FrauBluher/ShR2/Hardware/Images/rer.jpg

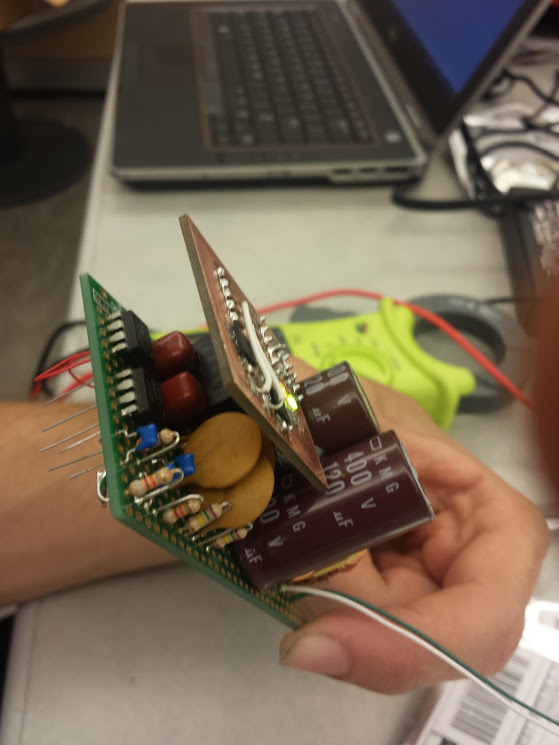
Hardware/Images/rer.jpg
