FrauBluher/ShR2/Hardware/Images/2014-04-14.jpg

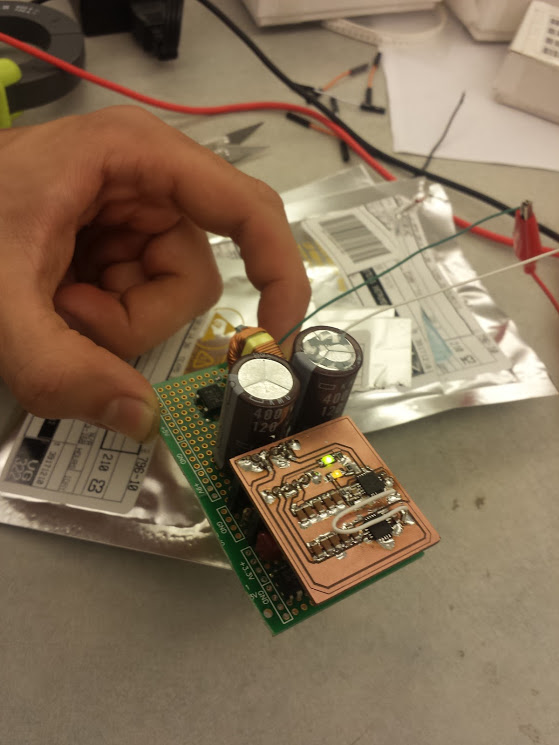
Hardware/Images/2014-04-14.jpg
