FrauBluher/ShR2/README.md

ShR2
====

A redesign of the SHEMP system with a focus on high-bandwidth data acquisition.

Design information and supporting documentation can be found in this repository.
