FrauBluher/ShR2/F28377D/README.md

F28377D projects
Note: these assume that you install the F28377D Samples (see Hardware folder)
to /opt/ti
