FrauBluher/ShR2/F28377D/base/README.md

Base project for F28377D

CPU1:
Prints Hello UART via the USB UART every 500ms.
Mirrors what it receives from the UART. 

CPU2:
Blinks the on-board LEDs alternating which one is on every 250ms.
