FrauBluher/ShR2/Hardware/Filtering/AnalogFilteringReview/README

I've included some useful application notes which
give a very nice discussion and overview of filtering
methods and how they behave in real world applications,
if you feel as though you need a quick brush-up.

-Pavlo Manovi
