FrauBluher/ShR2/ESP8266/ESP8266_SDK/uart_rxtx_PROJECT/README.md

Steps to compile, and flash this program on the ESP8266:

1. ./gen_misc to compile
2. ./upload_flash.sh to flash device
