FrauBluher/ShR2/ESP8266/Server_Transmission_Notes/Wifi State Machine.bmp

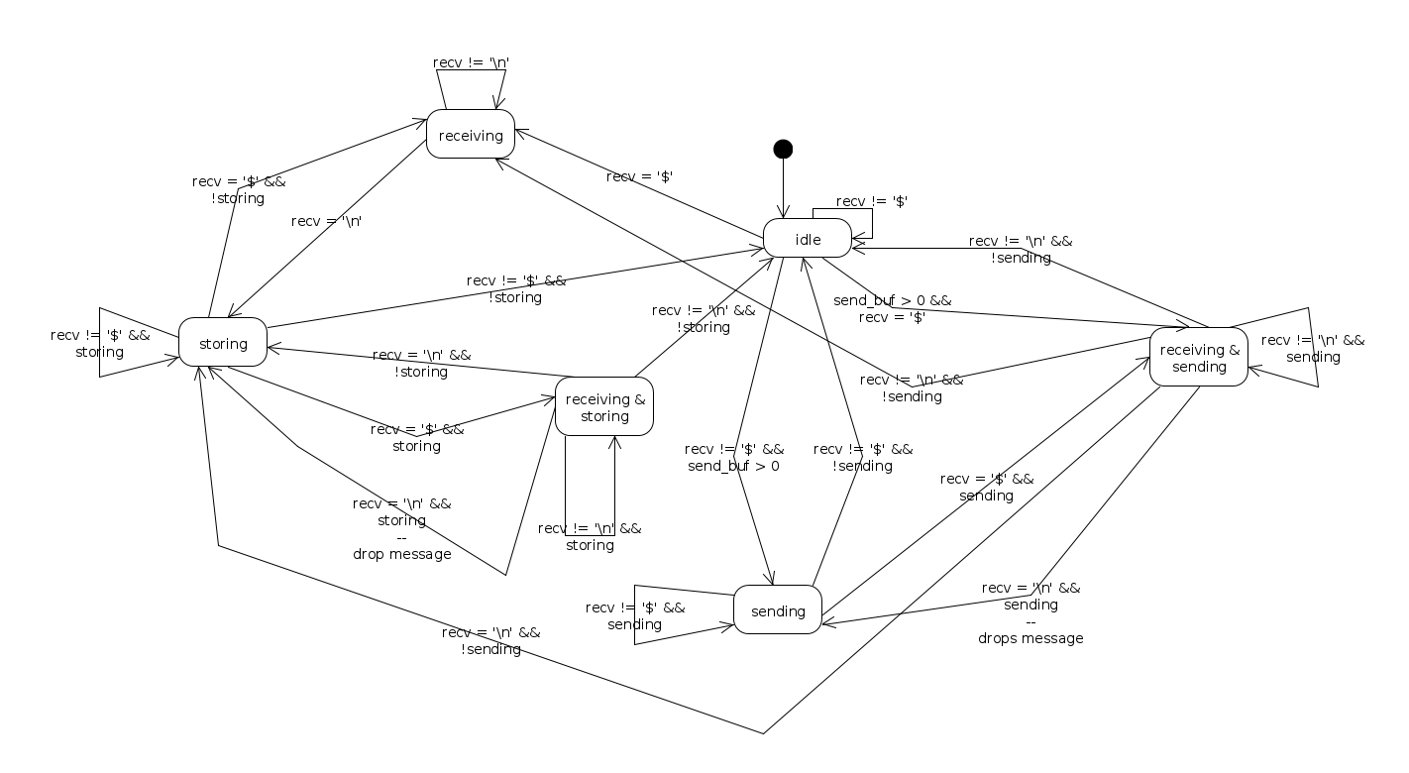
ESP8266/Server_Transmission_Notes/Wifi State Machine.bmp
