FrauBluher/ShR2/Hardware/Filtering/SPICE Simulations/Frequency and Phase Response.png

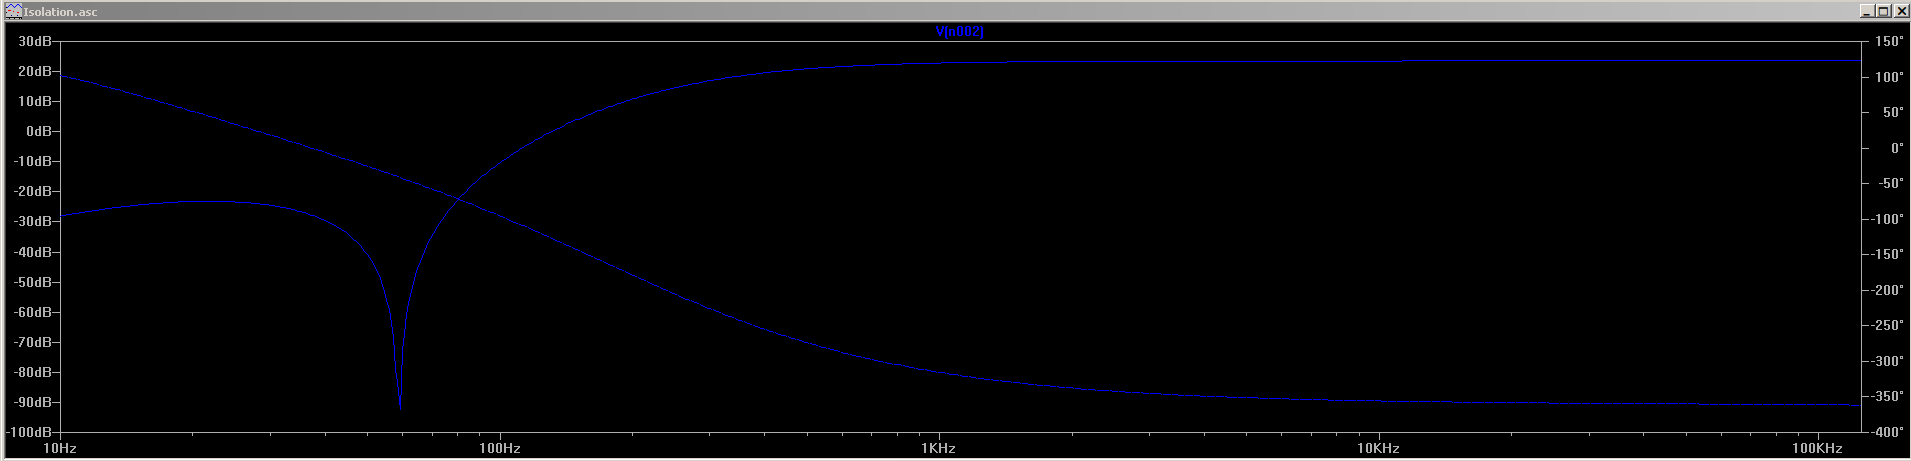
Hardware/Filtering/SPICE Simulations/Frequency and Phase Response.png
