FrauBluher/ShR2/Hardware/Images/ADCAnalysis_01.png

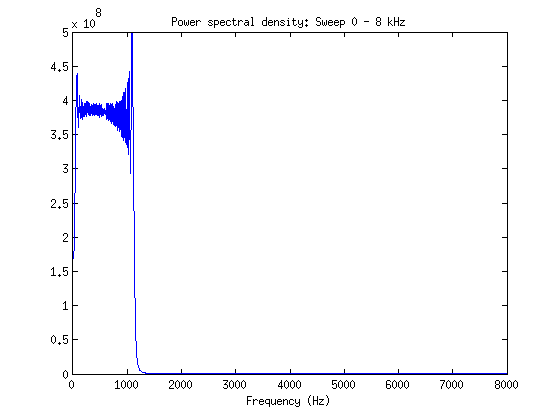
Hardware/Images/ADCAnalysis_01.png
