FrauBluher/ShR2/Hardware/Images/ADCAnalysis_03.png

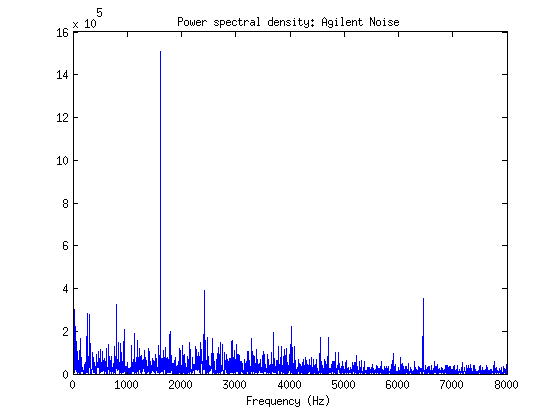
Hardware/Images/ADCAnalysis_03.png
