FrauBluher/ShR2/Hardware/Images/ADCBreakout.png

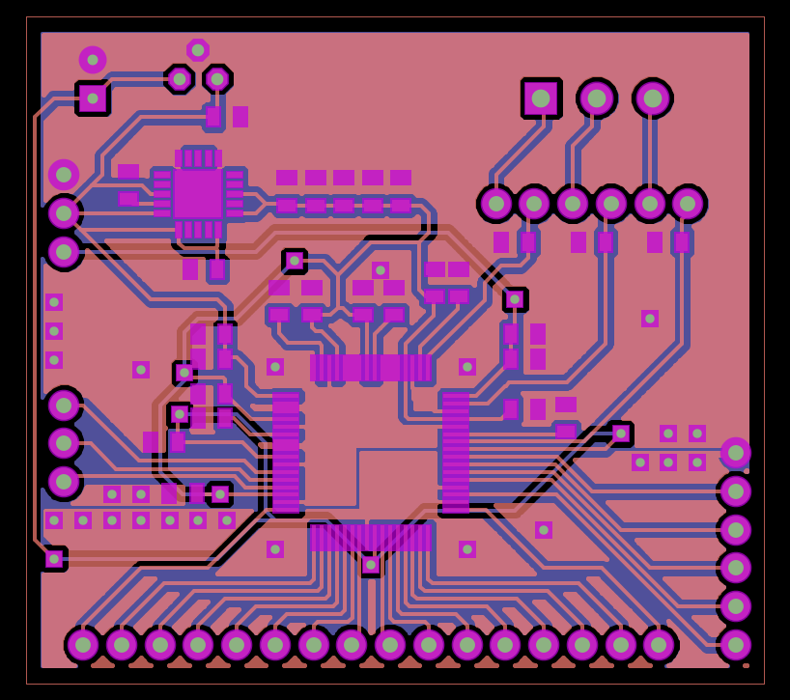
Hardware/Images/ADCBreakout.png
