FrauBluher/ShR2/Hardware/Images/ADCModule.png

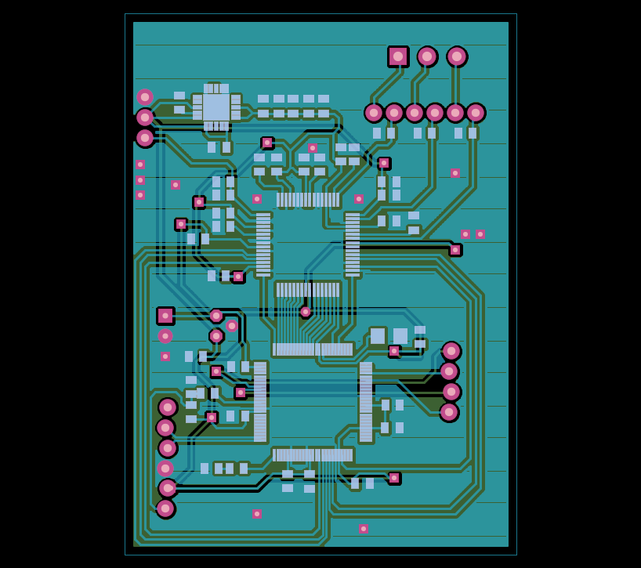
Hardware/Images/ADCModule.png
