FrauBluher/ShR2/Hardware/Images/CTExWork/SampledCTData.png

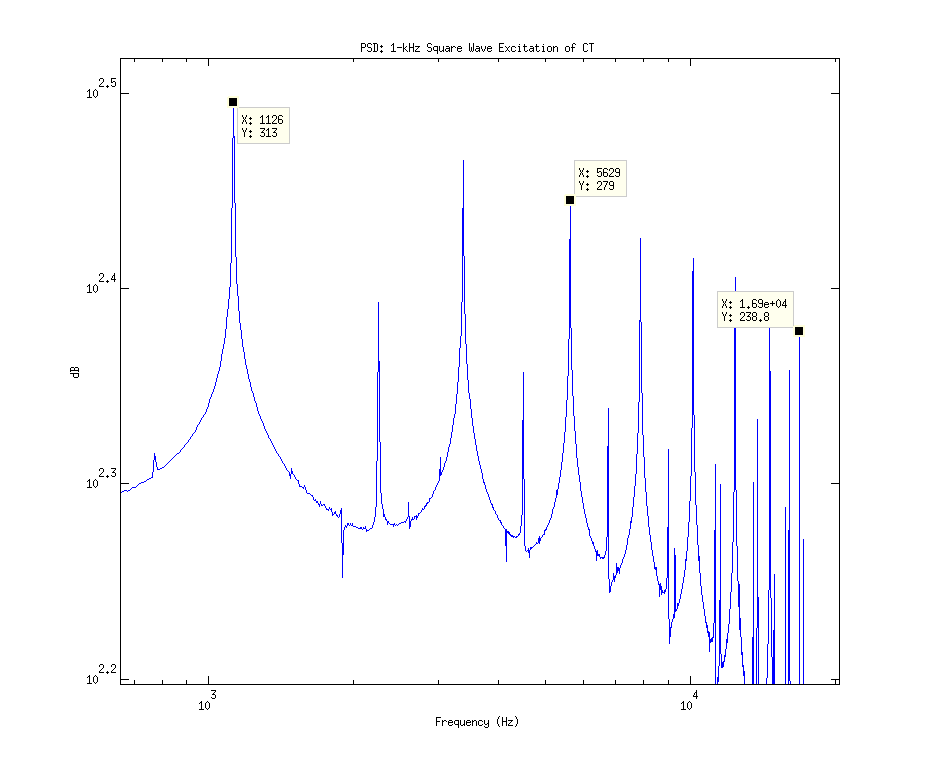
Hardware/Images/CTExWork/SampledCTData.png
