FrauBluher/ShR2/Hardware/Images/CTExWork/SquareSweep.png

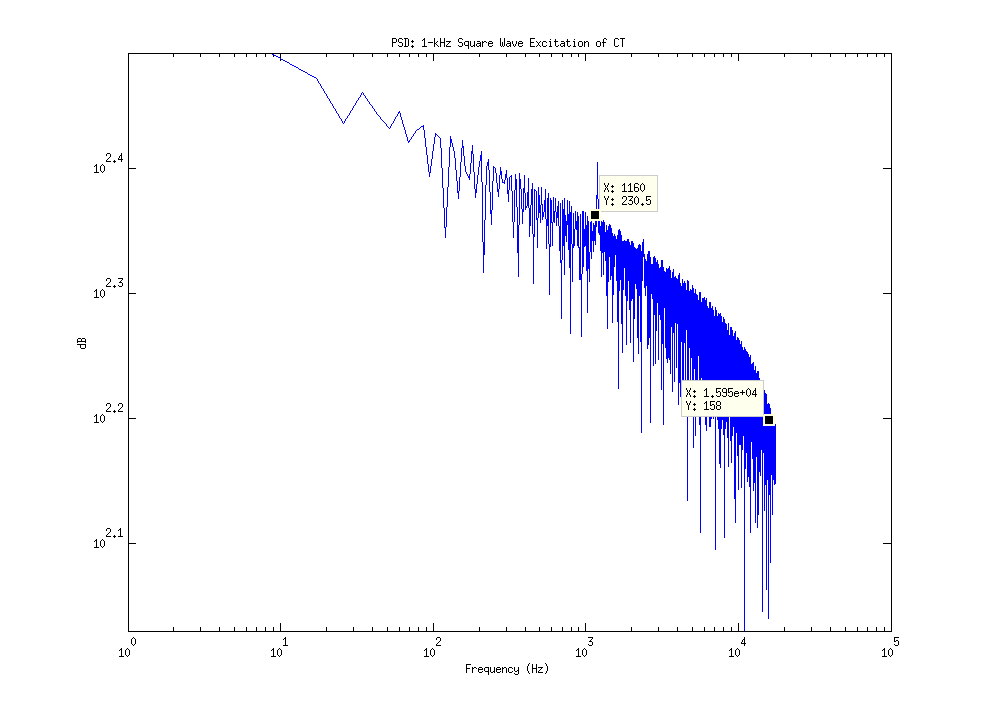
Hardware/Images/CTExWork/SquareSweep.png
