FrauBluher/ShR2/Hardware/Images/CTExWork/SquareSweepFast.png

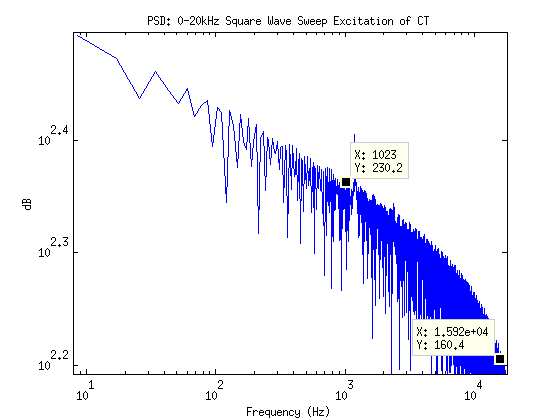
Hardware/Images/CTExWork/SquareSweepFast.png
