FrauBluher/ShR2/Hardware/Images/CTExWork/tek00000.png

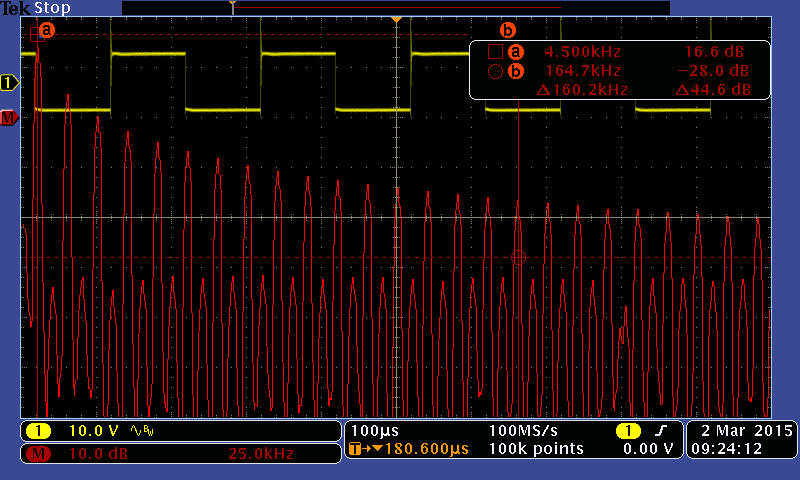
Hardware/Images/CTExWork/tek00000.png
