FrauBluher/ShR2/Hardware/Images/CTExWork/tek0000.png

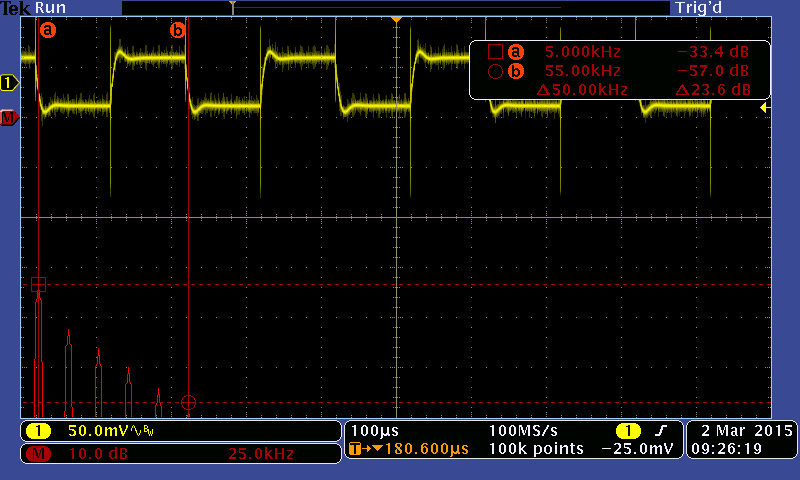
Hardware/Images/CTExWork/tek0000.png
