FrauBluher/ShR2/Hardware/Images/CTExWork/tek00002.png

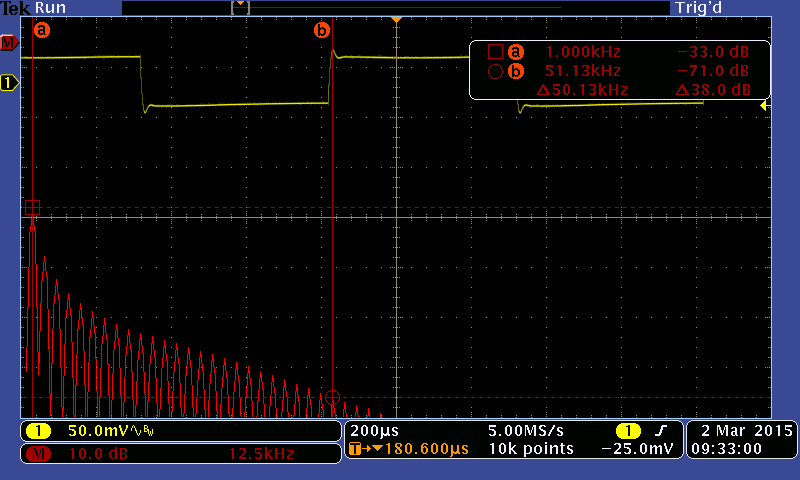
Hardware/Images/CTExWork/tek00002.png
