FrauBluher/ShR2/Hardware/Images/CTExWork/tek00003.png

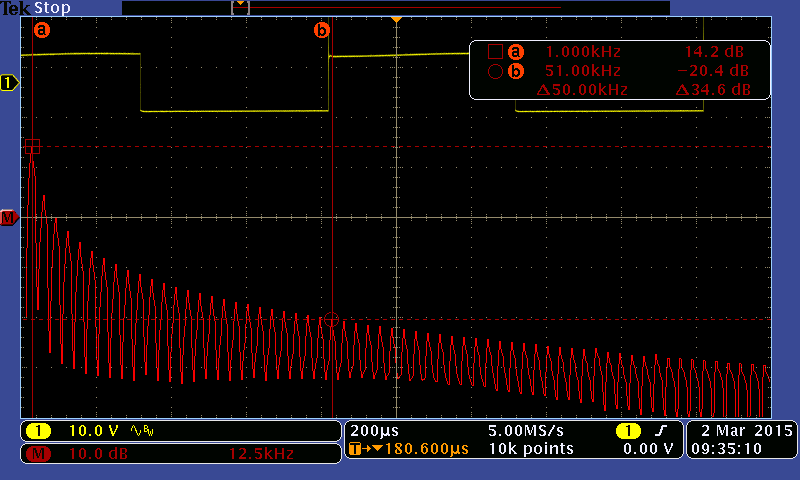
Hardware/Images/CTExWork/tek00003.png
