FrauBluher/ShR2/Hardware/Images/oscillator.png

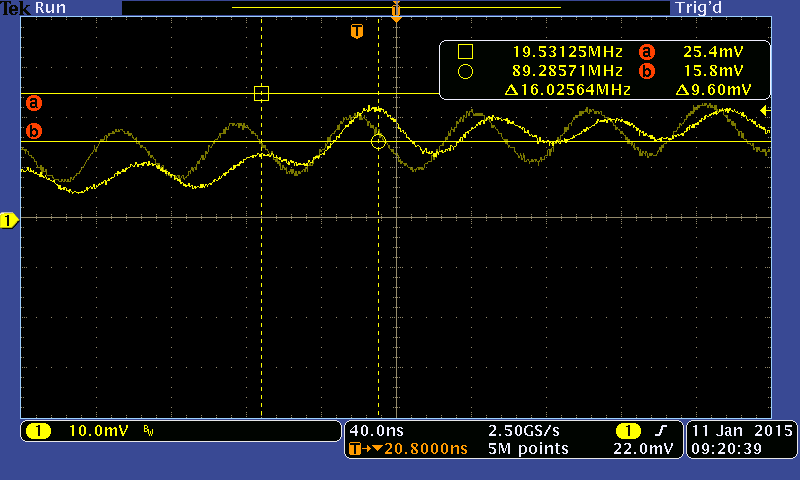
Hardware/Images/oscillator.png
