FrauBluher/ShR2/Hardware/Images/PowerSupply.png

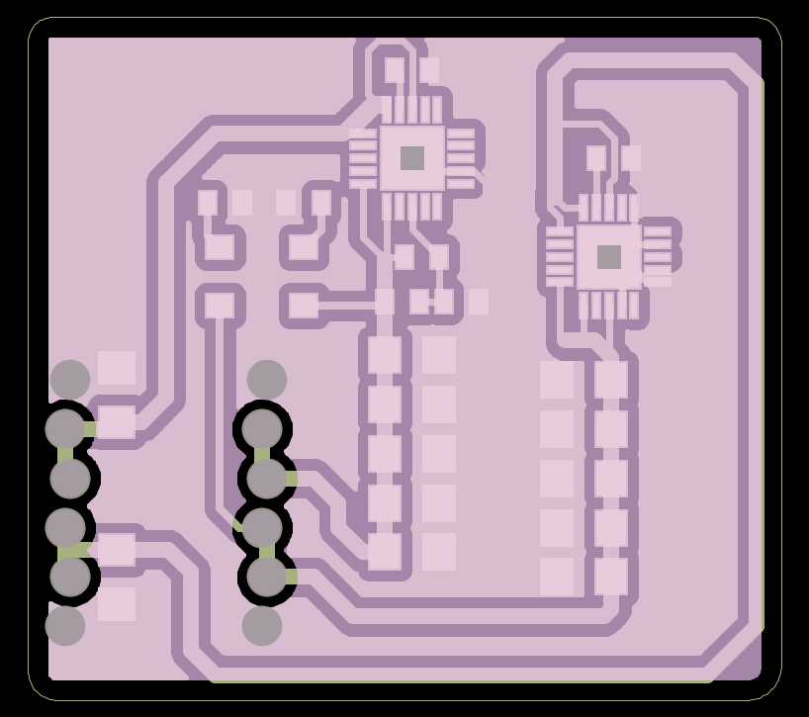
Hardware/Images/PowerSupply.png
