FrauBluher/ShR2/Hardware/Images/spi.png

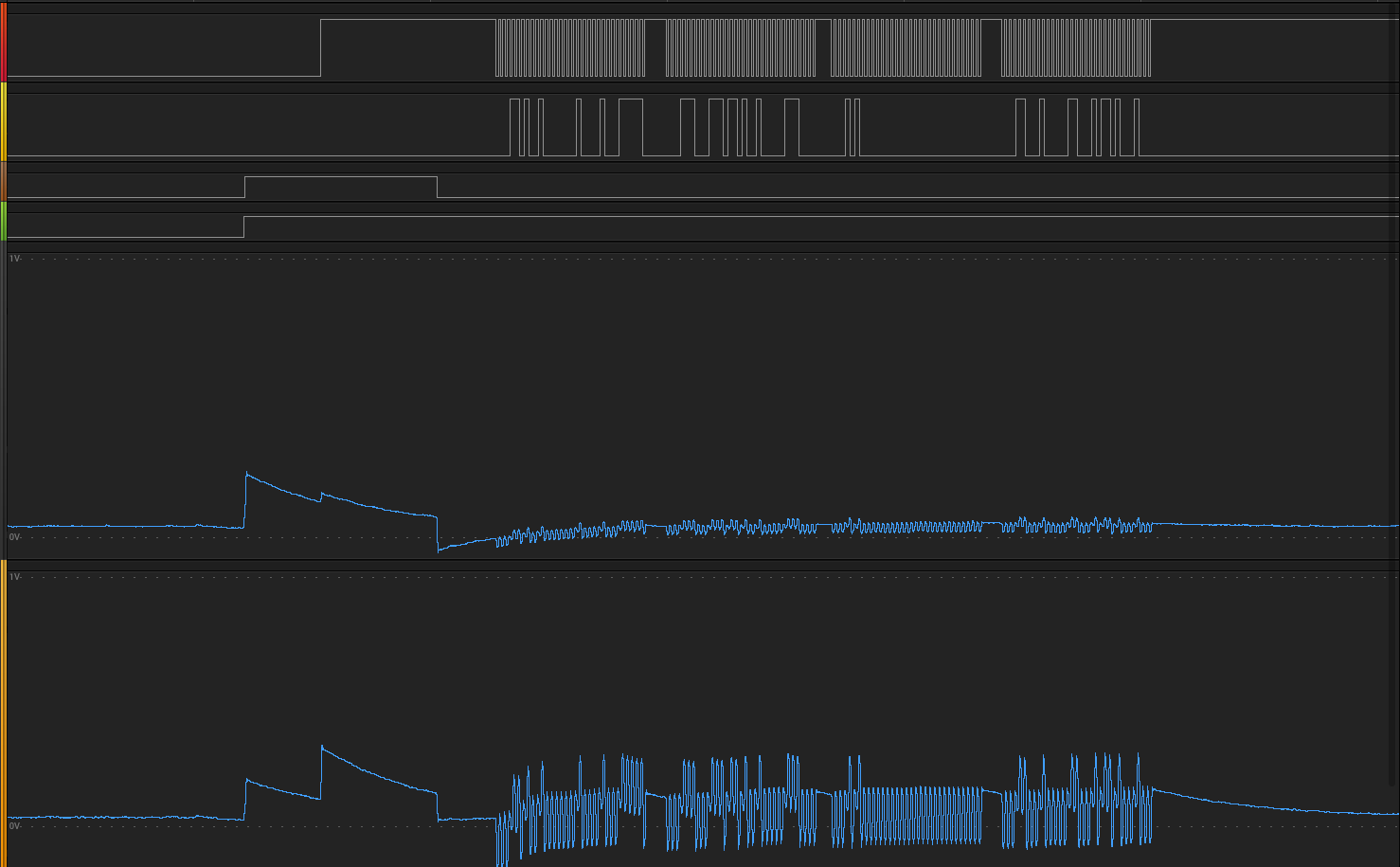
Hardware/Images/spi.png
