FrauBluher/ShR2/Hardware/Images/spisniff1.png

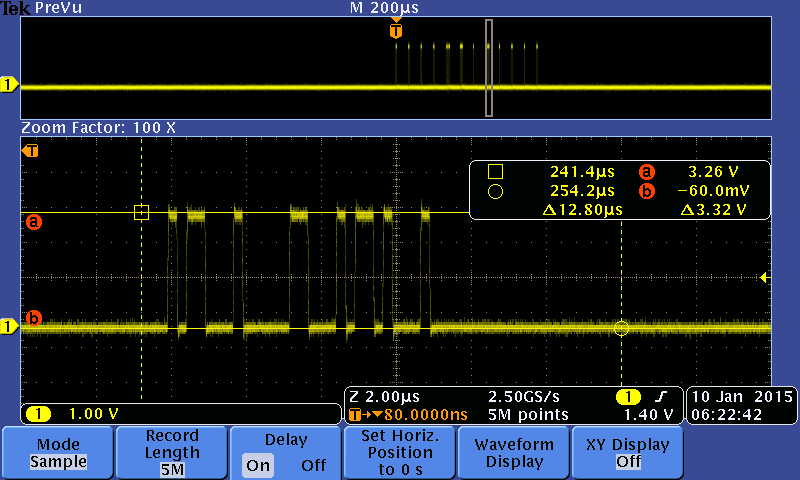
Hardware/Images/spisniff1.png
