FrauBluher/ShR2/Hardware/Images/spisniff2.png

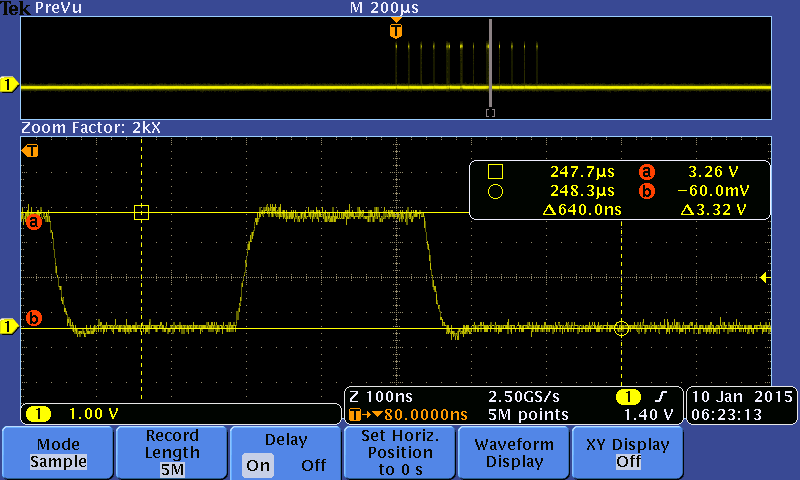
Hardware/Images/spisniff2.png
