FrauBluher/ShR2/Hardware/Images/working.png

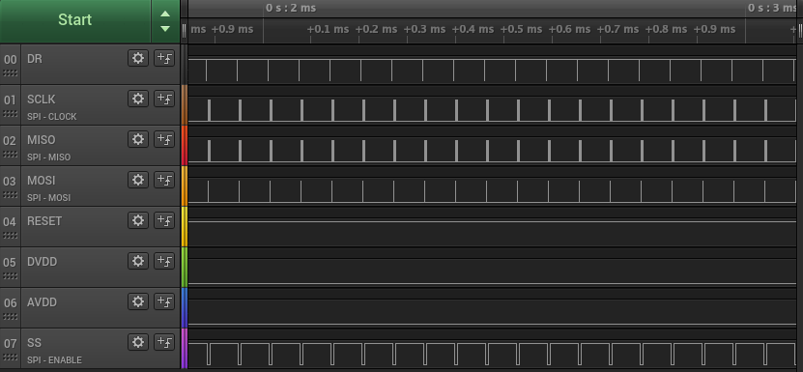
Hardware/Images/working.png
