FrauBluher/ShR2/Hardware/PIC32 Based Hardware/Datasheets/BCRord6.jpg

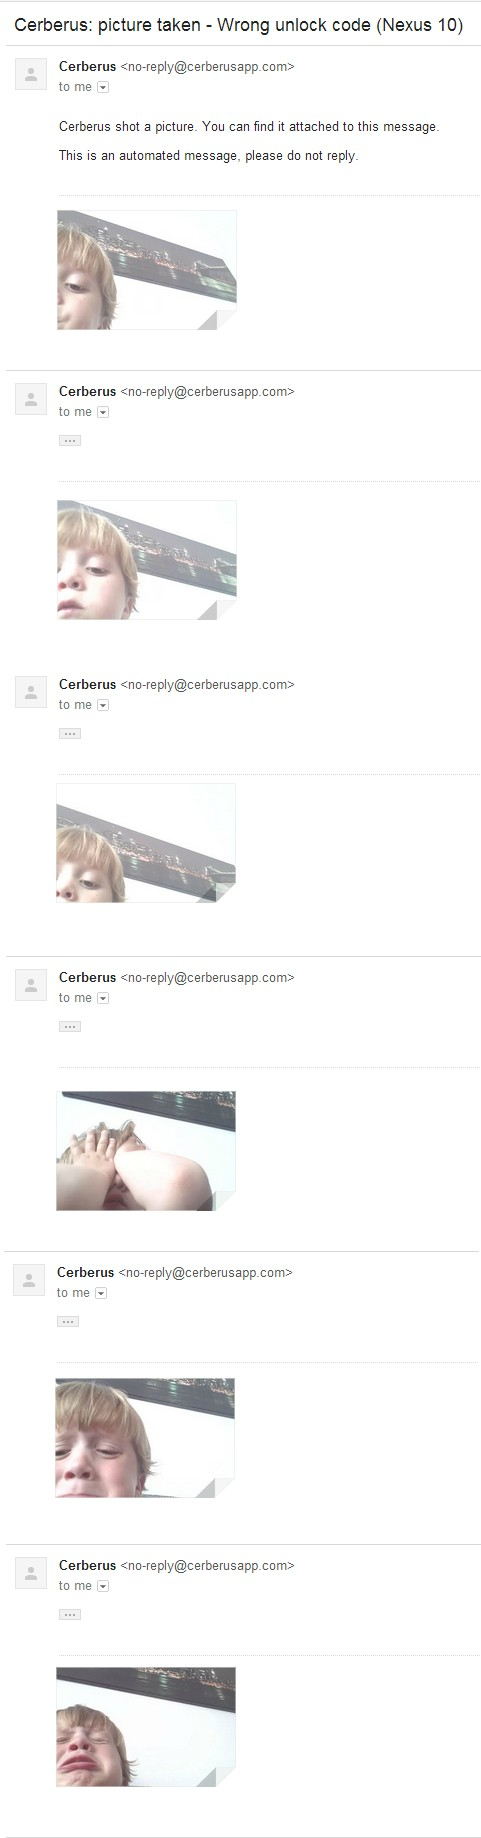
Hardware/PIC32 Based Hardware/Datasheets/BCRord6.jpg
