FrauBluher/ShR2/Hardware/PIC32 Based Hardware/Datasheets/GfTWLOs.png

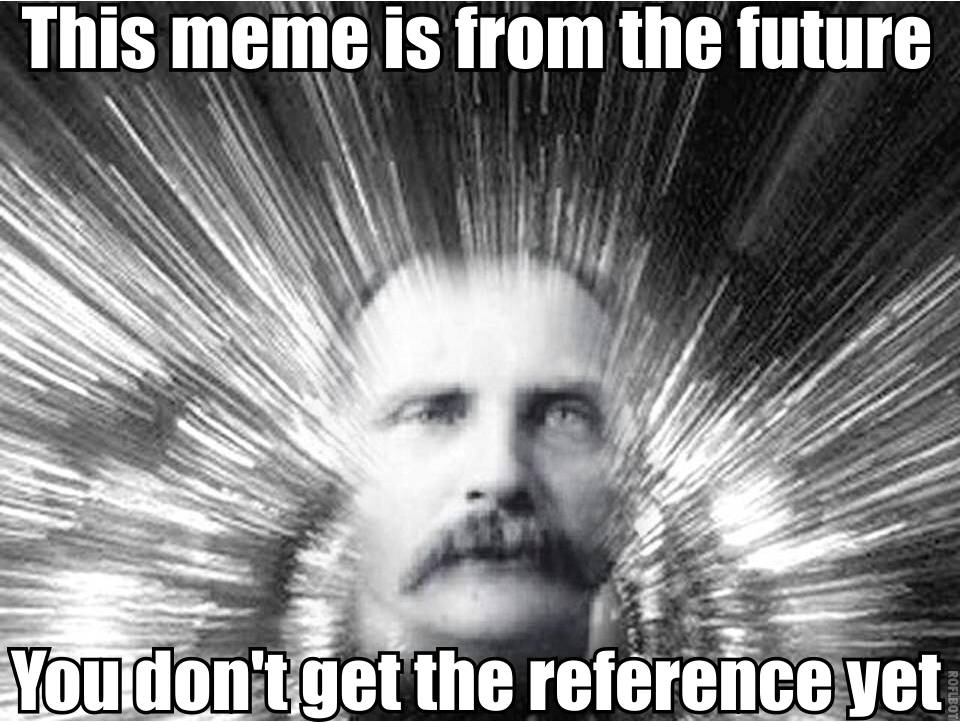
Hardware/PIC32 Based Hardware/Datasheets/GfTWLOs.png
