FrauBluher/ShR2/SEADS 3D Stuff/Quarter/50_states_quarter_obv_large.jpg

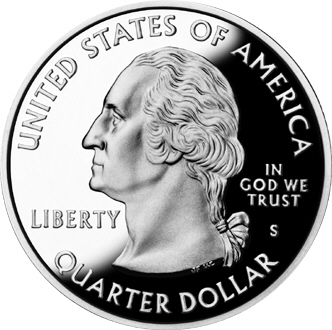
SEADS 3D Stuff/Quarter/50_states_quarter_obv_large.jpg
