FrauBluher/ShR2/SEADS 3D Stuff/Quarter/600px-Colorado_quarter,_reverse_side,_2006.jpg

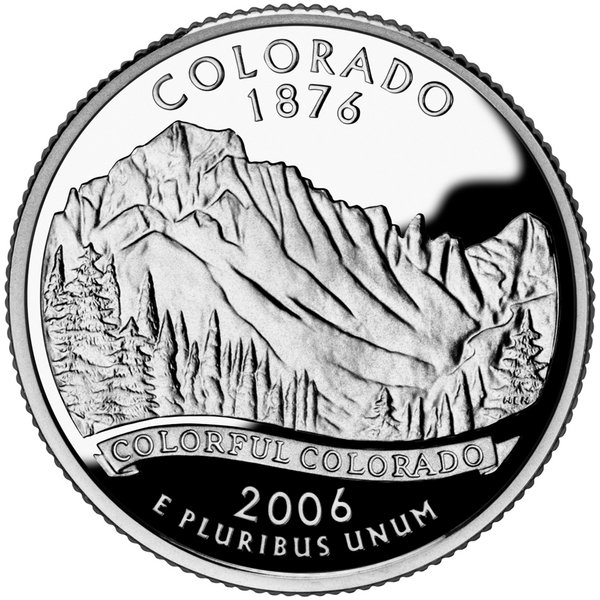
SEADS 3D Stuff/Quarter/600px-Colorado_quarter,_reverse_side,_2006.jpg
