FrauBluher/ShR2/SEADS 3D Stuff/Renders/sead.png

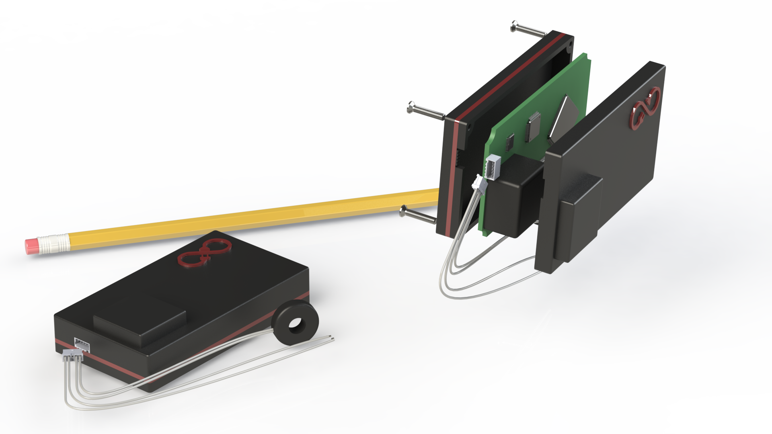
SEADS 3D Stuff/Renders/sead.png
