FrauBluher/ShR2/SEADS 3D Stuff/Renders/seadsThink.JPG

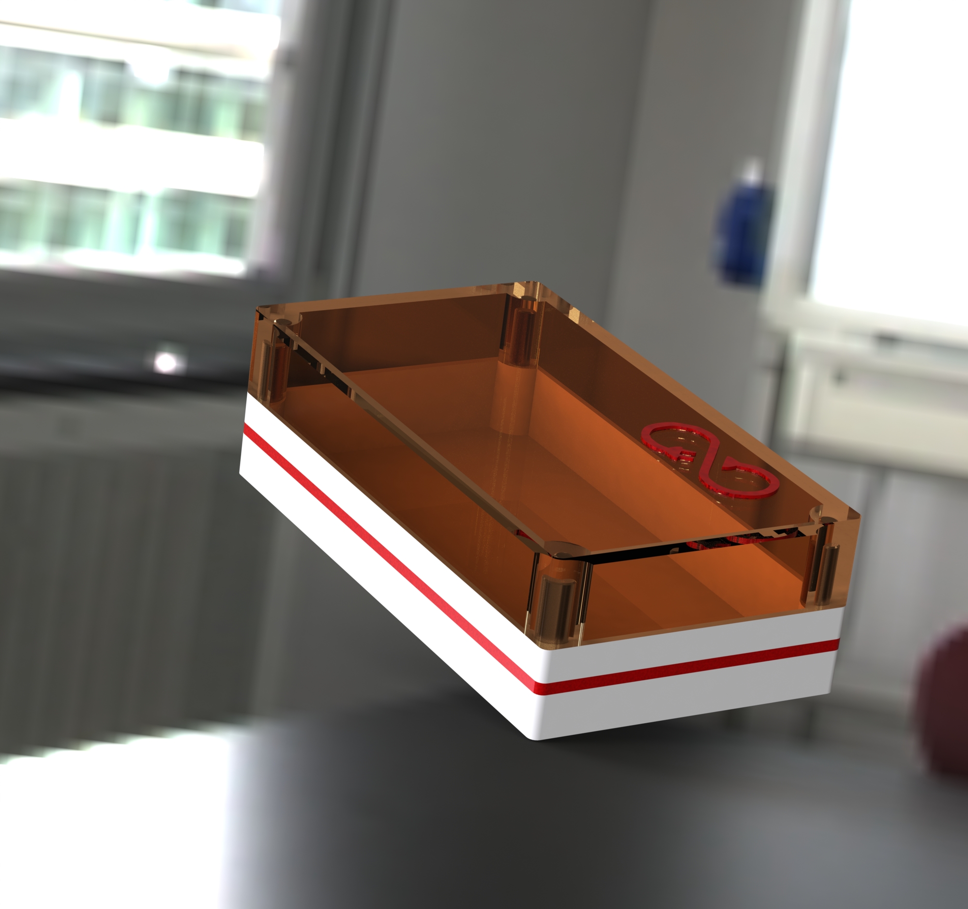
SEADS 3D Stuff/Renders/seadsThink.JPG
