FrauBluher/ShR2/Web Stack/outfile.png

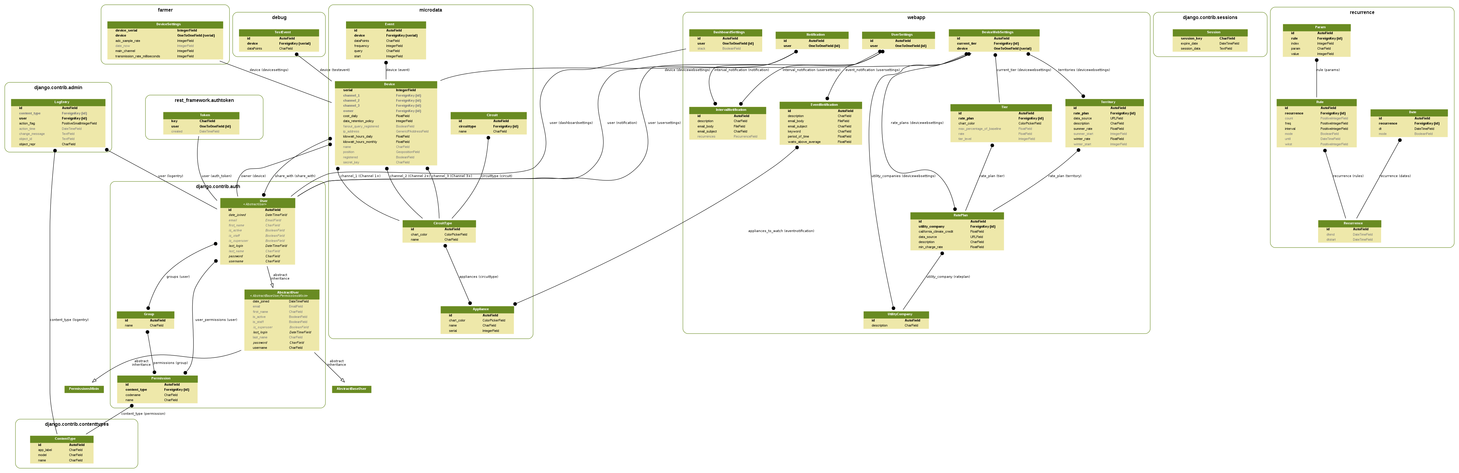
Web Stack/outfile.png
