FrauBluher/ShR2/Project Files/281-budget.xlsx

Quarter A |  |  |  | Quarter B, C
Estimated Budget | $1,253.60 |  | Members |  |  |  | Actual Total |  | 20.95
 |  |  | Henry Crute
 |  |  | Pavlo Manovi
Funding Sources | Amount |  | Bryan Smith | Amount Used | Remaining
CITRIS | $853.60 |  | AJ Ringer | $- | #VALUE!
Individual | 400 |  |  | $- | #VALUE!
 |  |  |  | $- | #VALUE!
Total Funds | $1,253.60 |  |  | $- | $1,253.60
Item Description | PPU | QTY | Estimated Cost | Funding Source | Date | Purchaser | A QTY | Actual Cost | Notes
PCB Runs | 150 | 4 | 600 | CITRIS
Passive Circuit Components | 150 | 1 | 150 | CITRIS
ESP8266 | 5 | 5 | 25 | Individual | 2015-01-06 | Henry | 6 | 20.95
Mounting Hardware | 15 | 1 | 15 | Individual
3d printing filament | 20 | 1 | 20 | CITRIS
Amazon EC2 Server for 1 hour | 0.14 | 240 | 33.6 | CITRIS
Delfino Dual Core DSP | 25 | 3 | 75 | Individual
AC/DC Regulation Components | 100 | 1 | 100 | CITRIS
Current Transformers | 5 | 12 | 60 | CITRIS
Demonstration Hardware (Conduits, Wiring, Etc.) | 75 | 1 | 75 | CITRIS
AC/AC Isolation Transformers | 100 | 1 | 100 | CITRIS
 |  |  |  | Totals | User | Amount
