FrauBluher/ShR2/SEADS 3D Stuff/Case/For Rendering.SLDASM

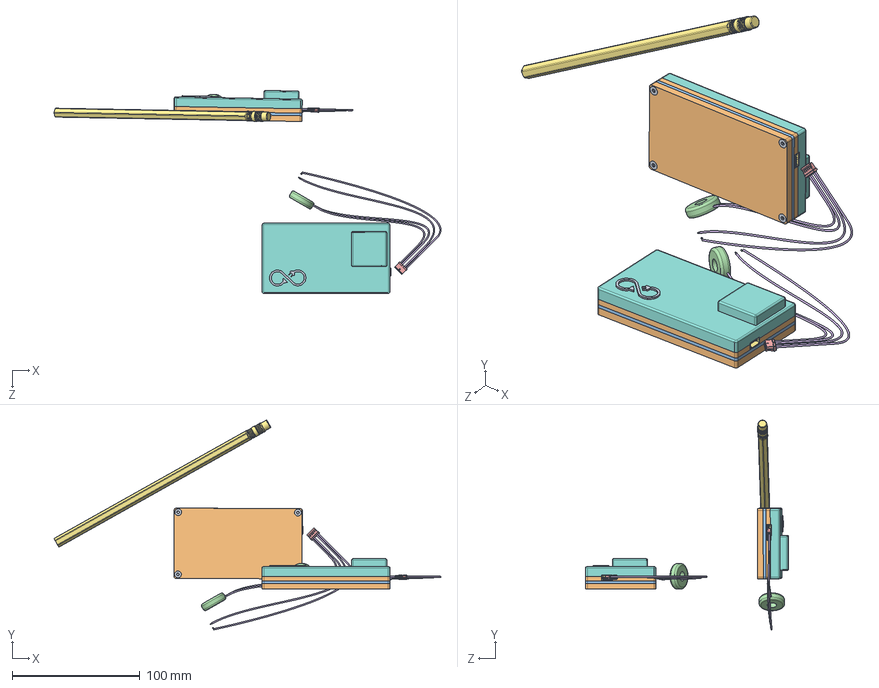
[picture p32: CAD file, 2015-01-21]
SEADS 3D Stuff/Case/For Rendering.SLDASM
302.7 x 164.1 x 158.8 mm
socket countersunk head screw_am x 8
PCB x 2
AC_DC x 2
BODY_VNG144A x 2
LEAD_VNG144A x 288
BODY_VEH64A x 2
LEAD_VEH64A x 128
BODY_MTC20 x 2
LEAD_MTC20 x 40
BODY_MXA28A x 2
LEAD_MXA28A x 56
BODY_TS5B x 2
HTSINK_TS5B x 2
LEAD_TS5B x 10
CaseTop x 2
SeadsLogo x 2
CaseBottom x 2
Case Trim x 2
CTTorus x 2
Cable_1^Electrical_9-CaseAssembly x 2
