FrauBluher/ShR2/SEADS 3D Stuff/CTAssem.SLDASM

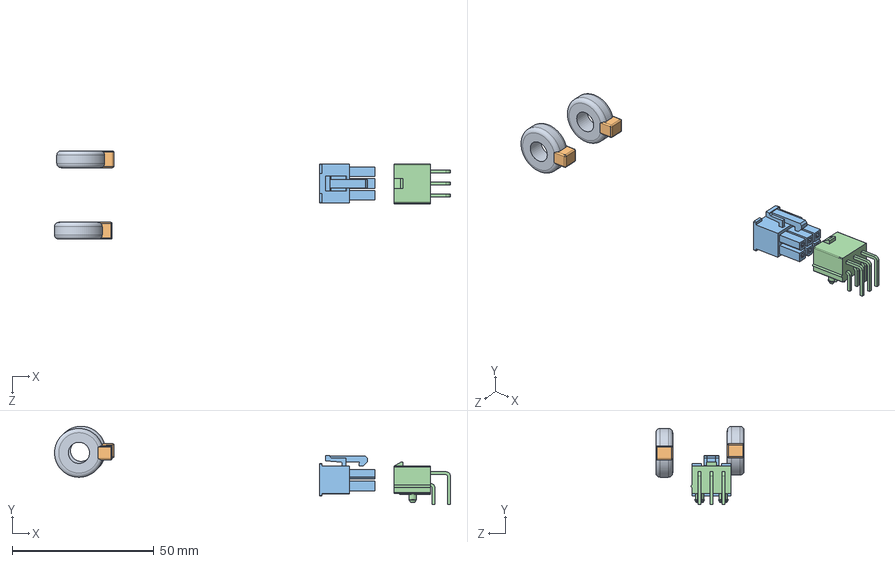
[picture p33: CAD file, 2015-01-21]
SEADS 3D Stuff/CTAssem.SLDASM
139.8 x 27.7 x 31.2 mm
CTTorus x 2
CTBlock x 2
