FrauBluher/ShR2/SEADS 3D Stuff/Case/PM0064A.SLDASM

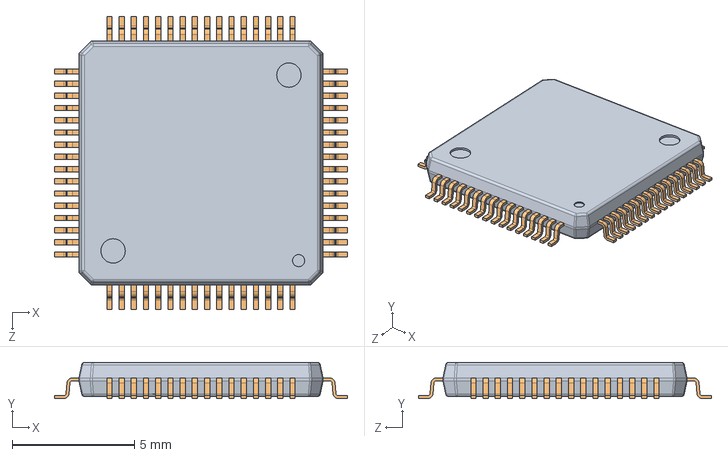
[picture p34: CAD file, 2015-01-21]
SEADS 3D Stuff/Case/PM0064A.SLDASM
12.0 x 1.49 x 12.0 mm
BODY_VEH64A
LEAD_VEH64A x 64
