FrauBluher/ShR2/SEADS 3D Stuff/Case/KTT0005B.SLDASM

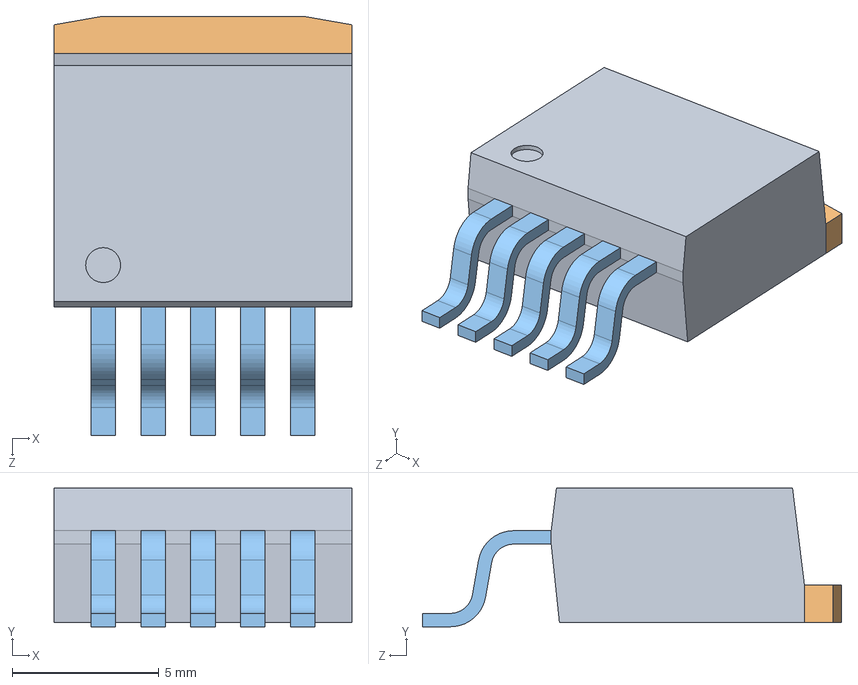
[picture p35: CAD file, 2015-01-21]
SEADS 3D Stuff/Case/KTT0005B.SLDASM
10.2 x 4.72 x 14.3 mm
BODY_TS5B
HTSINK_TS5B
LEAD_TS5B x 5
