FrauBluher/ShR2/SEADS 3D Stuff/Case/PGE0144A.SLDASM

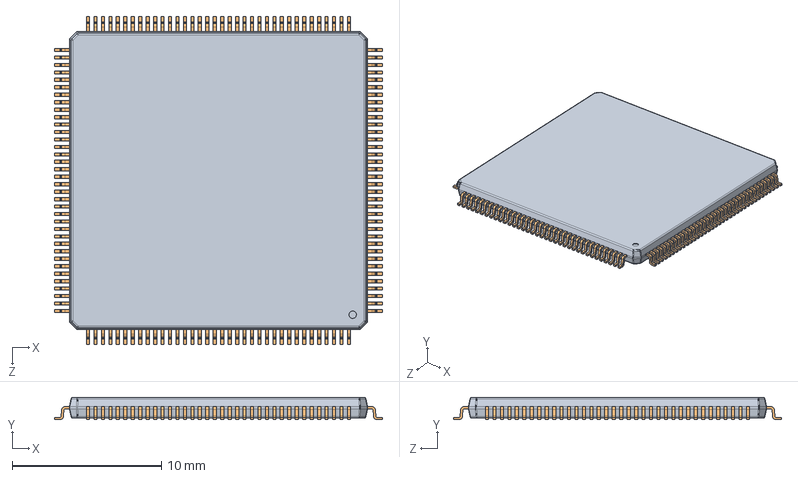
[picture p36: CAD file, 2015-01-21]
SEADS 3D Stuff/Case/PGE0144A.SLDASM
22.0 x 1.50 x 22.0 mm
BODY_VNG144A
LEAD_VNG144A x 144
