FrauBluher/ShR2/SEADS 3D Stuff/Case/PWP0028A.SLDASM

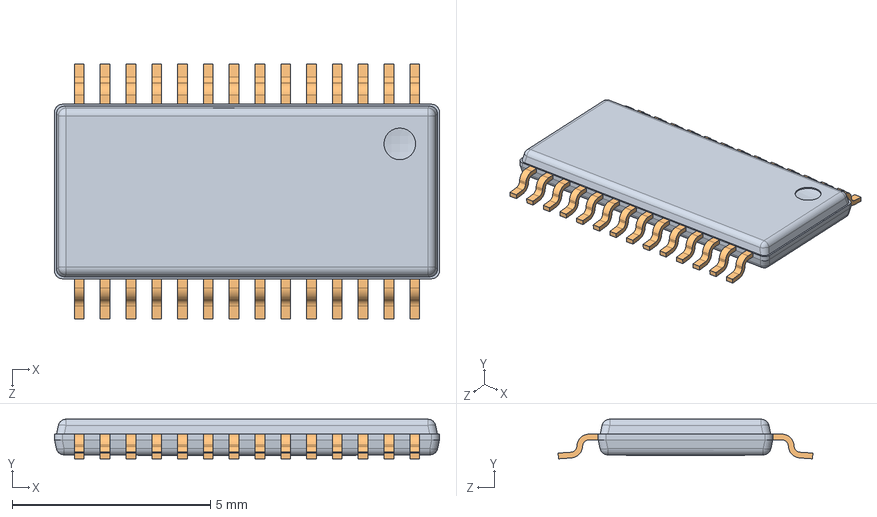
[picture p37: CAD file, 2015-01-21]
SEADS 3D Stuff/Case/PWP0028A.SLDASM
9.70 x 1.00 x 6.42 mm
BODY_MXA28A
LEAD_MXA28A x 28
