FrauBluher/ShR2/SEADS 3D Stuff/Case/PW0020A.SLDASM

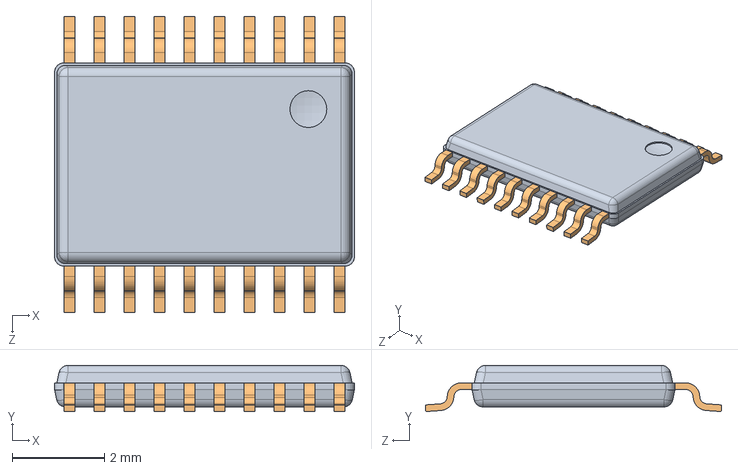
[picture p38: CAD file, 2015-01-21]
SEADS 3D Stuff/Case/PW0020A.SLDASM
6.50 x 1.00 x 6.42 mm
BODY_MTC20
LEAD_MTC20 x 20
