FrauBluher/ShR2/SEADS 3D Stuff/Case/CaseAssembly.SLDASM

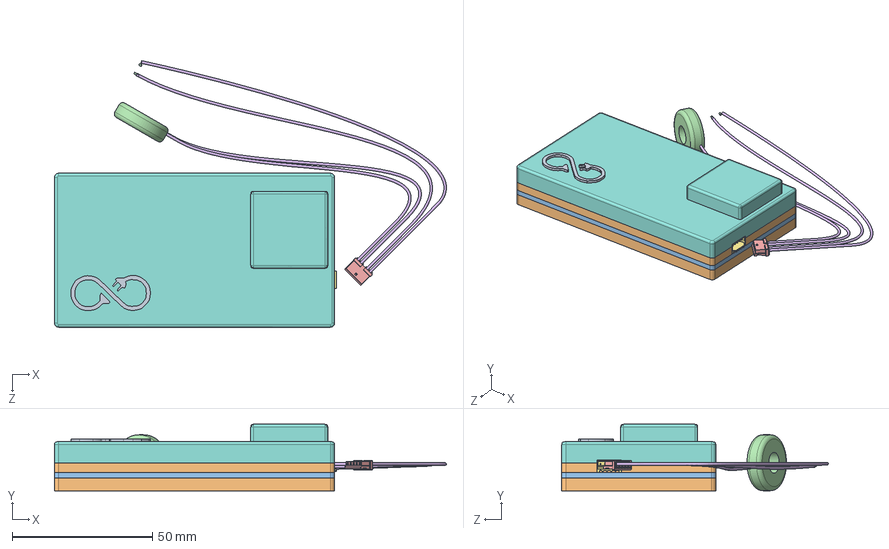
[picture p39: CAD file, 2015-01-21]
SEADS 3D Stuff/Case/CaseAssembly.SLDASM
139.9 x 23.8 x 95.1 mm
socket countersunk head screw_am x 4
PCB
AC_DC
BODY_VNG144A
LEAD_VNG144A x 144
BODY_VEH64A
LEAD_VEH64A x 64
BODY_MTC20
LEAD_MTC20 x 20
BODY_MXA28A
LEAD_MXA28A x 28
BODY_TS5B
HTSINK_TS5B
LEAD_TS5B x 5
CaseTop
SeadsLogo
CaseBottom
Case Trim
CTTorus
Cable_1^Electrical_9-CaseAssembly
