FrauBluher/ShR2/SEADS 3D Stuff/Quarter/US Quarter.SLDPRT

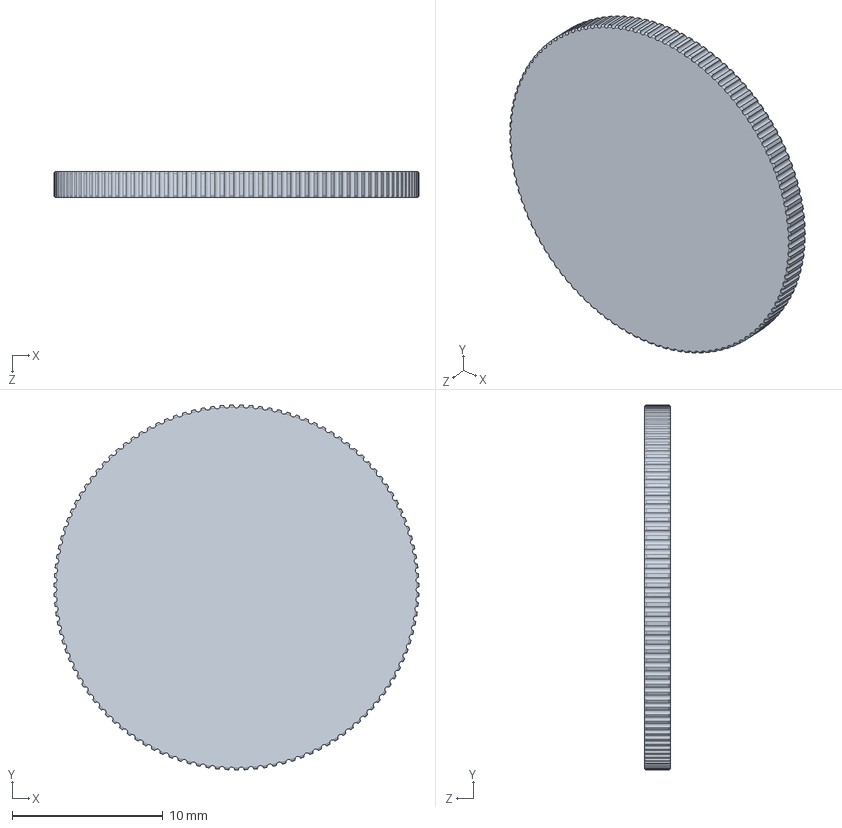
[picture p40: CAD file, 2015-01-21]
SEADS 3D Stuff/Quarter/US Quarter.SLDPRT
24.2 x 24.2 x 1.73 mm
