FrauBluher/ShR2/SEADS 3D Stuff/PCB.SLDPRT

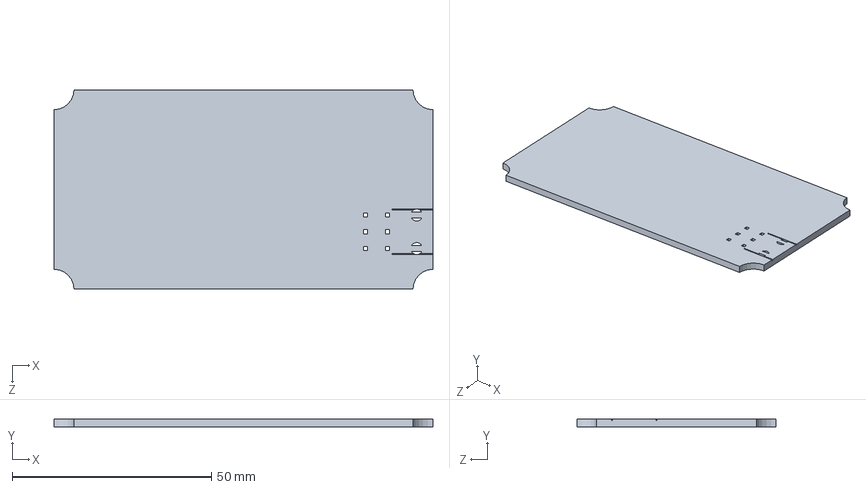
[picture p41: CAD file, 2015-01-21]
SEADS 3D Stuff/PCB.SLDPRT
95.0 x 2.00 x 50.0 mm
