FrauBluher/ShR2/SEADS 3D Stuff/Wood Pencil- Unsharpened.SLDPRT

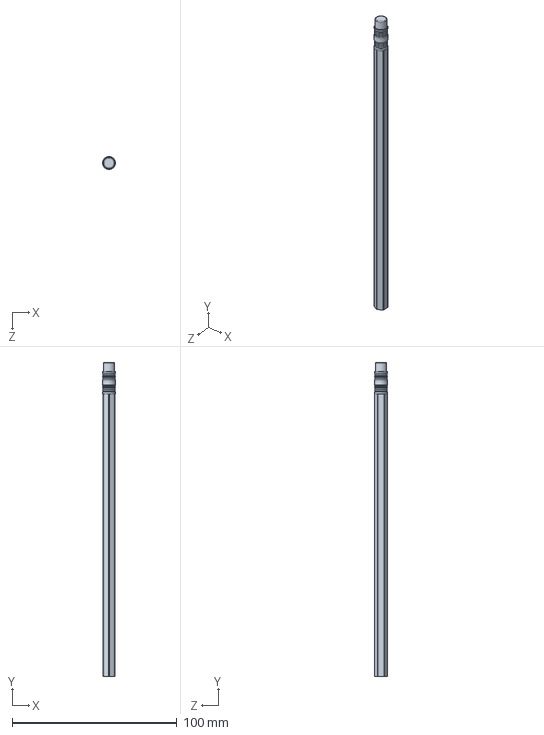
[picture p42: CAD file, 2015-01-21]
SEADS 3D Stuff/Wood Pencil- Unsharpened.SLDPRT
7.87 x 190.5 x 7.87 mm
