FrauBluher/ShR2/SEADS 3D Stuff/CTTorus.SLDPRT

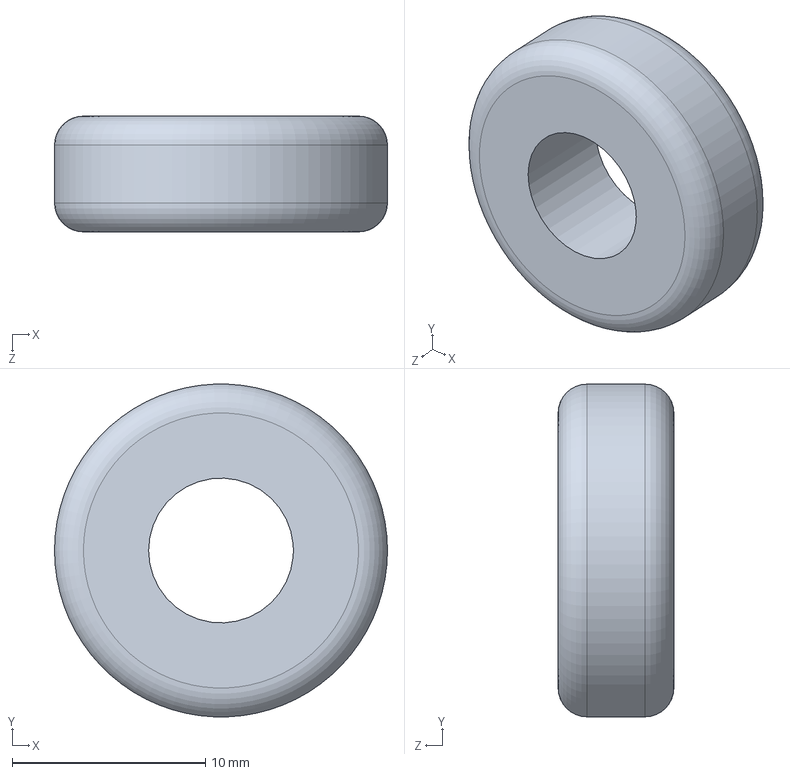
[picture p43: CAD file, 2015-01-21]
SEADS 3D Stuff/CTTorus.SLDPRT
17.2 x 17.2 x 6.00 mm
