FrauBluher/ShR2/SEADS 3D Stuff/AC_DC.SLDPRT

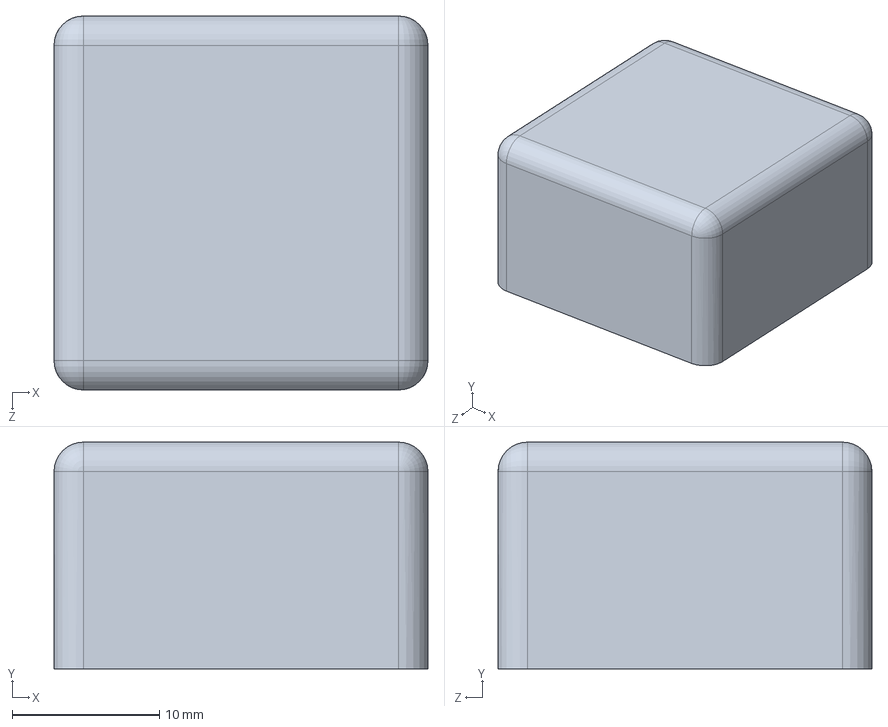
[picture p44: CAD file, 2015-01-21]
SEADS 3D Stuff/AC_DC.SLDPRT
25.4 x 15.4 x 25.4 mm
