FrauBluher/ShR2/SEADS 3D Stuff/CTBlock.SLDPRT

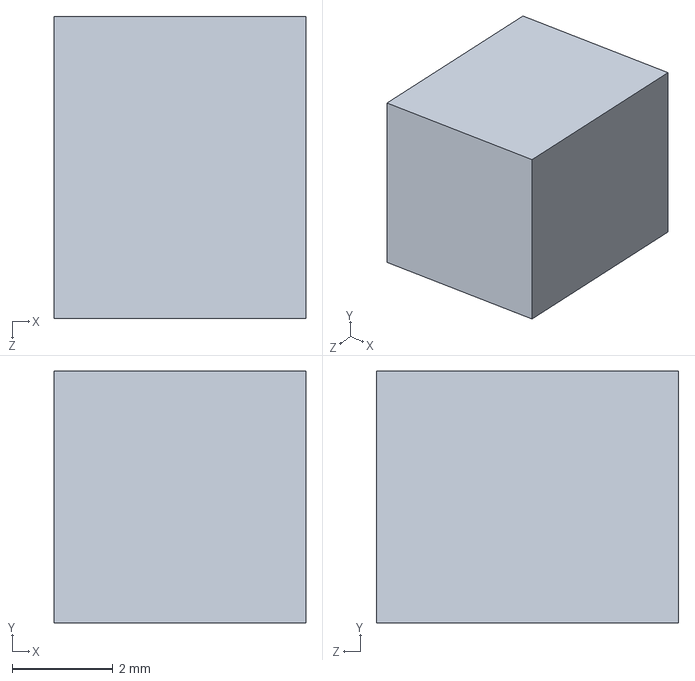
[picture p45: CAD file, 2015-01-13]
SEADS 3D Stuff/CTBlock.SLDPRT
5.00 x 5.00 x 6.00 mm
