FrauBluher/ShR2/SEADS 3D Stuff/Case/SeadsLogo.SLDPRT

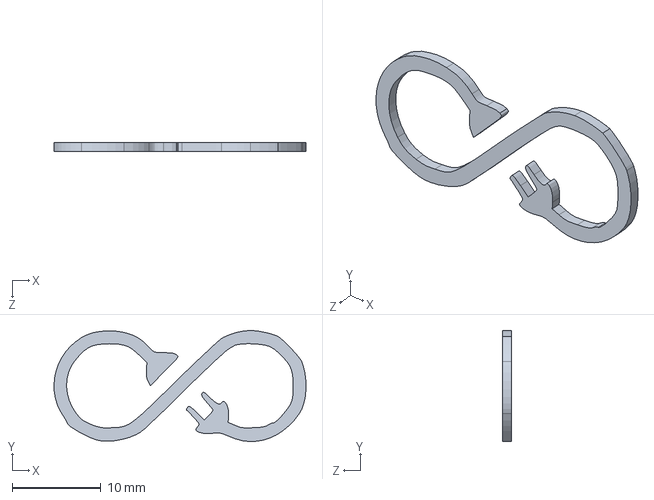
[picture p46: CAD file, 2015-01-21]
SEADS 3D Stuff/Case/SeadsLogo.SLDPRT
28.4 x 12.5 x 1.00 mm
