FrauBluher/ShR2/SEADS 3D Stuff/Case/CaseBottom.SLDPRT

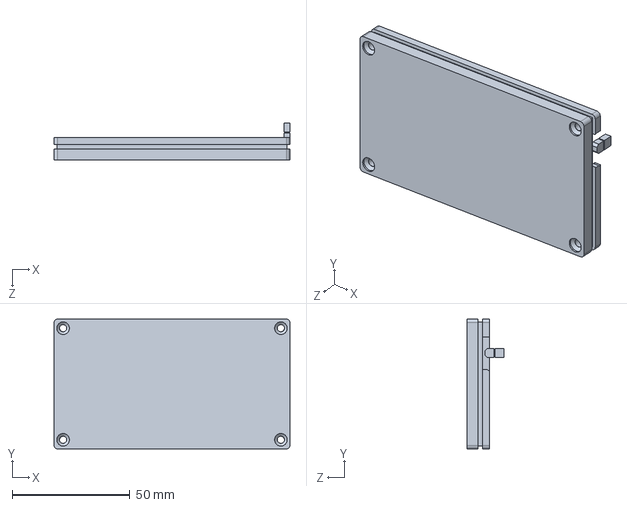
[picture p47: CAD file, 2015-01-21]
SEADS 3D Stuff/Case/CaseBottom.SLDPRT
100.0 x 55.0 x 15.5 mm
