FrauBluher/ShR2/SEADS 3D Stuff/Case/CaseTop.SLDPRT

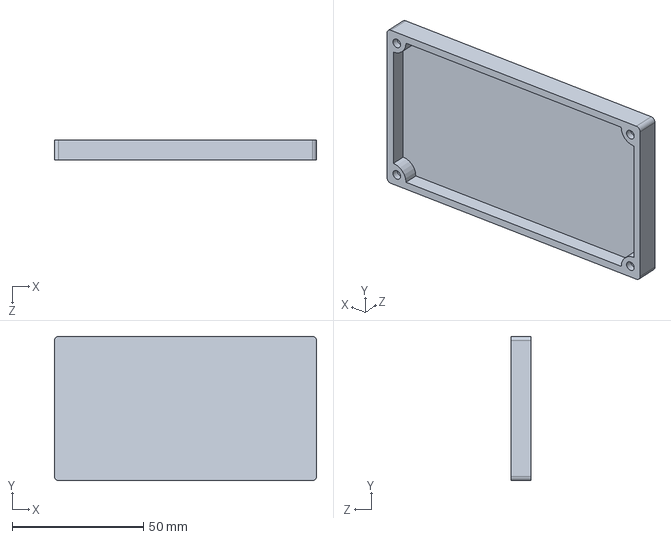
[picture p48: CAD file, 2015-01-21]
SEADS 3D Stuff/Case/CaseTop.SLDPRT
100.0 x 55.0 x 7.50 mm
