FrauBluher/ShR2/SEADS 3D Stuff/Case/Case Trim.SLDPRT

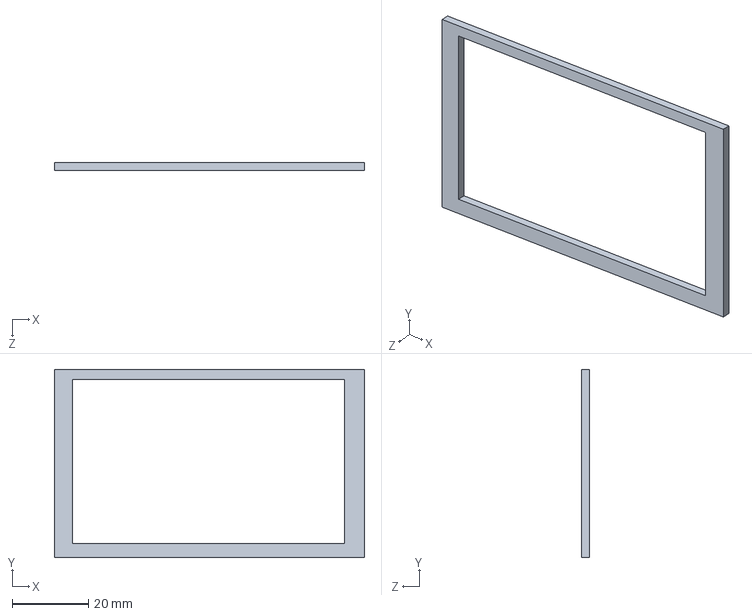
[picture p49: CAD file, 2015-01-21]
SEADS 3D Stuff/Case/Case Trim.SLDPRT
81.3 x 49.4 x 2.00 mm
