FrauBluher/ShR2/(list of files, cad)

Other CAD files:
SEADS 3D Stuff/Case/Cable_1-CaseAssembly.sldasm
SEADS 3D Stuff/Case/CaseAssemblyWiring.SLDASM
SEADS 3D Stuff/Case/Electrical_9-CaseAssembly.sldasm
SEADS 3D Stuff/Case/Cable_3-CaseAssembly.sldasm
SEADS 3D Stuff/Case/HTSINK_TS5B.sldprt
SEADS 3D Stuff/Case/BODY_VNG144A.sldprt
SEADS 3D Stuff/Case/LEAD_VEH64A.sldprt
SEADS 3D Stuff/Case/BODY_VEH64A.sldprt
SEADS 3D Stuff/Case/LEAD_TS5B.sldprt
SEADS 3D Stuff/Case/LEAD_MTC20.sldprt
SEADS 3D Stuff/Case/LEAD_MXA28A.sldprt
SEADS 3D Stuff/Case/BODY_MXA28A.sldprt
SEADS 3D Stuff/Case/BODY_TS5B.sldprt
SEADS 3D Stuff/Case/BODY_MTC20.sldprt
SEADS 3D Stuff/Case/LEAD_VNG144A.sldprt
SEADS 3D Stuff/026013116.SLDPRT
SEADS 3D Stuff/039012060.SLDPRT
SEADS 3D Stuff/430250600.SLDPRT
SEADS 3D Stuff/874380543.SLDPRT
SEADS 3D Stuff/874390500.SLDPRT
SEADS 3D Stuff/Case/CaseScrews.SLDPRT
