FrauBluher/ShR2/ESP8266/Toolchain-Builder/README.md

### For 32 or 64 bit versions of linux, builds the ESP8266 toolchain
