FrauBluher/ShR2/Hardware/Filtering/SPICE Simulations/FilteringStageTesting.txt

Freq.	V(n017)	V(n032)
1.00000000000000e+001	(-2.42064097050731e+002dB,1.45442826448928e+002°)	(1.05780758079521e+001dB,1.10897163357794e+002°)
1.02337389199677e+001	(-2.41330497973101e+002dB,1.44783667146875e+002°)	(1.04394707431486e+001dB,1.09580258252983e+002°)
1.04729412282063e+001	(-2.40599397705103e+002dB,1.44117185331439e+002°)	(1.02958619387491e+001dB,1.08248801339352e+002°)
1.07177346253629e+001	(-2.39870862903696e+002dB,1.43443558829961e+002°)	(1.01471162441489e+001dB,1.06903151578939e+002°)
1.09682497969463e+001	(-2.39144960761259e+002dB,1.42762976839473e+002°)	(9.99309945694796e+000dB,1.05543690674820e+002°)
1.12246204830937e+001	(-2.38421758982425e+002dB,1.42075639699236e+002°)	(9.83367636925786e+000dB,1.04170822607633e+002°)
1.14869835499704e+001	(-2.37701325767794e+002dB,1.41381758605960e+002°)	(9.66871080010778e+000dB,1.02784973057298e+002°)
1.17554790628361e+001	(-2.36983729805821e+002dB,1.40681555270945e+002°)	(9.49806561140429e+000dB,1.01386588708554e+002°)
1.20302503608212e+001	(-2.36269040274199e+002dB,1.39975261518909e+002°)	(9.32160270474967e+000dB,9.99761364398758e+001°)
1.23114441334492e+001	(-2.35557326852179e+002dB,1.39263118828733e+002°)	(9.13918299627091e+000dB,9.85541023963483e+001°)
1.25992104989487e+001	(-2.34848659745311e+002dB,1.38545377816921e+002°)	(8.95066636646653e+000dB,9.71209909481279e+001°)
1.28937030843958e+001	(-2.34143109724185e+002dB,1.37822297665035e+002°)	(8.75591158193187e+000dB,9.56773235371981e+001°)
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
9.93340009028285e+005	(-4.48956715463571e+001dB,-8.58731779240705e+001°)	(-1.52970024213516e+002dB,2.05286811294663e+001°)
1.00000000000000e+006	(-4.50543170523152e+001dB,-8.60579008923410e+001°)	(-1.52994478655547e+002dB,2.00138205831520e+001°)
