FrauBluher/ShR2/Hardware/Images/signal verification.jpg

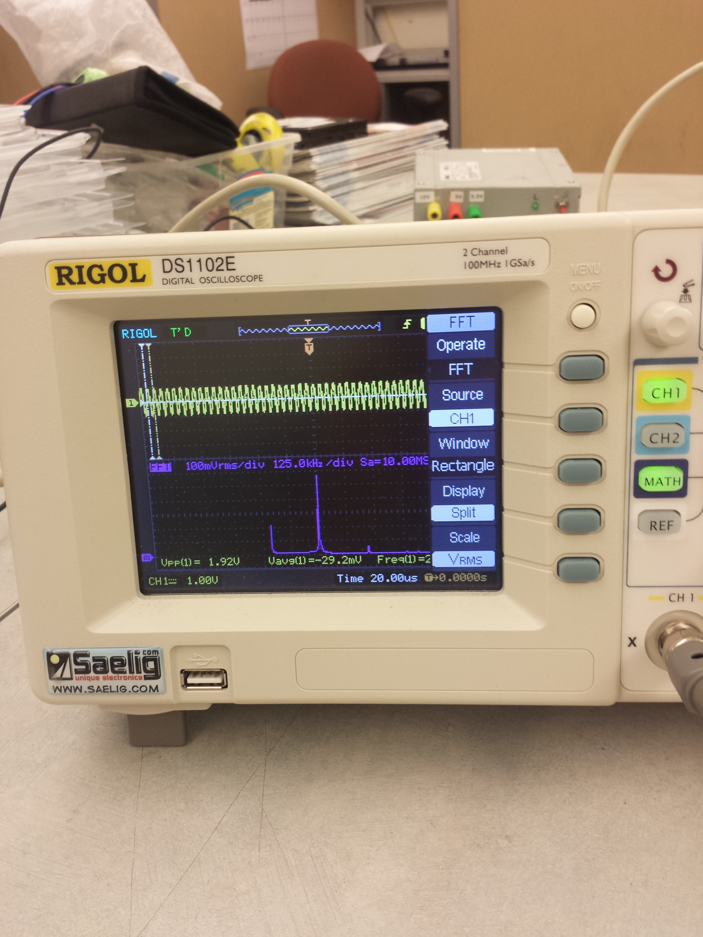
Hardware/Images/signal verification.jpg
