FrauBluher/ShR2/MATLAB Work/MCP3912 Evaluation/untitled.png

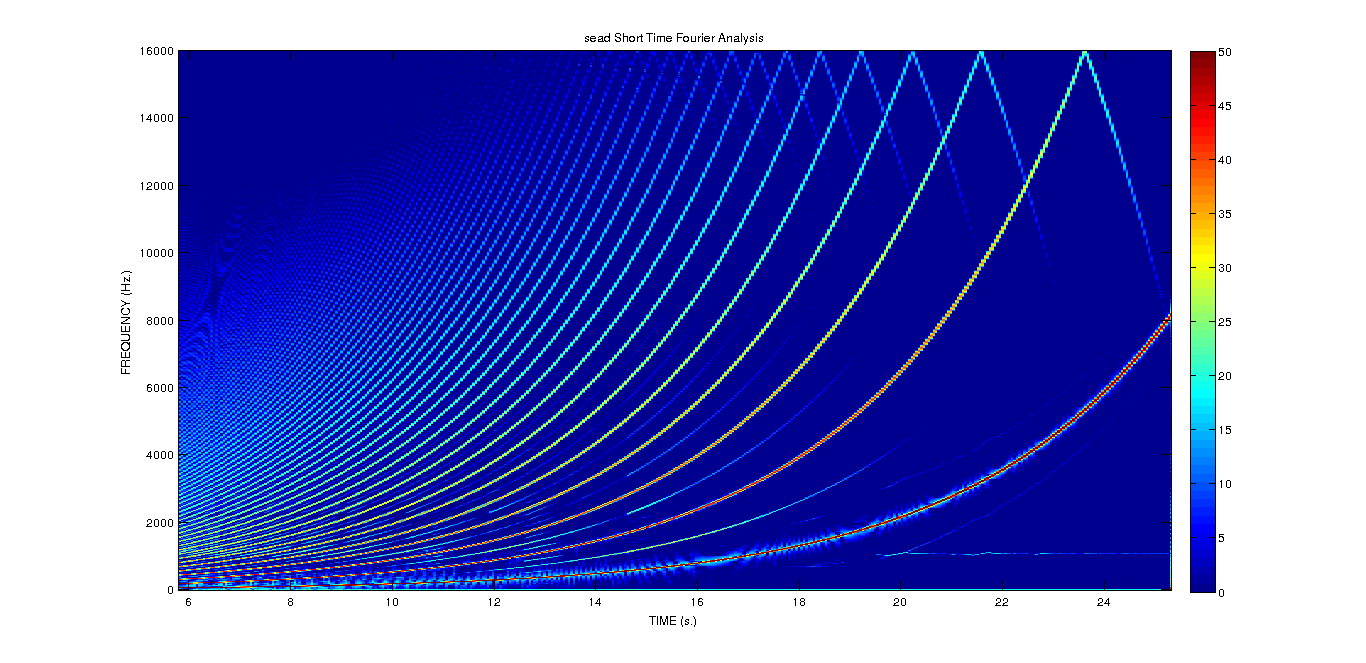
MATLAB Work/MCP3912 Evaluation/untitled.png
