FrauBluher/ShR2/Web Stack/documentation/modules/debug.rst

Debug Application
=================

This application exists solely to debug other applications in this
project.

Most of the functions revolve around supplying random data to the
database to test the functionality of the chart as well as the
accuracy of the calculations for billing.

Submodules
----------

debug.admin module
------------------

.. automodule:: debug.admin
    :members:
    :undoc-members:
    :show-inheritance:

debug.forms module
------------------

.. automodule:: debug.forms
    :members:
    :undoc-members:
    :show-inheritance:

debug.models module
-------------------

.. automodule:: debug.models
    :members:
    :undoc-members:
    :show-inheritance:

debug.serializers module
------------------------

.. automodule:: debug.serializers
    :members:
    :undoc-members:
    :show-inheritance:

debug.urls module
-----------------

.. automodule:: debug.urls
    :members:
    :undoc-members:
    :show-inheritance:

debug.views module
------------------

.. automodule:: debug.views
    :members:
    :undoc-members:
    :show-inheritance:

Module contents
---------------

.. automodule:: debug
    :members:
    :undoc-members:
    :show-inheritance:
