FrauBluher/ShR2/Hardware/Filtering/SPICE Simulations/Isolation.asc

C1: cap; .022µF
C2: cap; .022µ; Rser=3.9
C3: cap; .022µ; Rser=3.9
C4: cap; .022µF
R1: res; 121k
R2: res; 1k
R3: res; 1k
R5: res; 121k
R6: res; 121k
R7: res; 121k
V1: voltage; SINE(0 75 60); AC 1 0
V2: voltage; SINE(0 1 3000)
V3: voltage; 10
V4: voltage; -10v
Named nets: 0, Vin, VCC, VNEG
.tran 0 .2 .1 .0001 uic
FM Signal
60Hz Main
;ac oct 30 10 1000000
