FrauBluher/ShR2/Hardware/Filtering/SPICE Simulations/FilteringStageTesting.asc

C1: cap; .022µF
C2: cap; .022µ; Rser=3.9
C3: cap; .022µ; Rser=3.9
C4: cap; .022µF
C5: cap; 680p
C6: cap; 2.2nF
C7: cap; 1.5n
C8: cap; 6.8n
C9: cap; 100p
C10: cap; 470p
C11: cap; 100p
C13: cap; 1n
C14: cap; 2.2n
C15: cap; 1n
C16: cap; 15n
C17: cap; 1n
C20: cap; .022µF
C21: cap; .022µ; Rser=3.9
C22: cap; .022µ; Rser=3.9
C23: cap; .022µF
D1: TVSdiode; SMBJ24CA
R1: res; 121k
R2: res; 10.5k
R3: res; 6.98k
R4: res; 10.5k
R5: res; 121k
R6: res; 121k
R7: res; 121k
R8: res; 1.05k
R9: res; 15.8k
R10: res; 11k
R11: res; 4.87k
R12: res; 5k
R13: res; 1k
R14: res; 10.5k
R16: res; 13.3k
R17: res; 3.83k
R18: res; 4.99k
R19: res; 1.47k
R22: res; 5k
R23: res; 1k
R24: res; 121k
R25: res; 121k
R26: res; 121k
R27: res; 121k
R30: res; 100k
R31: res; 100k
U1: LTC6244HV
U2: LTC6244HV
U3: LTC6244HV
U4: LTC6244HV
U5: LTC6244HV
U6: LTC6244HV
U7: LTC6244HV
U8: LTC6244HV
U9: LTC6244HV
U10: LTC6244HV
U11: LTC6244HV
U12: LTC6244HV
V1: voltage; SINE(0 75 60); AC 1 0
V2: voltage; SINE(0 50 500)
V3: voltage; 10
V4: voltage; -10v
Named nets: 0, Vin, VCC, VNEG
;tran 0 .2 .1 .0001 uic
FM Signal
60Hz Main
.ac oct 30 10 1000000
15kHz Pass -45dB Stop @ 50kHz Min GBWP 2.43MHz
15kHz pass -55.4dB Stop @ 3000Hz Min GBWP 1.965 MHz
100kHz lowpass -59.98dB Stop @ 1MHz Min GBWP 10 MHz
