FrauBluher/ShR2/Hardware/PIC32 Based Hardware/SEAD Light/AFE_Pants_Powered.brd

## EAGLE design Hardware/PIC32 Based Hardware/SEAD Light/AFE_Pants_Powered.brd (2015-05-05)

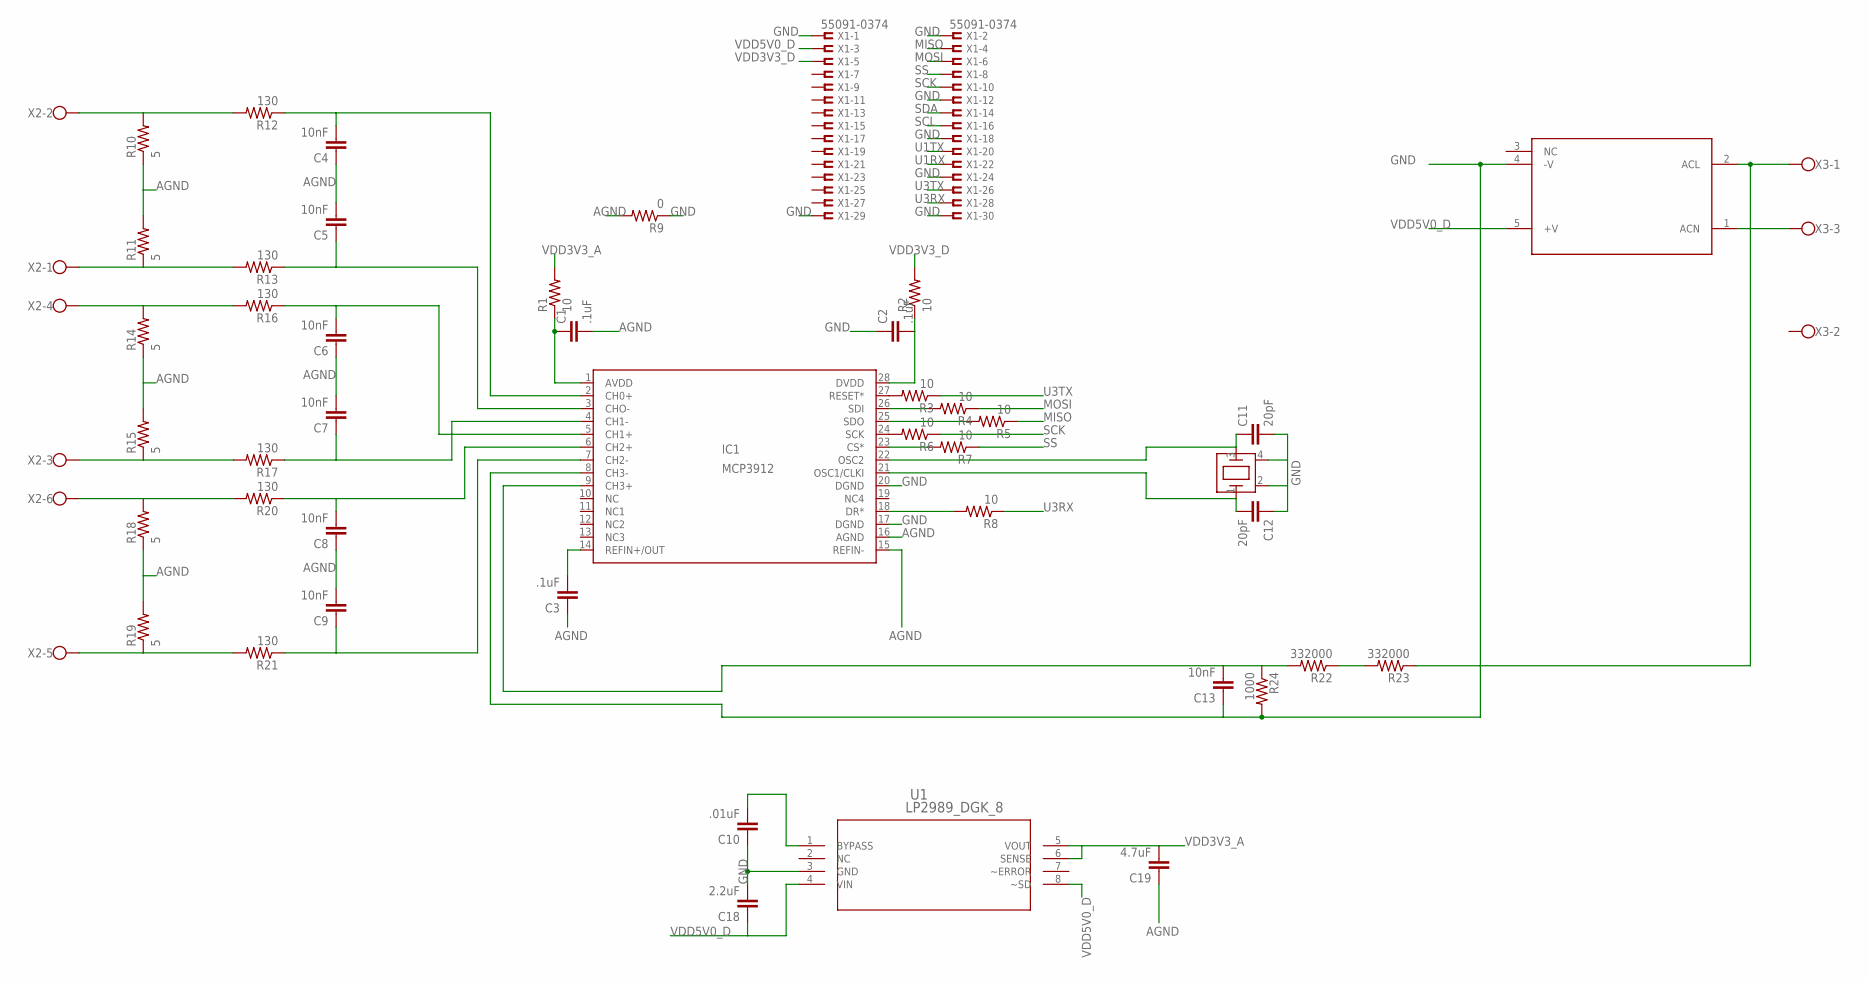
[picture p52: schematic AFE_Pants_Powered.sch]

Parts:
C1, C2, C3: .1uF; 0805
C4, C5, C6, C7, C8, C9, C13: 10nF; 0805
C10: .01uF; 0805
C11, C12: 20pF; 0805
C18: 2.2uF; 0805
C19: 4.7uF; 0805
IC1: MCP3912; SSOP28
R1, R2, R3, R4, R5, R6, R7, R8: 10; 0805
R9: 0; 0805
R10, R11, R14, R15, R18, R19: 5; 0805
R12, R13, R16, R17, R20, R21: 130; 0805
R22, R23: 332000; 0805
R24: 1000; 0805
U1: LP2989_DGK_8; MUA08A
U$1: 7M-12.000MEEQ-T; 7M-CRYSTAL
U$2: ECE05US05
X1: 55091-0374
X2: W237-6
X3: W237-103

Connections:
AGND: C1.2, C3.1, C4.1, C5.2, C6.1, C7.2, C8.1, C9.2, C19.1, IC1.15 (REFIN-), IC1.16 (AGND), R9.2, R10.1, R11.2, R14.1, R15.2, R18.1, R19.2
GND: C2.1, C10.1, C11.2, C12.1, C13.1, C18.2, IC1.8 (CH3-), IC1.17 (DGND), IC1.20 (DGND), R9.1, R24.2, U1.3 (GND), U$1.2 (GND1), U$1.4 (GND2), U$2.4 (-V), X1.1, X1.2, X1.12, X1.18, X1.24, X1.29, X1.30
MISO: R5.1, X1.4
MOSI: R4.1, X1.6
unnamed: C1.1, IC1.1 (AVDD), R1.1
unnamed: IC1.27 (RESET*), R3.2
unnamed: IC1.26 (SDI), R4.2
unnamed: IC1.25 (SDO), R5.2
unnamed: IC1.24 (SCK), R6.2
unnamed: IC1.23 (CS*), R7.2
unnamed: IC1.18 (DR*), R8.2
unnamed: C2.2, IC1.28 (DVDD), R2.1
unnamed: C3.2, IC1.14 (REFIN+/OUT)
unnamed: R10.2, R12.2, X2.2
unnamed: R11.1, R13.2, X2.1
unnamed: R14.2, R16.2, X2.4
unnamed: C4.2, IC1.2 (CH0+), R12.1
unnamed: C5.1, IC1.3 (CHO-), R13.1
unnamed: R15.1, R17.2, X2.3
unnamed: C6.2, IC1.5 (CH1+), R16.1
unnamed: C7.1, IC1.4 (CH1-), R17.1
unnamed: R18.2, R20.2, X2.6
unnamed: R19.1, R21.2, X2.5
unnamed: C8.2, IC1.6 (CH2+), R20.1
unnamed: C9.1, IC1.7 (CH2-), R21.1
unnamed: C13.2, IC1.9 (CH3+), R22.2, R24.1
unnamed: C10.2, U1.1 (BYPASS)
unnamed: C11.1, IC1.22 (OSC2), U$1.3 (OSC2)
unnamed: C12.2, IC1.21 (OSC1/CLKI), U$1.1 (OSC1)
unnamed: R23.1, U$2.2 (ACL), X3.1
unnamed: U$2.1 (ACN), X3.3
unnamed: R22.1, R23.2
SCK: R6.1, X1.10
SCL: X1.16
SDA: X1.14
SS: R7.1, X1.8
U1RX: X1.22
U1TX: X1.20
U3RX: R8.1, X1.28
U3TX: R3.1, X1.26
VDD3V3_A: C19.2, R1.2, U1.5 (VOUT), U1.6 (SENSE)
VDD3V3_D: R2.2, X1.5
VDD5V0_D: C18.1, U1.4 (VIN), U1.8 (~SD), U$2.5 (+V), X1.3

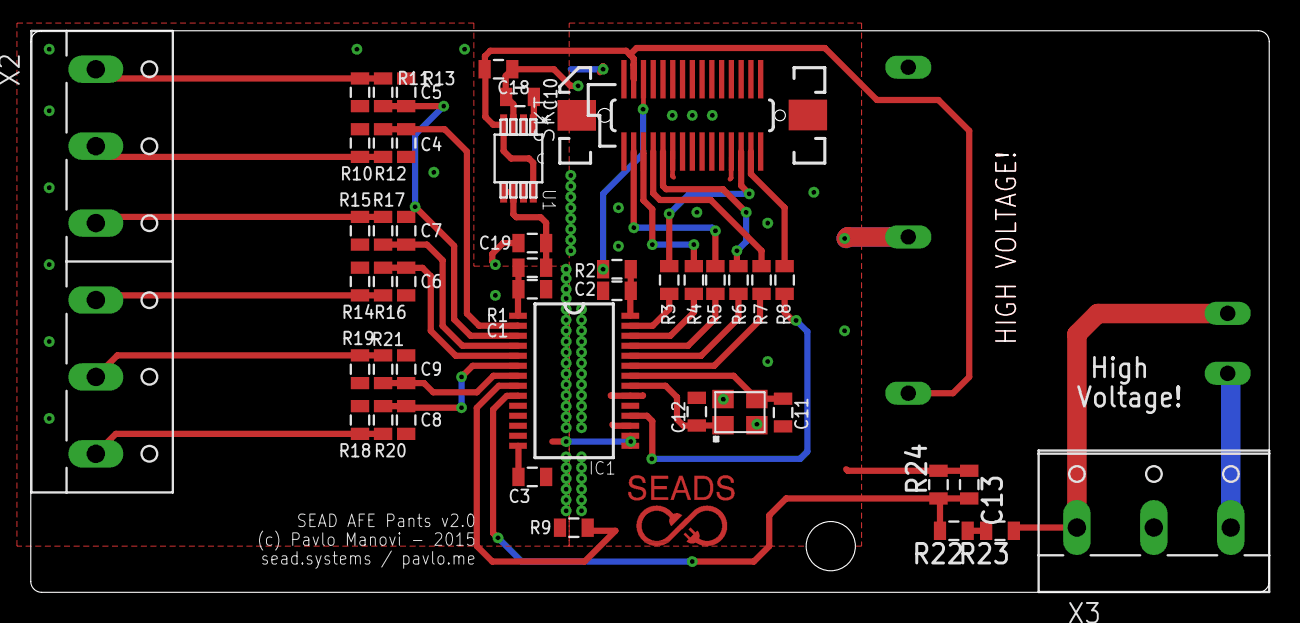
[picture p53: board AFE_Pants_Powered.brd from above]

Board: 2 copper layers, 80.5 x 36.5 mm, 46 parts (0 on the bottom side), 39 nets.
