FrauBluher/ShR2/Hardware/CTExcitationCircuit/CTExciter.brd

## EAGLE design Hardware/CTExcitationCircuit/CTExciter.brd (2015-03-02)

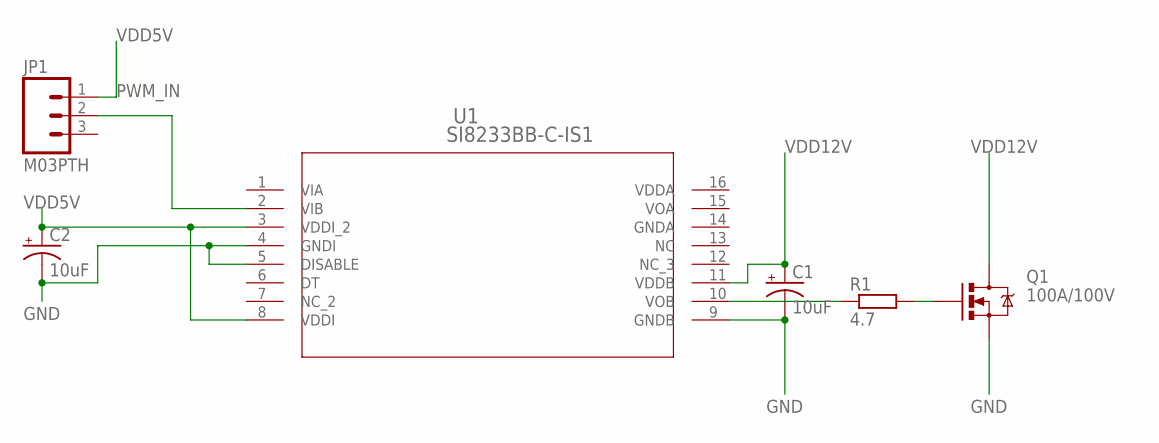
[picture p54: schematic CTExciter.sch]

Parts:
C1, C2: 10uF; CPOL-RADIAL-10UF-25V
JP1: M03PTH; 1X03
Q1: 100A/100V; TO-263/D2PAK
R1: 4.7; R0805
U1: SI8233BB-C-IS1; SOIC-16

Connections:
GND: C1.2 (-), C2.2 (-), Q1.3 (S), U1.4 (GNDI), U1.5 (DISABLE), U1.9 (GNDB)
unnamed: R1.1, U1.10 (VOB)
unnamed: Q1.1 (G), R1.2
PWM_IN: JP1.2, U1.2 (VIB)
VDD5V: C2.1 (+), JP1.1, U1.3 (VDDI_2), U1.8 (VDDI)
VDD12V: C1.1 (+), Q1.2 (D), U1.11 (VDDB)

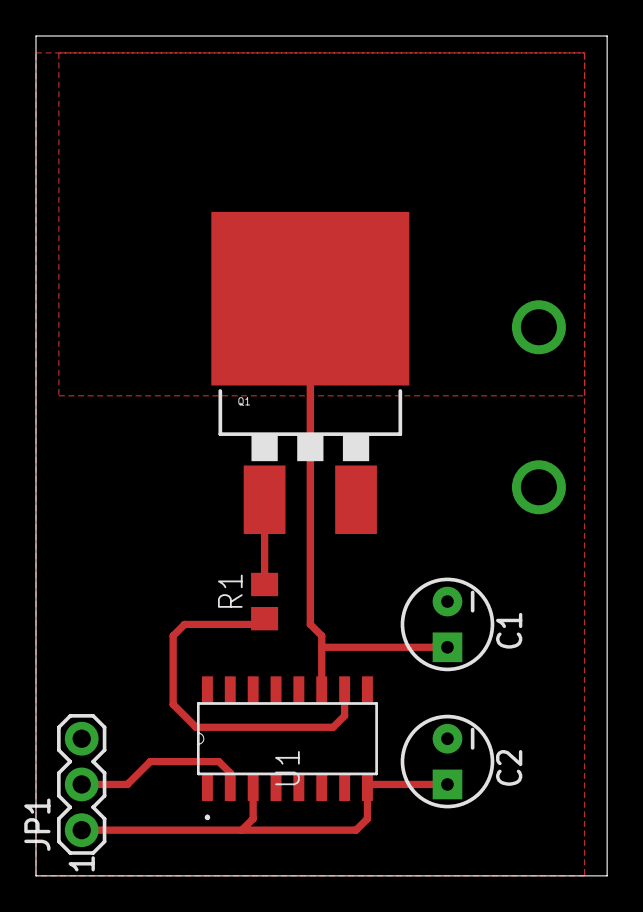
[picture p55: board CTExciter.brd from above]

Board: 2 copper layers, 31.7 x 46.7 mm, 6 parts (0 on the bottom side), 6 nets.
