FrauBluher/ShR2/Hardware/PIC32 Based Hardware/Cape/NILMCape.brd

## EAGLE design Hardware/PIC32 Based Hardware/Cape/NILMCape.brd (2014-04-10)

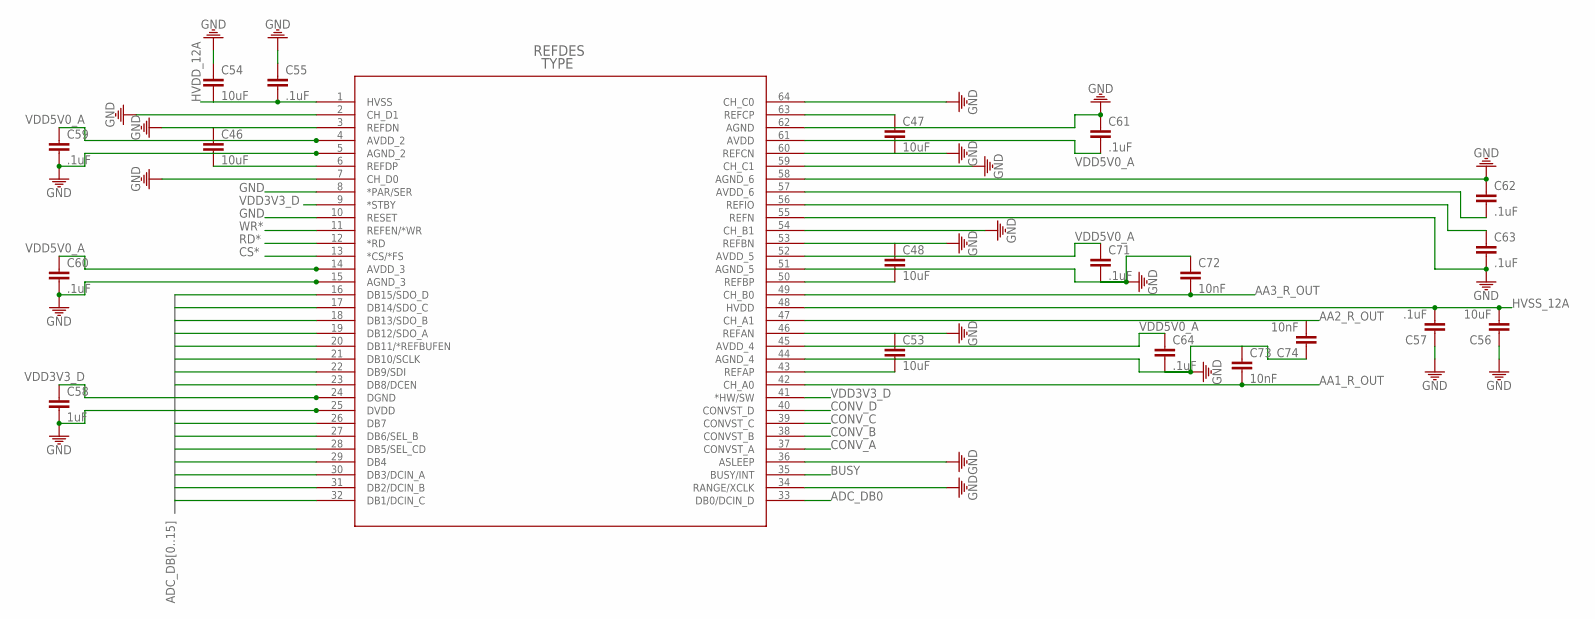
[picture p56: schematic NILMCape.sch, sheet 1]

Parts:
C46, C47, C48, C53, C54, C56: 10uF; 1210
C55, C57, C59, C60, C61, C62, C63, C64, C71: .1uF; 0805
C58: 1uF; 0805
C72, C73, C74: 10nF; 0805
U1: ADS8568_PM_64; PM64

Connections:
AA1_R_OUT: C73.2, U1.42 (CH_A0); also elsewhere on the board
AA2_R_OUT: C74.2, U1.47 (CH_A1); also elsewhere on the board
AA3_R_OUT: C72.2, U1.49 (CH_B0); also elsewhere on the board
ADC_DB0: U1.33 (DB0/DCIN_D); also elsewhere on the board
ADC_DB1: U1.32 (DB1/DCIN_C); also elsewhere on the board
ADC_DB2: U1.31 (DB2/DCIN_B); also elsewhere on the board
ADC_DB3: U1.30 (DB3/DCIN_A); also elsewhere on the board
ADC_DB4: U1.29 (DB4); also elsewhere on the board
ADC_DB5: U1.28 (DB5/SEL_CD); also elsewhere on the board
ADC_DB6: U1.27 (DB6/SEL_B); also elsewhere on the board
ADC_DB7: U1.26 (DB7); also elsewhere on the board
ADC_DB8: U1.23 (DB8/DCEN); also elsewhere on the board
ADC_DB9: U1.22 (DB9/SDI); also elsewhere on the board
ADC_DB10: U1.21 (DB10/SCLK); also elsewhere on the board
ADC_DB11: U1.20 (DB11/*REFBUFEN); also elsewhere on the board
ADC_DB12: U1.19 (DB12/SDO_A); also elsewhere on the board
ADC_DB13: U1.18 (DB13/SDO_B); also elsewhere on the board
ADC_DB14: U1.17 (DB14/SDO_C); also elsewhere on the board
ADC_DB15: U1.16 (DB15/SDO_D); also elsewhere on the board
BUSY: U1.35 (BUSY/INT)
CONV_A: U1.37 (CONVST_A)
CONV_B: U1.38 (CONVST_B)
CONV_C: U1.39 (CONVST_C)
CONV_D: U1.40 (CONVST_D)
CS*: U1.13 (*CS/*FS)
GND: C46.1, C47.2, C48.1, C53.1, C54.1, C55.1, C56.1, C57.1, C58.2, C59.2, C60.2, C61.1, C62.1, C63.2, C64.2, C71.2, C72.1, C73.1, C74.1, U1.2 (CH_D1), U1.3 (REFDN), U1.5 (AGND_2), U1.7 (CH_D0), U1.8 (*PAR/SER), U1.10 (RESET), U1.15 (AGND_3), U1.25 (DVDD), U1.34 (RANGE/XCLK), U1.36 (ASLEEP), U1.44 (AGND_4), U1.46 (REFAN), U1.51 (AGND_5), U1.53 (REFBN), U1.54 (CH_B1), U1.55 (REFN), U1.58 (AGND_6), U1.59 (CH_C1), U1.60 (REFCN), U1.62 (AGND), U1.64 (CH_C0); also elsewhere on the board
HVDD_12A: C54.2, C55.2, U1.1 (HVSS); also elsewhere on the board
HVSS_12A: C56.2, C57.2, U1.48 (HVDD); also elsewhere on the board
unnamed: C63.1, U1.56 (REFIO)
unnamed: C46.2, U1.6 (REFDP)
unnamed: C53.2, U1.43 (REFAP)
unnamed: C48.2, U1.50 (REFBP)
unnamed: C47.1, U1.63 (REFCP)
RD*: U1.12 (*RD)
VDD3V3_D: C58.1, U1.9 (*STBY), U1.24 (DGND), U1.41 (*HW/SW); also elsewhere on the board
VDD5V0_A: C59.1, C60.1, C61.2, C62.2, C64.1, C71.1, U1.4 (AVDD_2), U1.14 (AVDD_3), U1.45 (AVDD_4), U1.52 (AVDD_5), U1.57 (AVDD_6), U1.61 (AVDD); also elsewhere on the board
WR*: U1.11 (REFEN/*WR)

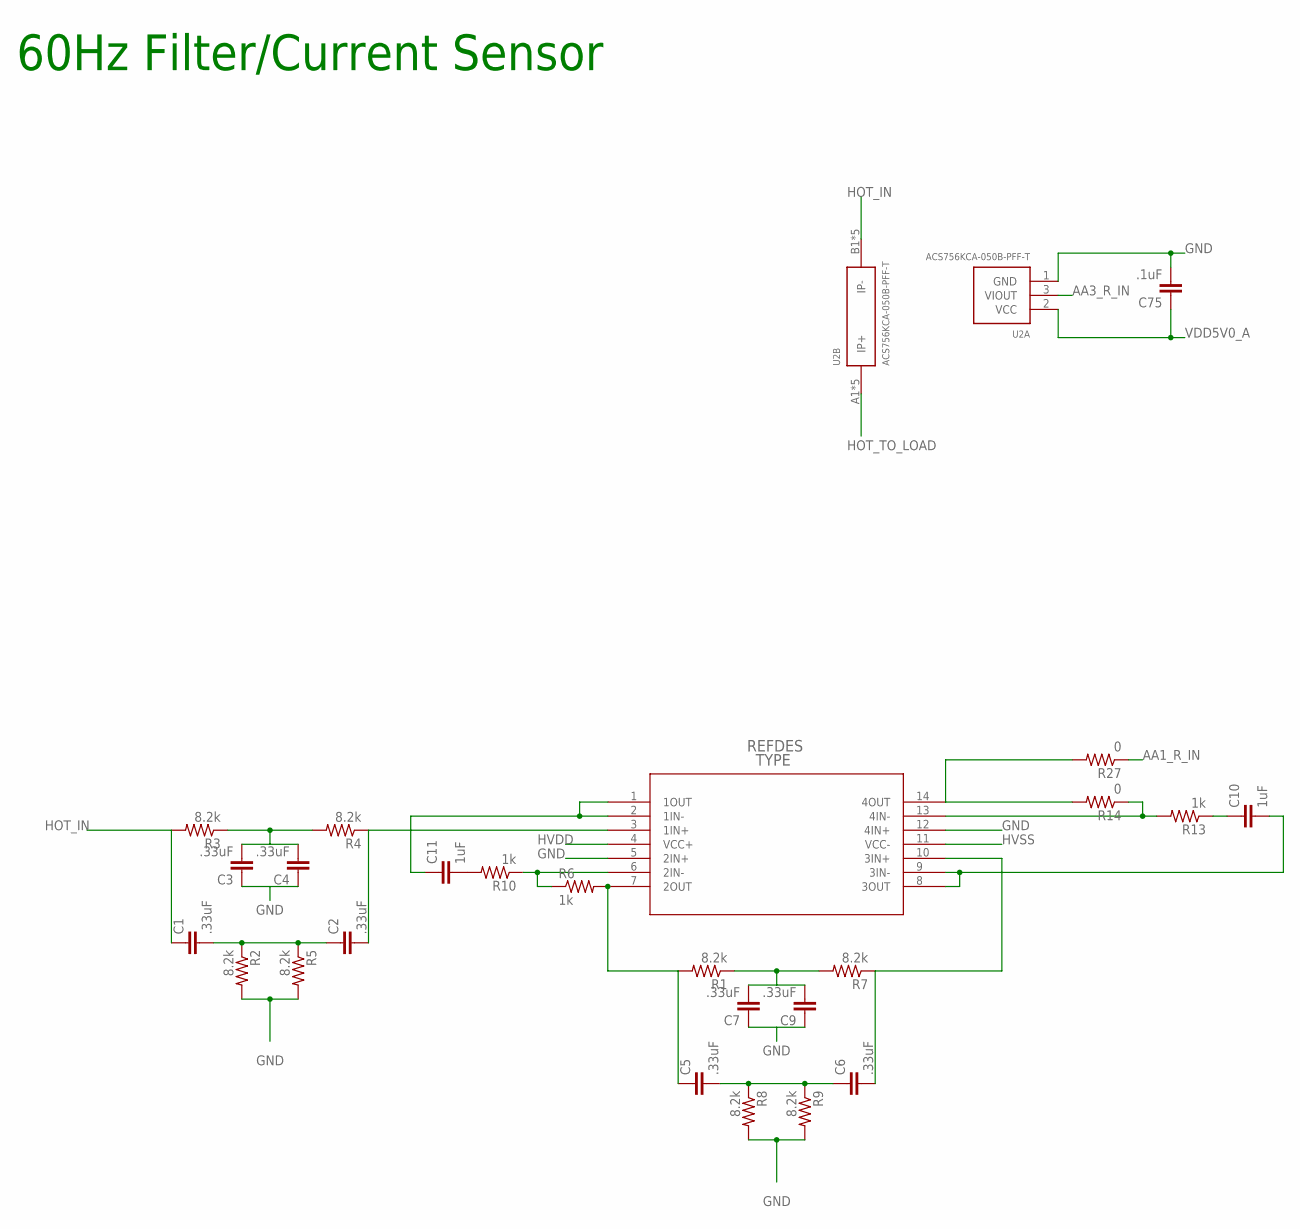
[picture p57: schematic NILMCape.sch, sheet 2]

Parts:
C1, C2, C3, C4, C5, C6, C7, C9: .33uF; 0805
C10, C11: 1uF; 0805
C75: .1uF; 0805
R1, R2, R3, R4, R5, R7, R8, R9: 8.2k; 0805
R6, R10, R13: 1k; 0805
R14, R27: 0; 0805
U2: ACS756KCA-050B-PFF-T; 5PFF
U9: TL074_PW_14; PW14

Connections:
AA1_R_IN: R27.1; also elsewhere on the board
AA3_R_IN: U2.3 (VIOUT); also elsewhere on the board
GAIN_R_IN: R13.2, R14.1, U9.13 (4IN-); also elsewhere on the board
GAIN_R_OUT: R14.2, R27.2, U9.14 (4OUT); also elsewhere on the board
GND: C3.1, C4.1, C7.1, C9.1, C75.2, R2.2, R5.2, R8.2, R9.2, U2.1 (GND), U9.5 (2IN+), U9.12 (4IN+); also elsewhere on the board
HOT_IN: C1.1, R3.2, U2.B1 (IP-), U2.B2 (IP-), U2.B3 (IP-), U2.B4 (IP-), U2.B5 (IP-)
HOT_TO_LOAD: U2.A1 (IP+), U2.A2 (IP+), U2.A3 (IP+), U2.A4 (IP+), U2.A5 (IP+)
HVDD: U9.4 (VCC+)
HVSS: U9.11 (VCC-)
unnamed: C5.1, R1.2, R6.2, U9.7 (2OUT)
unnamed: C1.2, C2.1, R2.1, R5.1
unnamed: C3.2, C4.2, R3.1, R4.2
unnamed: R6.1, R10.1, U9.6 (2IN-)
unnamed: C2.2, R4.1, U9.3 (1IN+)
unnamed: C5.2, C6.1, R8.1, R9.1
unnamed: C7.2, C9.2, R1.1, R7.2
unnamed: C6.2, R7.1, U9.10 (3IN+)
unnamed: C10.2, U9.8 (3OUT), U9.9 (3IN-)
unnamed: C10.1, R13.1
unnamed: C11.2, R10.2
unnamed: C11.1, U9.1 (1OUT), U9.2 (1IN-)
VDD5V0_A: C75.1, U2.2 (VCC); also elsewhere on the board

Notes on the sheet:
60Hz Filter/Current Sensor

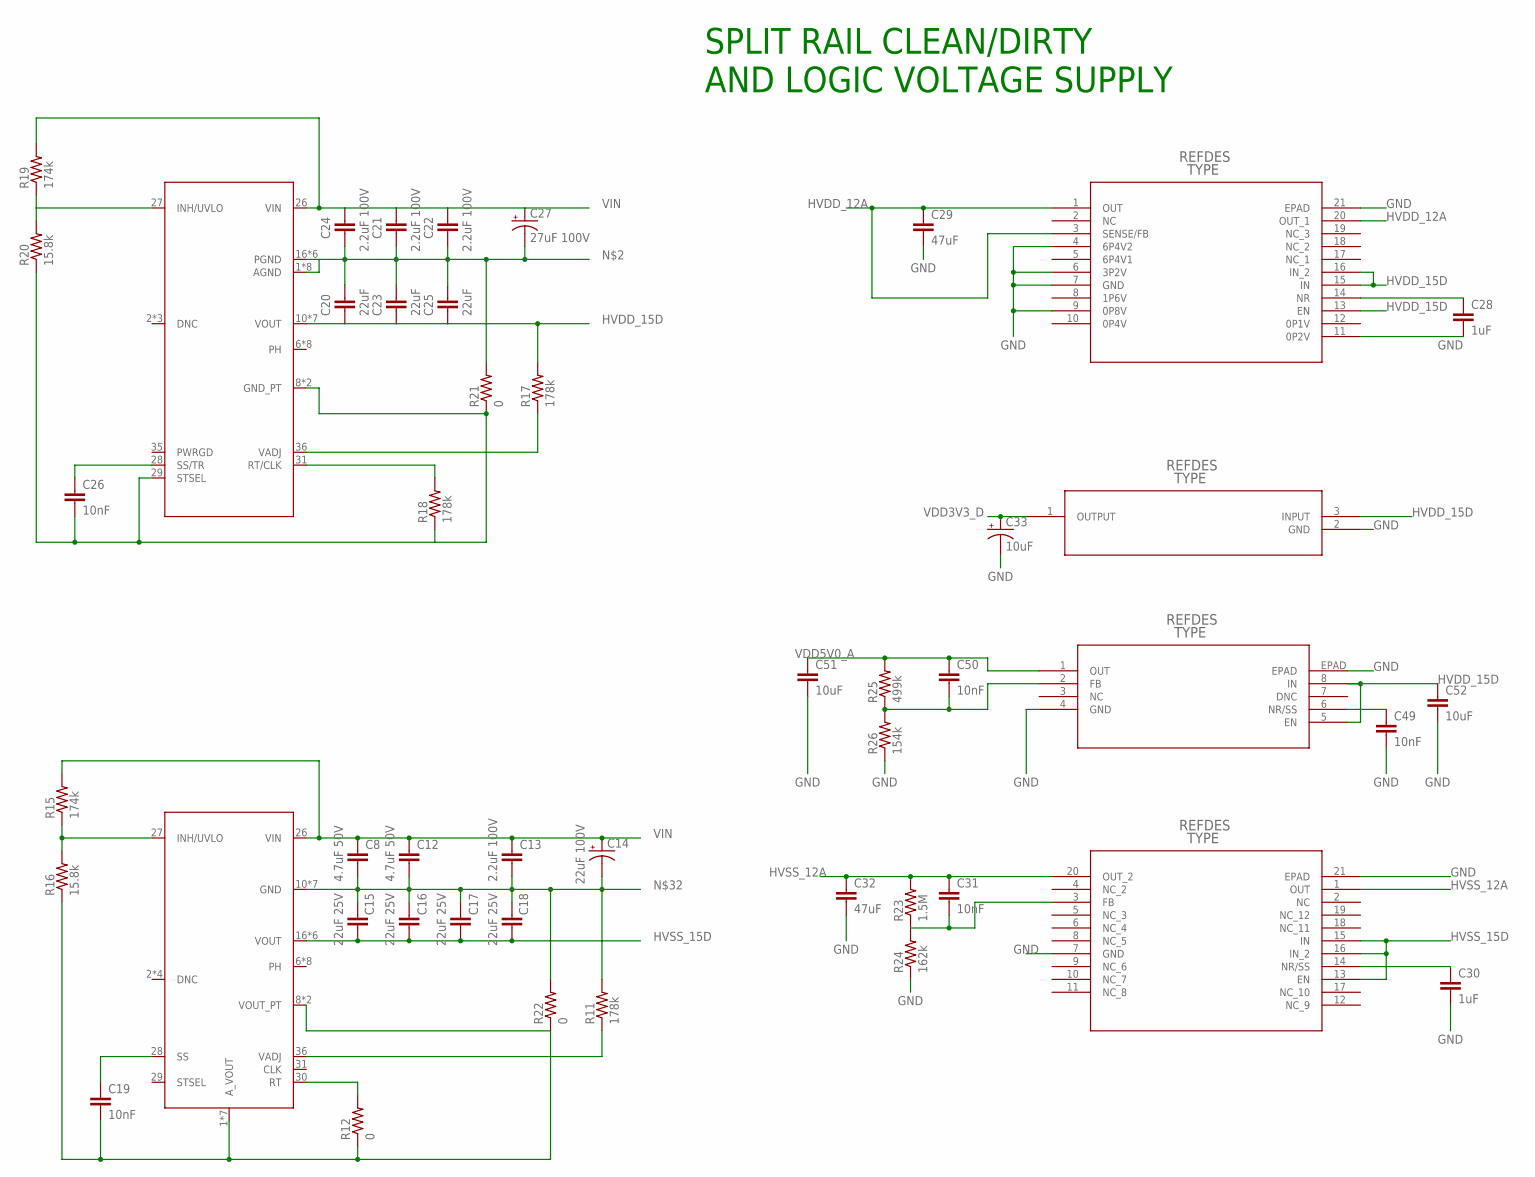
[picture p58: schematic NILMCape.sch, sheet 3]

Parts:
C8, C12: 4.7uF 50V; 1210
C13, C21, C22, C24: 2.2uF 100V; 1210
C14: 22uF 100V; CPOL-RADIAL-100UF-25V
C15, C16, C17, C18: 22uF 25V; 1210
C19, C26, C31, C49, C50: 10nF; 0805
C20, C23, C25: 22uF; 1210
C27: 27uF 100V; CPOL-RADIAL-100UF-25V
C28, C30: 1uF; 0805
C29, C32: 47uF; 1210
C33: 10uF; CPOL-RADIAL-10UF-25V
C51, C52: 10uF; 1206
R11, R17, R18: 178k; 0805
R12, R21, R22: 0; 0805
R15, R19: 174k; 0805
R16, R20: 15.8k; 0805
R23: 1.5M; 0805
R24: 162k; 0805
R25: 499k; 0805
R26: 154k; 0805
U5: TPS84250_RKG_41; RKG41
U6: TPS7A3301_RGW_20; RGW20_3P15X3P15
U7: LP2950-33_KVU_3; KVU3
U15: TPS7A4901_DGN_8; DGN8_1P89X1P57
U$2: TPS84259_RKG_41; RKG41
U$3: TPS7A4700_RGW_20; RGW20_3P15X3P15

Connections:
GND: C19.2, C28.2, C29.2, C30.2, C32.2, C33.2 (-), C49.2, C51.2, C52.2, R12.1, R16.1, R22.1, R24.1, R26.1, U6.7 (GND), U6.21 (EPAD), U7.2 (GND), U15.4 (GND), U15.EPAD, U$2.1 (A_VOUT), U$2.4 (A_VOUT), U$2.5 (A_VOUT), U$2.8 (VOUT_PT), U$2.9 (VOUT_PT), U$2.32 (A_VOUT), U$2.33 (A_VOUT), U$2.34 (A_VOUT), U$2.37 (A_VOUT), U$3.4 (6P4V2), U$3.6 (3P2V), U$3.7 (GND), U$3.9 (0P8V), U$3.11 (0P2V), U$3.21 (EPAD); also elsewhere on the board
HVDD_12A: C29.1, U$3.1 (OUT), U$3.3 (SENSE/FB), U$3.20 (OUT_1); also elsewhere on the board
HVDD_15D: C20.2, C23.2, C25.2, C52.1, R17.2, U5.10 (VOUT), U5.11 (VOUT), U5.12 (VOUT), U5.13 (VOUT), U5.14 (VOUT), U5.15 (VOUT), U5.39 (VOUT), U7.3 (INPUT), U15.5 (EN), U15.8 (IN), U$3.13 (EN), U$3.15 (IN), U$3.16 (IN_2)
HVSS_12A: C31.1, C32.1, R23.2, U6.1 (OUT), U6.20 (OUT_2); also elsewhere on the board
HVSS_15D: C15.2, C16.2, C17.2, C18.2, U6.13 (EN), U6.15 (IN), U6.16 (IN_2), U$2.16 (VOUT), U$2.17 (VOUT), U$2.18 (VOUT), U$2.19 (VOUT), U$2.20 (VOUT), U$2.40 (VOUT)
unnamed: C20.1, C21.2, C22.2, C23.1, C24.2, C25.1, C27.2 (-), R21.2, U5.1 (AGND), U5.4 (AGND), U5.5 (AGND), U5.16 (PGND), U5.17 (PGND), U5.18 (PGND), U5.19 (PGND), U5.20 (PGND), U5.30 (AGND), U5.32 (AGND), U5.33 (AGND), U5.34 (AGND), U5.37 (AGND), U5.40 (PGND)
unnamed: C19.1, U$2.28 (SS)
unnamed: C31.2, R24.2, U6.3 (FB)
unnamed: R11.1, U$2.36 (VADJ)
unnamed: R12.2, U$2.30 (RT)
unnamed: C8.2, C12.2, C13.2, C14.2 (-), C15.1, C16.1, C17.1, C18.1, R11.2, R22.2, U$2.10 (GND), U$2.11 (GND), U$2.12 (GND), U$2.13 (GND), U$2.14 (GND), U$2.15 (GND), U$2.39 (GND)
unnamed: C30.1, U6.14 (NR/SS)
unnamed: R15.1, R16.2, U$2.27 (INH/UVLO)
unnamed: R17.1, U5.36 (VADJ)
unnamed: R18.2, U5.31 (RT/CLK)
unnamed: R19.1, R20.2, U5.27 (INH/UVLO)
unnamed: C26.1, U5.28 (SS/TR)
unnamed: C26.2, R18.1, R20.1, R21.1, U5.8 (GND_PT), U5.9 (GND_PT), U5.29 (STSEL)
unnamed: C28.1, U$3.14 (NR)
unnamed: C49.1, U15.6 (NR/SS)
unnamed: C50.2, R25.1, R26.2, U15.2 (FB)
VDD3V3_D: C33.1 (+), U7.1 (OUTPUT); also elsewhere on the board
VDD5V0_A: C50.1, C51.1, R25.2, U15.1 (OUT); also elsewhere on the board
VIN: C8.1, C12.1, C13.1, C14.1 (+), C21.1, C22.1, C24.1, C27.1 (+), R15.2, R19.2, U5.26 (VIN), U$2.26 (VIN)

Notes on the sheet:
SPLIT RAIL CLEAN/DIRTY AND LOGIC VOLTAGE SUPPLY

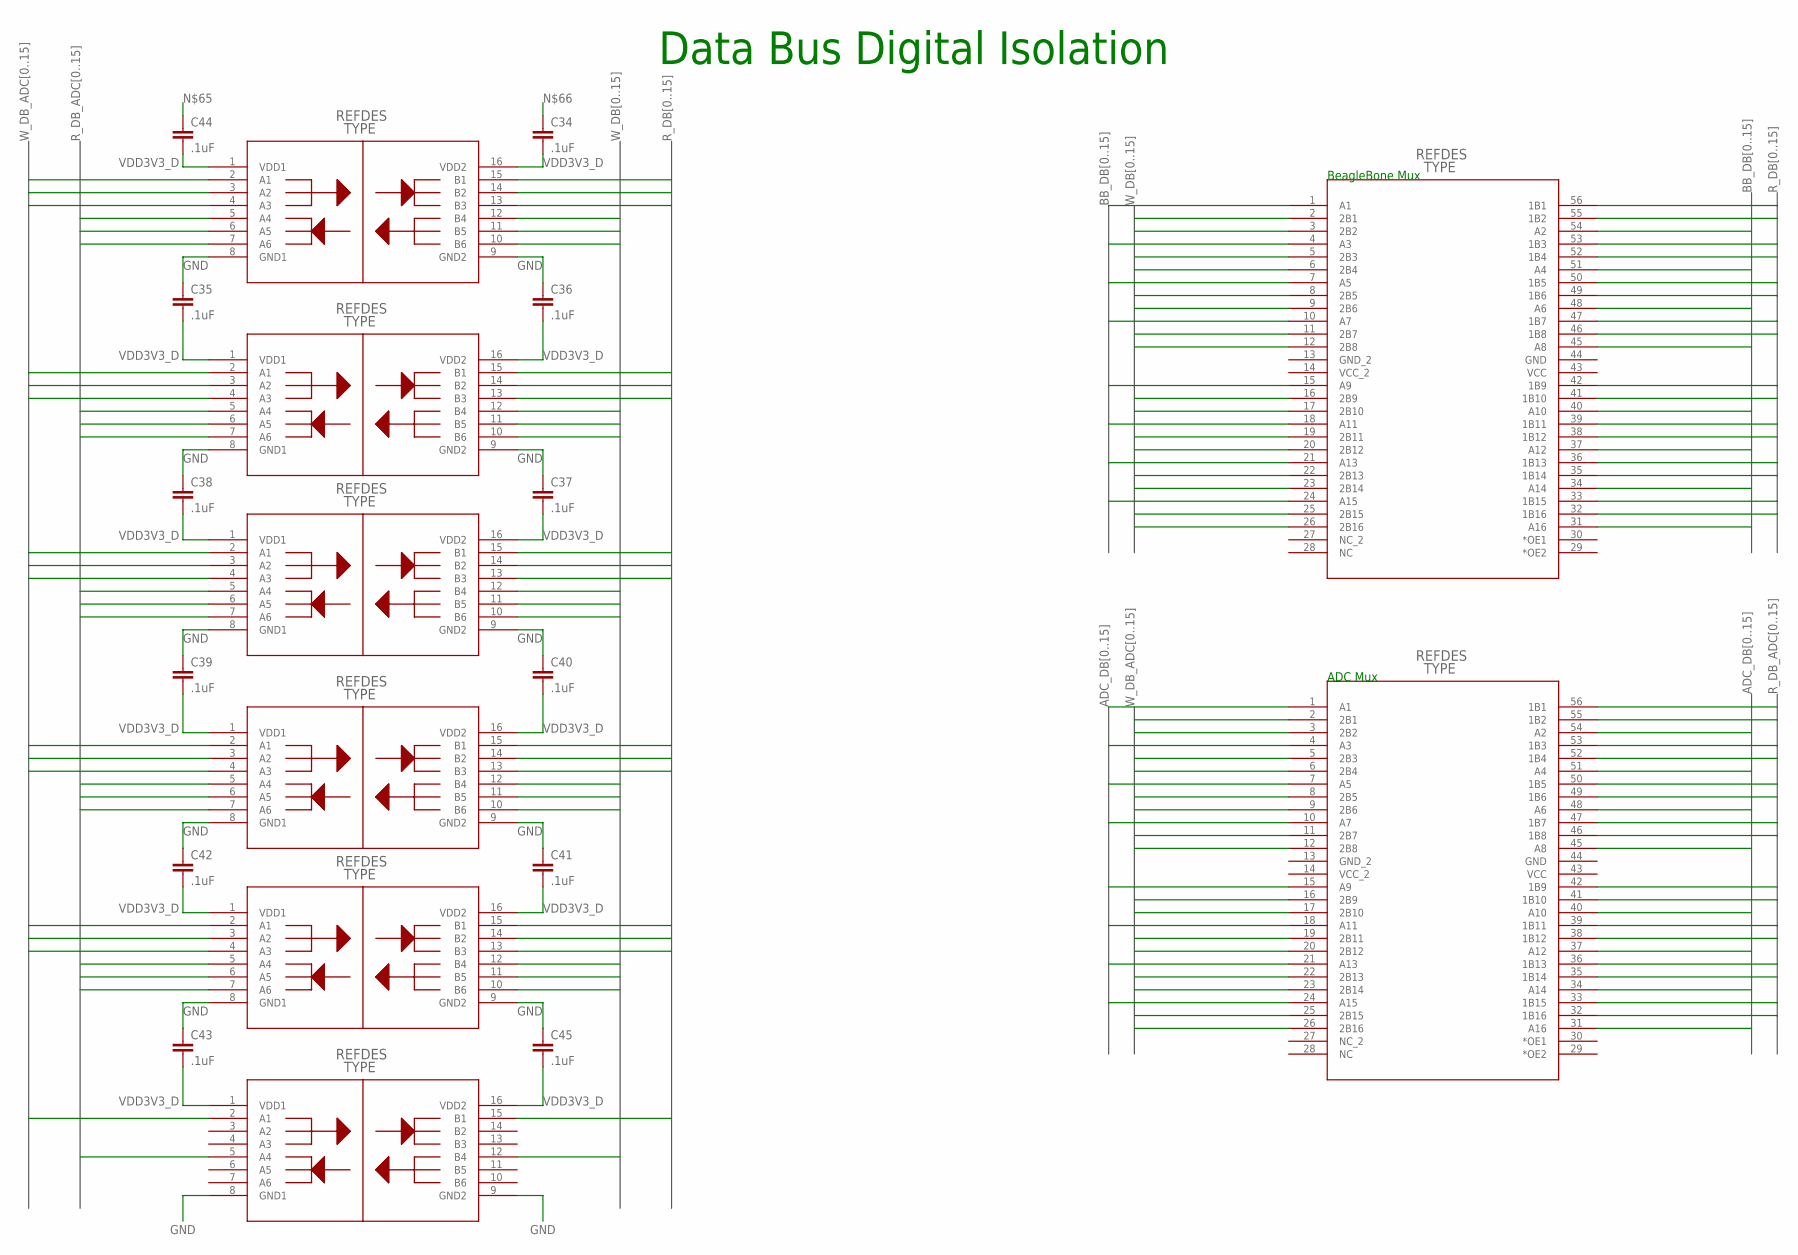
[picture p59: schematic NILMCape.sch, sheet 4]

Parts:
C34, C35, C36, C37, C38, C39, C40, C41, C42, C43, C44, C45: .1uF; 0805
U3, U8, U10, U11, U12, U13: SI8663BC-B-IS1; SOIC-16
U4, U14: SN74CBT16390_DGG; DGG56

Connections:
ADC_DB0: U14.1 (A1); also elsewhere on the board
ADC_DB1: U14.54 (A2); also elsewhere on the board
ADC_DB2: U14.4 (A3); also elsewhere on the board
ADC_DB3: U14.51 (A4); also elsewhere on the board
ADC_DB4: U14.7 (A5); also elsewhere on the board
ADC_DB5: U14.48 (A6); also elsewhere on the board
ADC_DB6: U14.10 (A7); also elsewhere on the board
ADC_DB7: U14.45 (A8); also elsewhere on the board
ADC_DB8: U14.15 (A9); also elsewhere on the board
ADC_DB9: U14.40 (A10); also elsewhere on the board
ADC_DB10: U14.18 (A11); also elsewhere on the board
ADC_DB11: U14.37 (A12); also elsewhere on the board
ADC_DB12: U14.21 (A13); also elsewhere on the board
ADC_DB13: U14.34 (A14); also elsewhere on the board
ADC_DB14: U14.24 (A15); also elsewhere on the board
ADC_DB15: U14.31 (A16); also elsewhere on the board
BB_DB0: U4.1 (A1); also elsewhere on the board
BB_DB1: U4.54 (A2); also elsewhere on the board
BB_DB2: U4.4 (A3); also elsewhere on the board
BB_DB3: U4.51 (A4); also elsewhere on the board
BB_DB4: U4.7 (A5); also elsewhere on the board
BB_DB5: U4.48 (A6); also elsewhere on the board
BB_DB6: U4.10 (A7); also elsewhere on the board
BB_DB7: U4.45 (A8); also elsewhere on the board
BB_DB8: U4.15 (A9); also elsewhere on the board
BB_DB9: U4.40 (A10); also elsewhere on the board
BB_DB10: U4.18 (A11); also elsewhere on the board
BB_DB11: U4.37 (A12); also elsewhere on the board
BB_DB12: U4.21 (A13); also elsewhere on the board
BB_DB13: U4.34 (A14); also elsewhere on the board
BB_DB14: U4.24 (A15); also elsewhere on the board
BB_DB15: U4.31 (A16); also elsewhere on the board
GND: C35.1, C36.1, C37.1, C38.1, C39.1, C40.1, C41.1, C42.1, C43.1, C45.1, U3.8 (GND1), U3.9 (GND2), U8.8 (GND1), U8.9 (GND2), U10.8 (GND1), U10.9 (GND2), U11.8 (GND1), U11.9 (GND2), U12.8 (GND1), U12.9 (GND2), U13.8 (GND1), U13.9 (GND2); also elsewhere on the board
R_DB0: U4.56 (1B1), U12.15 (B1)
R_DB1: U4.55 (1B2), U12.14 (B2)
R_DB2: U4.53 (1B3), U12.13 (B3)
R_DB3: U4.52 (1B4), U11.15 (B1)
R_DB4: U4.50 (1B5), U11.14 (B2)
R_DB5: U4.49 (1B6), U11.13 (B3)
R_DB6: U4.47 (1B7), U10.15 (B1)
R_DB7: U4.46 (1B8), U10.14 (B2)
R_DB8: U4.42 (1B9), U10.13 (B3)
R_DB9: U3.15 (B1), U4.41 (1B10)
R_DB10: U3.14 (B2), U4.39 (1B11)
R_DB11: U3.13 (B3), U4.38 (1B12)
R_DB12: U4.36 (1B13), U8.15 (B1)
R_DB13: U4.35 (1B14), U8.14 (B2)
R_DB14: U4.33 (1B15), U8.13 (B3)
R_DB15: U4.32 (1B16), U13.15 (B1)
R_DB_ADC0: U12.5 (A4), U14.56 (1B1)
R_DB_ADC1: U12.6 (A5), U14.55 (1B2)
R_DB_ADC2: U12.7 (A6), U14.53 (1B3)
R_DB_ADC3: U11.5 (A4), U14.52 (1B4)
R_DB_ADC4: U11.6 (A5), U14.50 (1B5)
R_DB_ADC5: U11.7 (A6), U14.49 (1B6)
R_DB_ADC6: U10.5 (A4), U14.47 (1B7)
R_DB_ADC7: U10.6 (A5), U14.46 (1B8)
R_DB_ADC8: U10.7 (A6), U14.42 (1B9)
R_DB_ADC9: U3.5 (A4), U14.41 (1B10)
R_DB_ADC10: U3.6 (A5), U14.39 (1B11)
R_DB_ADC11: U3.7 (A6), U14.38 (1B12)
R_DB_ADC12: U8.5 (A4), U14.36 (1B13)
R_DB_ADC13: U8.6 (A5), U14.35 (1B14)
R_DB_ADC14: U8.7 (A6), U14.33 (1B15)
R_DB_ADC15: U13.5 (A4), U14.32 (1B16)
VDD3V3_D: C34.2, C35.2, C36.2, C37.2, C38.2, C39.2, C40.2, C41.2, C42.2, C43.2, C44.2, C45.2, U3.1 (VDD1), U3.16 (VDD2), U8.1 (VDD1), U8.16 (VDD2), U10.1 (VDD1), U10.16 (VDD2), U11.1 (VDD1), U11.16 (VDD2), U12.1 (VDD1), U12.16 (VDD2), U13.1 (VDD1), U13.16 (VDD2); also elsewhere on the board
W_DB0: U4.2 (2B1), U12.12 (B4)
W_DB1: U4.3 (2B2), U12.11 (B5)
W_DB2: U4.5 (2B3), U12.10 (B6)
W_DB3: U4.6 (2B4), U11.12 (B4)
W_DB4: U4.8 (2B5), U11.11 (B5)
W_DB5: U4.9 (2B6), U11.10 (B6)
W_DB6: U4.11 (2B7), U10.12 (B4)
W_DB7: U4.12 (2B8), U10.11 (B5)
W_DB8: U4.16 (2B9), U10.10 (B6)
W_DB9: U3.12 (B4), U4.17 (2B10)
W_DB10: U3.11 (B5), U4.19 (2B11)
W_DB11: U3.10 (B6), U4.20 (2B12)
W_DB12: U4.22 (2B13), U8.12 (B4)
W_DB13: U4.23 (2B14), U8.11 (B5)
W_DB14: U4.25 (2B15), U8.10 (B6)
W_DB15: U4.26 (2B16), U13.12 (B4)
W_DB_ADC0: U12.2 (A1), U14.2 (2B1)
W_DB_ADC1: U12.3 (A2), U14.3 (2B2)
W_DB_ADC2: U12.4 (A3), U14.5 (2B3)
W_DB_ADC3: U11.2 (A1), U14.6 (2B4)
W_DB_ADC4: U11.3 (A2), U14.8 (2B5)
W_DB_ADC5: U14.9 (2B6)
W_DB_ADC6: U10.2 (A1), U11.4 (A3), U14.11 (2B7)
W_DB_ADC7: U10.3 (A2), U14.12 (2B8)
W_DB_ADC8: U10.4 (A3), U14.16 (2B9)
W_DB_ADC9: U3.2 (A1), U14.17 (2B10)
W_DB_ADC10: U3.3 (A2), U14.19 (2B11)
W_DB_ADC11: U3.4 (A3), U14.20 (2B12)
W_DB_ADC12: U8.2 (A1), U14.22 (2B13)
W_DB_ADC13: U8.3 (A2), U14.23 (2B14)
W_DB_ADC14: U8.4 (A3), U14.25 (2B15)
W_DB_ADC15: U13.2 (A1), U14.26 (2B16)

Notes on the sheet:
Data Bus Digital Isolation
BeagleBone Mux
ADC Mux

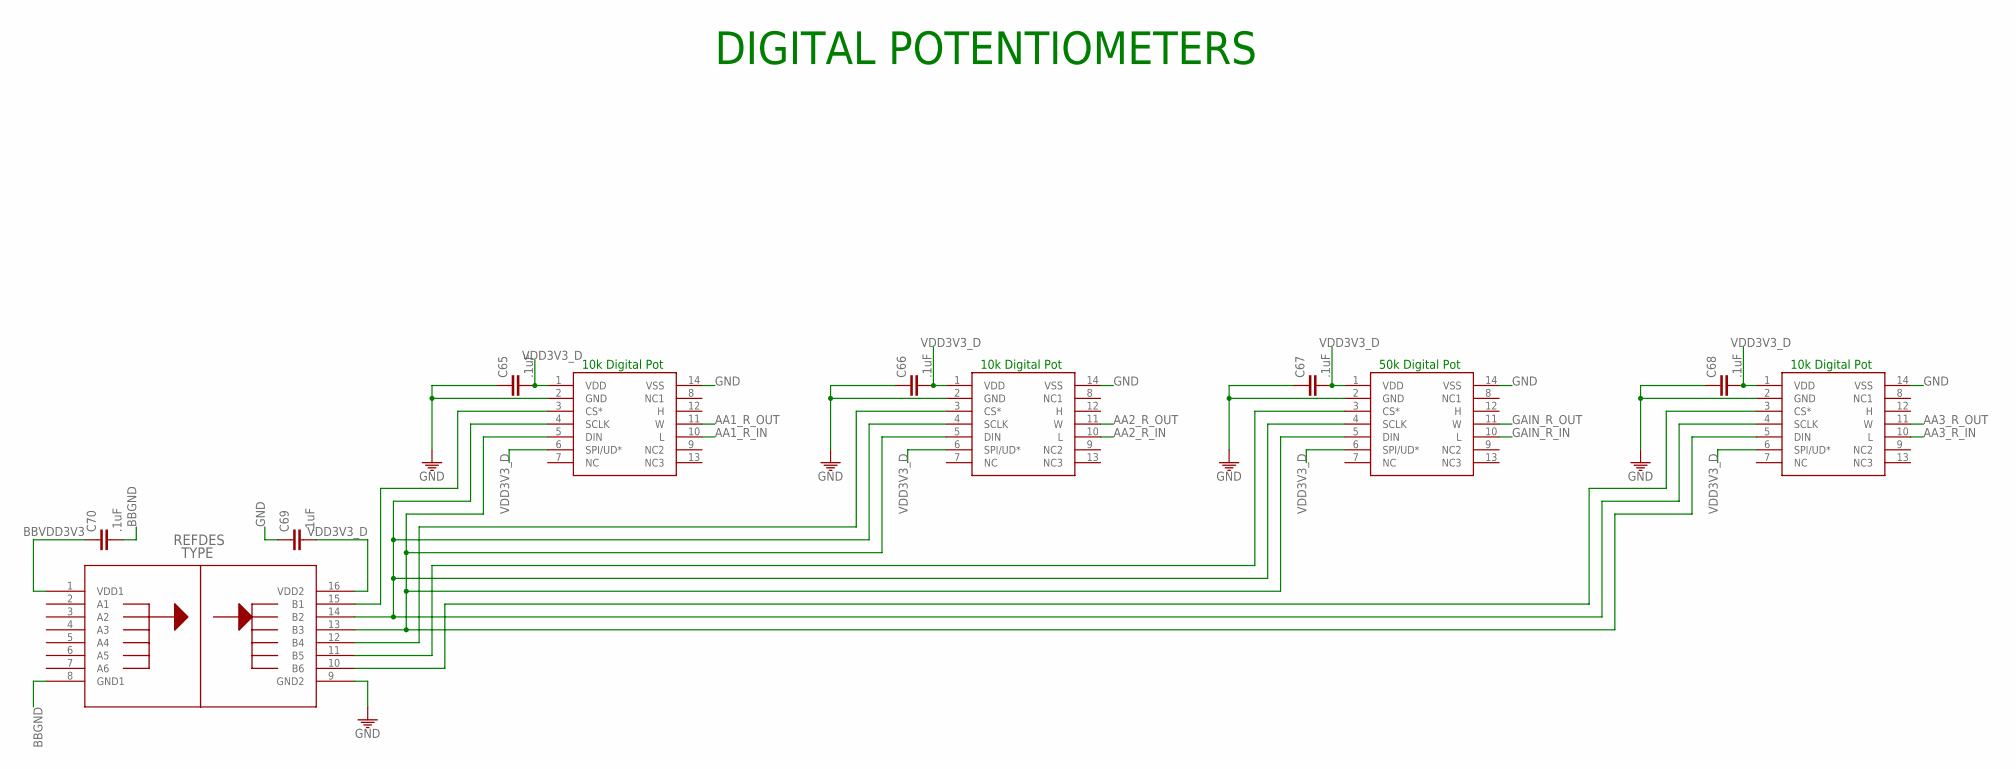
[picture p60: schematic NILMCape.sch, sheet 5]

Parts:
C65, C66, C67, C68, C69, C70: .1uF; 0805
U16: SI8660BC-B-IS1; SOIC-16
U$4, U$5, U$6, U$7: MAX548X; TSSOP14_MC

Connections:
AA1_R_IN: U$4.10 (L); also elsewhere on the board
AA1_R_OUT: U$4.11 (W); also elsewhere on the board
AA2_R_IN: U$5.10 (L)
AA2_R_OUT: U$5.11 (W); also elsewhere on the board
AA3_R_IN: U$7.10 (L); also elsewhere on the board
AA3_R_OUT: U$7.11 (W); also elsewhere on the board
BBGND: C70.2, U16.8 (GND1); also elsewhere on the board
BBVDD3V3: C70.1, U16.1 (VDD1); also elsewhere on the board
GAIN_R_IN: U$6.10 (L); also elsewhere on the board
GAIN_R_OUT: U$6.11 (W); also elsewhere on the board
GND: C65.1, C66.1, C67.1, C68.1, C69.1, U16.9 (GND2), U$4.2 (GND), U$4.14 (VSS), U$5.2 (GND), U$5.14 (VSS), U$6.2 (GND), U$6.14 (VSS), U$7.2 (GND), U$7.14 (VSS); also elsewhere on the board
unnamed: U16.15 (B1), U$4.3 (CS*)
unnamed: U16.11 (B5), U$6.3 (CS*)
unnamed: U16.12 (B4), U$5.3 (CS*)
unnamed: U16.10 (B6), U$7.3 (CS*)
unnamed: U16.14 (B2), U$4.4 (SCLK), U$5.4 (SCLK), U$6.4 (SCLK), U$7.4 (SCLK)
unnamed: U16.13 (B3), U$4.5 (DIN), U$5.5 (DIN), U$6.5 (DIN), U$7.5 (DIN)
VDD3V3_D: C65.2, C66.2, C67.2, C68.2, C69.2, U16.16 (VDD2), U$4.1 (VDD), U$4.6 (SPI/UD*), U$5.1 (VDD), U$5.6 (SPI/UD*), U$6.1 (VDD), U$6.6 (SPI/UD*), U$7.1 (VDD), U$7.6 (SPI/UD*); also elsewhere on the board

Notes on the sheet:
10k Digital Pot
50k Digital Pot
DIGITAL POTENTIOMETERS
