FrauBluher/ShR2/Hardware/PIC32 Based Hardware/Cape/NILMCape.brd

## EAGLE design Hardware/PIC32 Based Hardware/Cape/NILMCape.brd (continued)

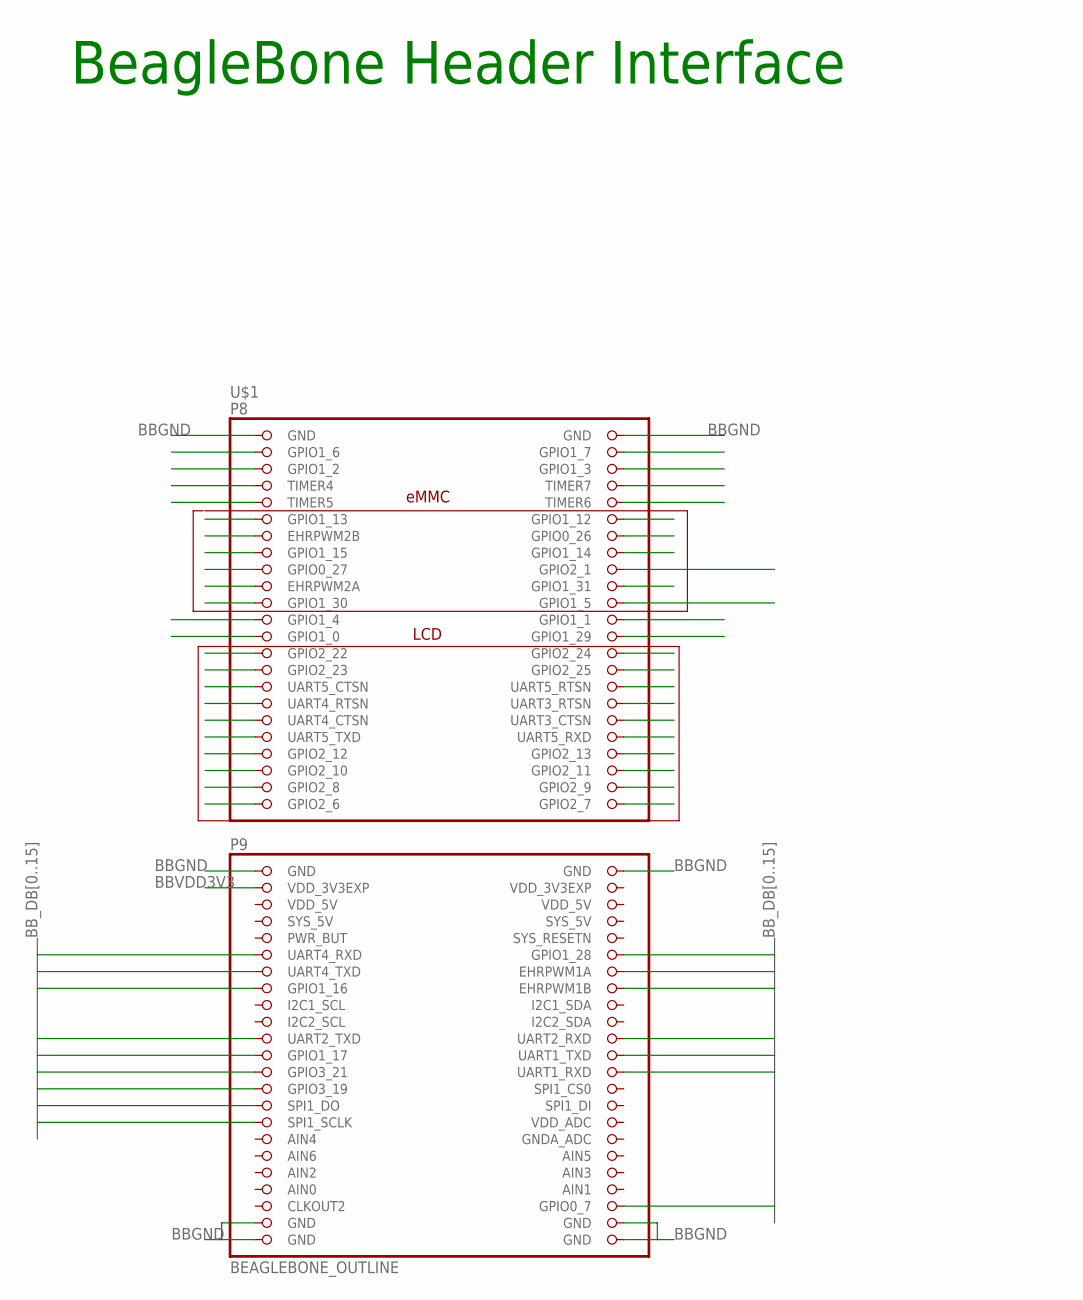
[picture p61: schematic NILMCape.sch, sheet 6]

Parts:
U$1: BEAGLEBONE_OUTLINE; BEAGLEBONE_SHIELD

Connections:
AIN0: U$1.85 (AIN0)
BBGND: U$1.1 (GND), U$1.2 (GND), U$1.47 (GND), U$1.48 (GND), U$1.89 (GND), U$1.90 (GND), U$1.91 (GND), U$1.92 (GND); also elsewhere on the board
BBVDD3V3: U$1.49 (VDD_3V3EXP); also elsewhere on the board
BB_DB0: U$1.57 (UART4_RXD); also elsewhere on the board
BB_DB1: U$1.59 (UART4_TXD); also elsewhere on the board
BB_DB2: U$1.61 (GPIO1_16); also elsewhere on the board
BB_DB3: U$1.67 (UART2_TXD); also elsewhere on the board
BB_DB4: U$1.69 (GPIO1_17); also elsewhere on the board
BB_DB5: U$1.71 (GPIO3_21); also elsewhere on the board
BB_DB6: U$1.73 (GPIO3_19); also elsewhere on the board
BB_DB7: U$1.75 (SPI1_DO); also elsewhere on the board
BB_DB8: U$1.77 (SPI1_SCLK); also elsewhere on the board
BB_DB9: U$1.58 (GPIO1_28); also elsewhere on the board
BB_DB10: U$1.60 (EHRPWM1A); also elsewhere on the board
BB_DB11: U$1.62 (EHRPWM1B); also elsewhere on the board
BB_DB12: U$1.68 (UART2_RXD); also elsewhere on the board
BB_DB13: U$1.70 (UART1_TXD); also elsewhere on the board
BB_DB14: U$1.72 (UART1_RXD); also elsewhere on the board
BB_DB15: U$1.88 (GPIO0_7); also elsewhere on the board
SYS_5V: U$1.53 (SYS_5V)
VDD_3V3EXP: U$1.50 (VDD_3V3EXP)
VDD_5V: U$1.51 (VDD_5V), U$1.52 (VDD_5V)

Notes on the sheet:
eMMC
LCD
BeagleBone Header Interface

Board: 2 copper layers, 125 parts (0 on the bottom side), 154 nets, no tracks yet.
