FrauBluher/ShR2/Hardware/PIC32 Based Hardware/Power Supply/Split12VoltForTesting.brd

## EAGLE design Hardware/PIC32 Based Hardware/Power Supply/Split12VoltForTesting.brd (2014-11-11)

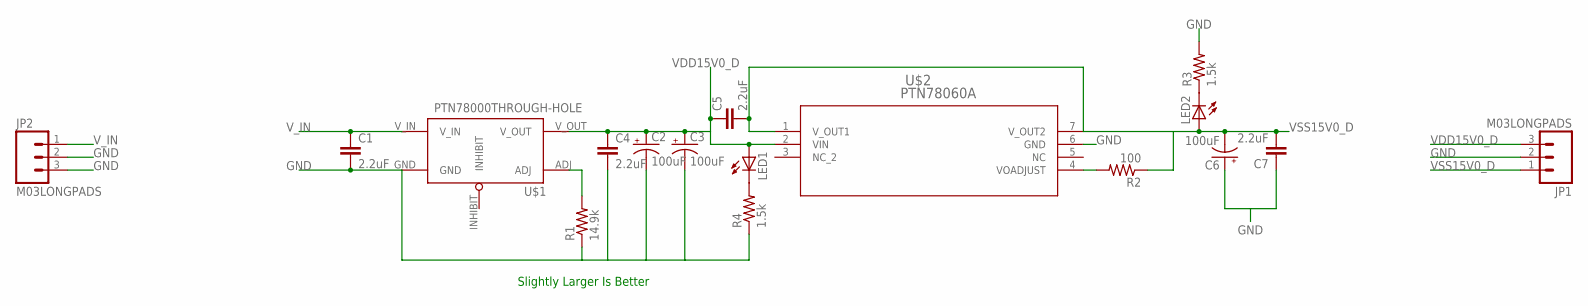
[picture p62: schematic Split12VoltForTesting.sch]

Parts:
C1, C4, C5, C7: 2.2uF; 1210
C2, C3, C6: 100uF; CPOL-RADIAL-100UF-25V
JP1, JP2: M03LONGPADS; 1X03_LONGPADS
LED1, LED2: LED0805; LED-0805
R1: 14.9k; 0805
R2: 100; 0805
R3, R4: 1.5k; 0805
U$1: PTN78000THROUGH-HOLE; PTN78000
U$2: PTN78060A; PTN_EUW

Connections:
GND: C1.2, C2.2 (-), C3.2 (-), C4.2, C6.1 (+), C7.1, JP1.2, JP2.2, JP2.3, R1.1, R3.2, R4.1, U$1.GND, U$2.6 (GND)
unnamed: LED2.2 (C), R3.1
unnamed: R2.2, U$2.4 (VOADJUST)
unnamed: R1.2, U$1.ADJ
unnamed: LED1.2 (C), R4.2
VDD15V0_D: C2.1 (+), C3.1 (+), C4.1, C5.1, JP1.3, LED1.1 (A), U$1.V_OUT, U$2.2 (VIN)
VSS15V0_D: C5.2, C6.2 (-), C7.2, JP1.1, LED2.1 (A), R2.1, U$2.1 (V_OUT1), U$2.7 (V_OUT2)
V_IN: C1.1, JP2.1, U$1.V_IN

Notes on the sheet:
Slightly Larger Is Better

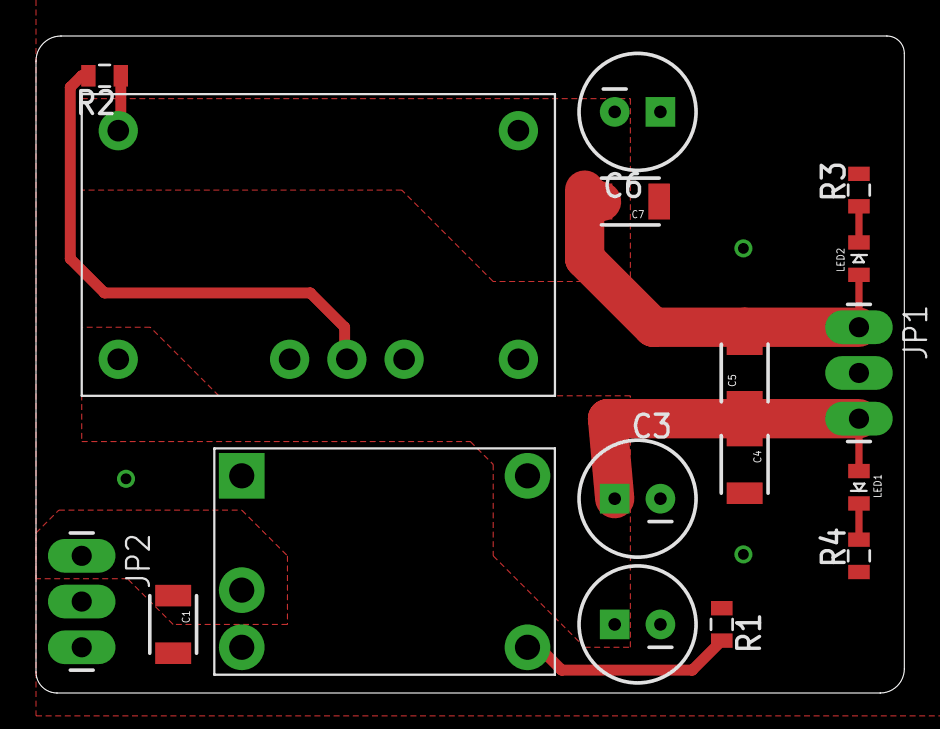
[picture p63: board Split12VoltForTesting.brd from above]

Board: 2 copper layers, 48.2 x 36.5 mm, 17 parts (0 on the bottom side), 8 nets.
