FrauBluher/ShR2/Hardware/PIC32 Based Hardware/Filtering/FilterBoard_+-8V_MAX.brd

## EAGLE design Hardware/PIC32 Based Hardware/Filtering/FilterBoard_+-8V_MAX.brd (2014-06-27)

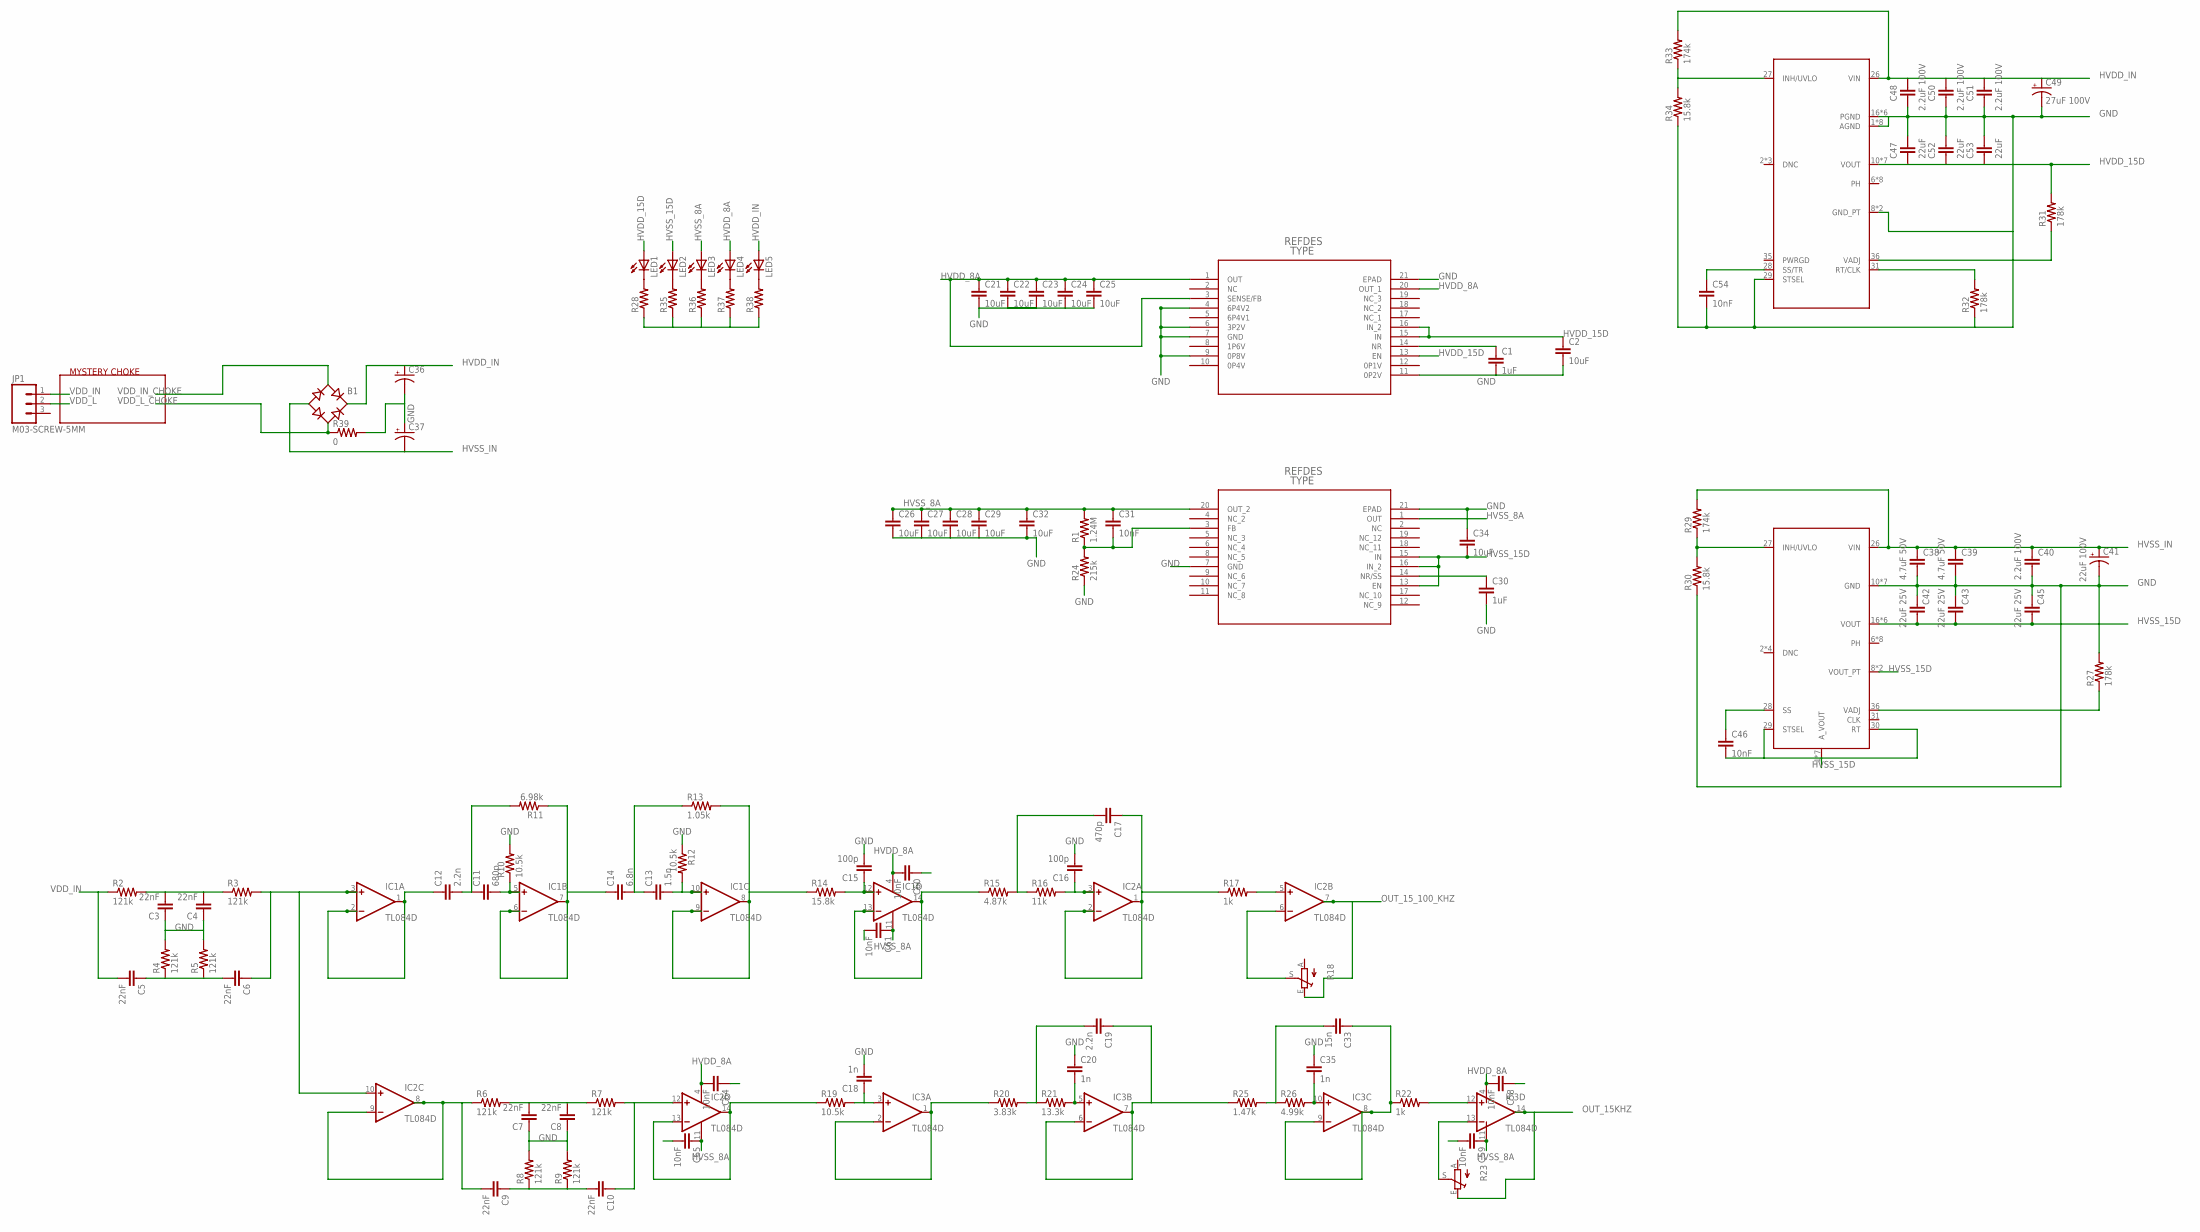
[picture p64: schematic FilterBoard_+-8V_MAX.sch]

Parts:
B1: B-DIL
C1, C30: 1uF; 0805
C2, C34: 10uF; 1206
C3, C4, C5, C6, C7, C8, C9, C10: 22nF; 1206
C11: 680p; 1206
C12, C19: 2.2n; 1206
C13: 1.5n; 1206
C14: 6.8n; 1206
C15, C16: 100p; 1206
C17: 470p; 1206
C18, C20, C35: 1n; 1206
C21, C22, C23, C24, C25, C26, C27, C28, C29, C32: 10uF; 0805
C31, C46, C54, C58, C59, C60, C61, C64, C65: 10nF; 0805
C33: 15n; 1206
C36, C37: CAP_POLPTH3; CPOL-RADIAL-1000UF-63V
C38, C39: 4.7uF 50V; 1210
C40, C48, C50, C51: 2.2uF 100V; 1210
C41: 22uF 100V; CPOL-RADIAL-100UF-25V
C42, C43, C45: 22uF 25V; 1210
C47, C52, C53: 22uF; 1210
C49: 27uF 100V; CPOL-RADIAL-100UF-25V
IC1, IC2, IC3: TL084D; SO14
JP1: M03-SCREW-5MM; SCREWTERMINAL-5MM-3
LED1, LED2, LED3, LED4, LED5: LED1206; LED-1206
R1: 1.24M; 0805
R2, R3, R4, R5, R6, R7, R8, R9: 121k; 0805
R10, R12, R19: 10.5k; 0805
R11: 6.98k; 0805
R13: 1.05k; 0805
R14, R30, R34: 15.8k; 0805
R15: 4.87k; 0805
R16: 11k; 0805
R17, R22: 1k; 0805
R18, R23: TRIM_EU-B90P; SP19L
R20: 3.83k; 0805
R21: 13.3k; 0805
R24: 215k; 0805
R25: 1.47k; 0805
R26: 4.99k; 0805
R27, R31, R32: 178k; 0805
R28, R35, R36, R37, R38: RESISTOR0805-RES; 0805
R29, R33: 174k; 0805
R39: 0; 1206
U7: TPS7A3301_RGW_20; RGW20_3P15X3P15
U8: TPS84250_RKG_41; RKG41
U$1: TPS84259_RKG_41; RKG41
U$2: TPS7A4700_RGW_20; RGW20_3P15X3P15

Connections:
GND: C1.2, C2.2, C3.1, C4.1, C7.1, C8.1, C15.2, C16.2, C18.2, C20.1, C21.2, C22.2, C23.2, C24.2, C25.2, C26.2, C27.2, C28.2, C29.2, C30.2, C32.2, C34.1, C35.1, C36.2 (-), C37.1 (+), C38.2, C39.2, C40.2, C41.2 (-), C42.1, C43.1, C45.1, C47.1, C48.2, C49.2 (-), C50.2, C51.2, C52.1, C53.1, C54.2, C58.1, C59.2, C60.1, C61.2, C64.1, C65.2, R4.2, R5.2, R8.2, R9.2, R10.2, R12.1, R24.1, R27.2, R28.1, R30.1, R32.1, R34.1, R35.1, R36.1, R37.1, R38.1, R39.2, U7.7 (GND), U7.21 (EPAD), U8.1 (AGND), U8.4 (AGND), U8.5 (AGND), U8.8 (GND_PT), U8.9 (GND_PT), U8.16 (PGND), U8.17 (PGND), U8.18 (PGND), U8.19 (PGND), U8.20 (PGND), U8.29 (STSEL), U8.30 (AGND), U8.32 (AGND), U8.33 (AGND), U8.34 (AGND), U8.37 (AGND), U8.40 (PGND), U$1.10 (GND), U$1.11 (GND), U$1.12 (GND), U$1.13 (GND), U$1.14 (GND), U$1.15 (GND), U$1.39 (GND), U$2.4 (6P4V2), U$2.6 (3P2V), U$2.7 (GND), U$2.9 (0P8V), U$2.11 (0P2V), U$2.21 (EPAD)
HVDD_8A: C21.1, C22.1, C23.1, C24.1, C25.1, C58.2, C60.2, C64.2, IC1.4 (V+), IC2.4 (V+), IC3.4 (V+), LED4.A, U$2.1 (OUT), U$2.3 (SENSE/FB), U$2.20 (OUT_1)
HVDD_15D: C2.1, C47.2, C52.2, C53.2, LED1.A, R31.2, U8.10 (VOUT), U8.11 (VOUT), U8.12 (VOUT), U8.13 (VOUT), U8.14 (VOUT), U8.15 (VOUT), U8.39 (VOUT), U$2.13 (EN), U$2.15 (IN), U$2.16 (IN_2)
HVDD_IN: B1.+, C36.1 (+), C48.1, C49.1 (+), C50.1, C51.1, LED5.A, R33.2, U8.26 (VIN)
HVSS_8A: C26.1, C27.1, C28.1, C29.1, C31.1, C32.1, C59.1, C61.1, C65.1, IC1.11 (V-), IC2.11 (V-), IC3.11 (V-), LED3.A, R1.2, U7.1 (OUT), U7.20 (OUT_2)
HVSS_15D: C34.2, C42.2, C43.2, C45.2, C46.2, LED2.A, U7.13 (EN), U7.15 (IN), U7.16 (IN_2), U$1.1 (A_VOUT), U$1.4 (A_VOUT), U$1.5 (A_VOUT), U$1.8 (VOUT_PT), U$1.9 (VOUT_PT), U$1.16 (VOUT), U$1.17 (VOUT), U$1.18 (VOUT), U$1.19 (VOUT), U$1.20 (VOUT), U$1.29 (STSEL), U$1.30 (RT), U$1.32 (A_VOUT), U$1.33 (A_VOUT), U$1.34 (A_VOUT), U$1.37 (A_VOUT), U$1.40 (VOUT)
HVSS_IN: B1.-, C37.2 (-), C38.1, C39.1, C40.1, C41.1 (+), R29.2, U$1.26 (VIN)
unnamed: C1.1, U$2.14 (NR)
unnamed: C3.2, C4.2, R2.2, R3.1
unnamed: C9.2, IC2.8 (OUT), IC2.9 (-IN), R6.1
unnamed: C33.1, IC3.8 (OUT), IC3.9 (-IN), R22.1
unnamed: C5.1, C6.2, R4.1, R5.1
unnamed: C7.2, C8.2, R6.2, R7.1
unnamed: C6.1, IC1.3 (+IN), IC2.10 (+IN), R3.2
unnamed: C31.2, R1.1, R24.2, U7.3 (FB)
unnamed: C9.1, C10.2, R8.1, R9.1
unnamed: C10.1, IC2.12 (+IN), R7.2
unnamed: C12.1, IC1.1 (OUT), IC1.2 (-IN)
unnamed: C11.1, C12.2, R11.2
unnamed: C11.2, IC1.5 (+IN), R10.1
unnamed: C14.1, IC1.6 (-IN), IC1.7 (OUT), R11.1
unnamed: IC1.8 (OUT), IC1.9 (-IN), R13.2, R14.1
unnamed: IC1.13 (-IN), IC1.14 (OUT), R15.1
unnamed: C17.1, IC2.1 (OUT), IC2.2 (-IN), R17.1
unnamed: IC2.6 (-IN), R18.S
unnamed: C35.2, IC3.10 (+IN), R26.2
unnamed: IC3.12 (+IN), R22.2
unnamed: IC3.13 (-IN), R23.S
unnamed: C33.2, R25.2, R26.1
unnamed: C19.1, IC3.6 (-IN), IC3.7 (OUT), R25.1
unnamed: R27.1, U$1.36 (VADJ)
unnamed: C20.2, IC3.5 (+IN), R21.2
unnamed: C19.2, R20.2, R21.1
unnamed: IC3.1 (OUT), IC3.2 (-IN), R20.1
unnamed: C18.1, IC3.3 (+IN), R19.2
unnamed: LED1.C, R28.2
unnamed: IC2.13 (-IN), IC2.14 (OUT), R19.1
unnamed: R29.1, R30.2, U$1.27 (INH/UVLO)
unnamed: C30.1, U7.14 (NR/SS)
unnamed: C46.1, U$1.28 (SS)
unnamed: C13.1, C14.2, R13.1
unnamed: C13.2, IC1.10 (+IN), R12.2
unnamed: R31.1, U8.36 (VADJ)
unnamed: C15.1, IC1.12 (+IN), R14.2
unnamed: R32.2, U8.31 (RT/CLK)
unnamed: C17.2, R15.2, R16.1
unnamed: C16.1, IC2.3 (+IN), R16.2
unnamed: IC2.5 (+IN), R17.2
unnamed: R33.1, R34.2, U8.27 (INH/UVLO)
unnamed: C54.1, U8.28 (SS/TR)
unnamed: LED2.C, R35.2
unnamed: LED3.C, R36.2
unnamed: LED4.C, R37.2
unnamed: LED5.C, R38.2
OUT_15KHZ: IC3.14 (OUT), R23.E
OUT_15_100_KHZ: IC2.7 (OUT), R18.E
VDD_IN: C5.2, JP1.1, R2.1
VDD_IN_CHOKE: B1.AC1
VDD_L: JP1.2
VDD_L_CHOKE: B1.AC2, R39.1

Notes on the sheet:
MYSTERY CHOKE

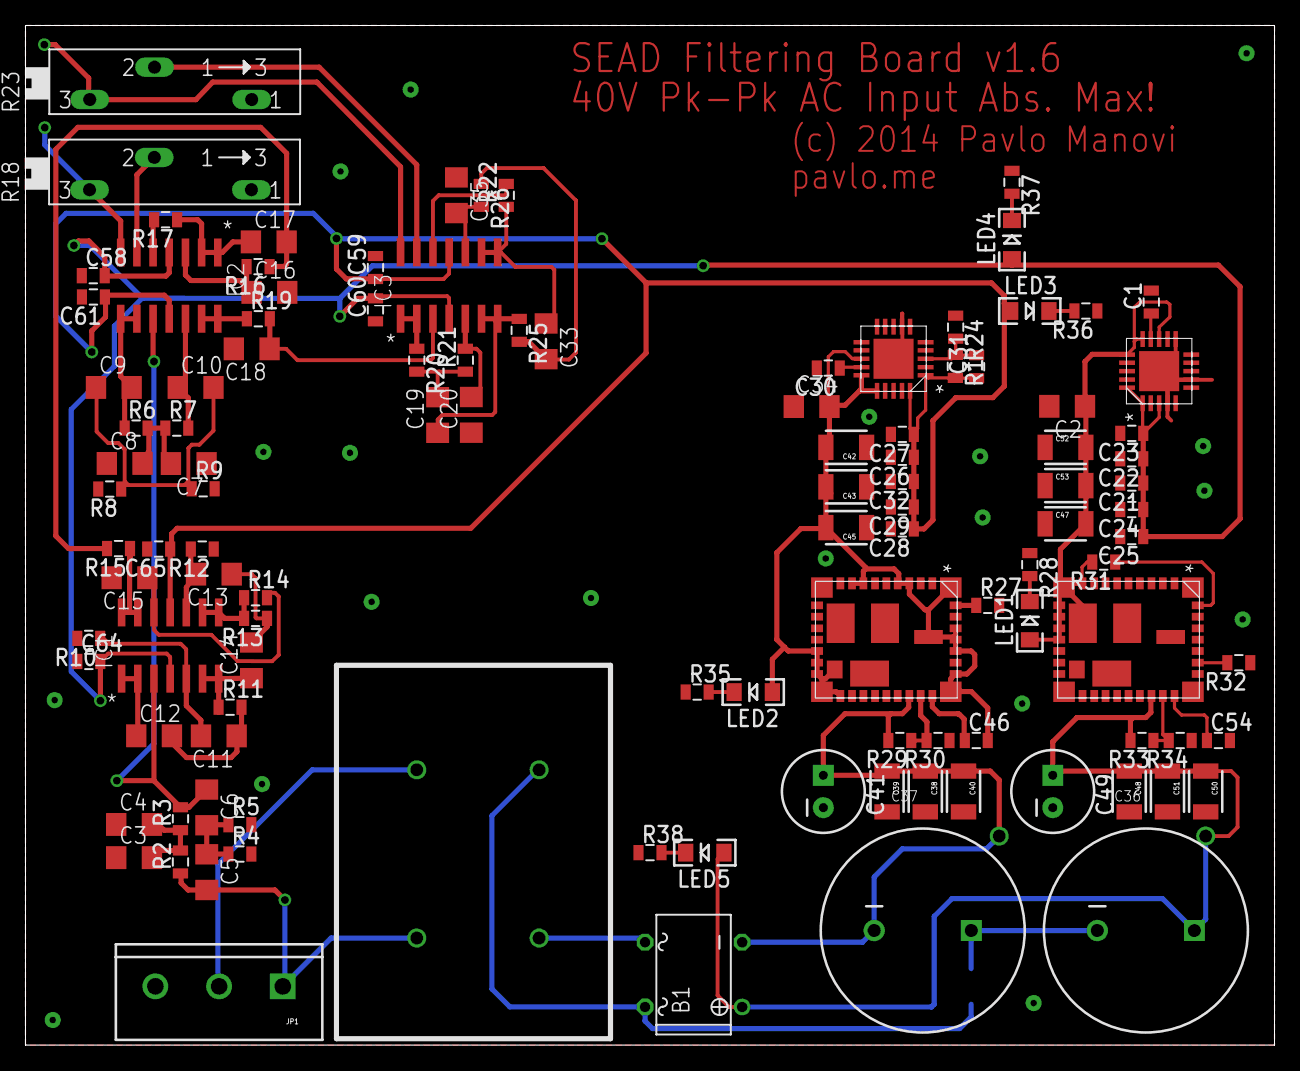
[picture p65: board FilterBoard_+-8V_MAX.brd from above]

Board: 2 copper layers, 98.0 x 80.0 mm, 112 parts (1 on the bottom side), 58 nets.
