FrauBluher/ShR2/Hardware/PIC32 Based Hardware/ADC Breakout/ADCBreakout.brd

## EAGLE design Hardware/PIC32 Based Hardware/ADC Breakout/ADCBreakout.brd (2014-05-08)

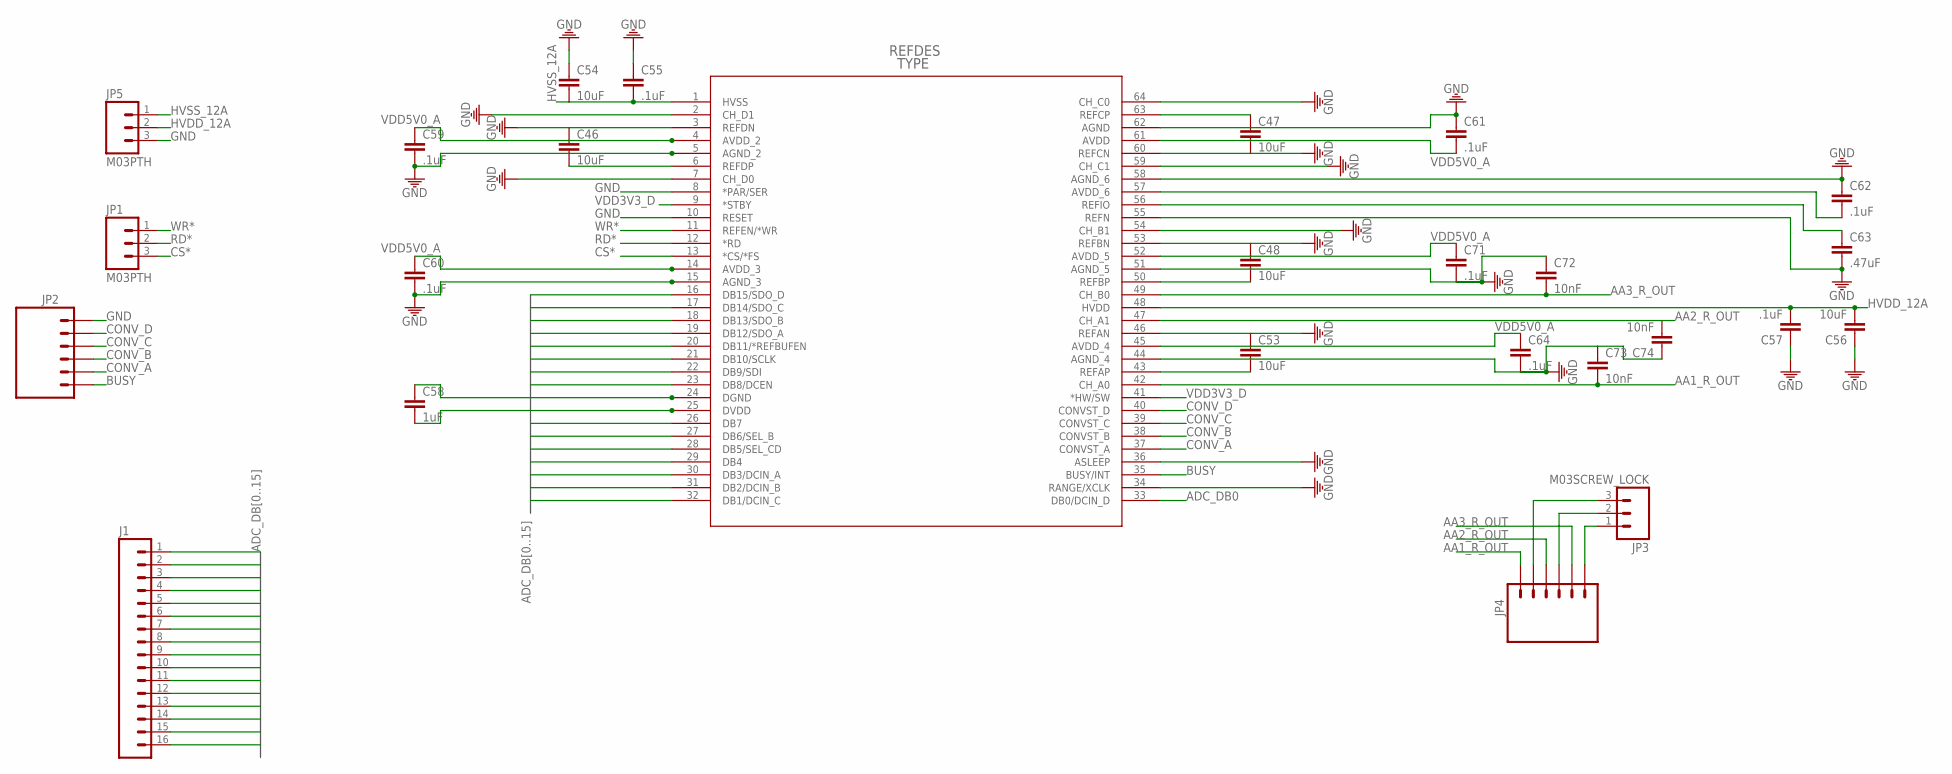
[picture p66: schematic ADCBreakout.sch, sheet 1]

Parts:
C46, C47, C48, C53, C54, C56: 10uF; 0805
C55, C57, C59, C60, C61, C62, C64, C71: .1uF; 0805
C58: 1uF; 0805
C63: .47uF; 0805
C72, C73, C74: 10nF; 0805
J1: M16PTH; 1X16
JP1, JP5: M03PTH; 1X03
JP2, JP4: M06SIP; 1X06
JP3: M03SCREW_LOCK; SCREWTERMINAL-3.5MM-3_LOCK.007S
U1: ADS8568_PM_64; PM64

Connections:
AA1_R_OUT: C73.2, JP4.1, U1.42 (CH_A0)
AA2_R_OUT: C74.2, JP4.3, U1.47 (CH_A1)
AA3_R_OUT: C72.2, JP4.5, U1.49 (CH_B0)
ADC_DB0: J1.1, U1.33 (DB0/DCIN_D)
ADC_DB1: J1.2, U1.32 (DB1/DCIN_C)
ADC_DB2: J1.3, U1.31 (DB2/DCIN_B)
ADC_DB3: J1.4, U1.30 (DB3/DCIN_A)
ADC_DB4: J1.5, U1.29 (DB4)
ADC_DB5: J1.6, U1.28 (DB5/SEL_CD)
ADC_DB6: J1.7, U1.27 (DB6/SEL_B)
ADC_DB7: J1.8, U1.26 (DB7)
ADC_DB8: J1.9, U1.23 (DB8/DCEN)
ADC_DB9: J1.10, U1.22 (DB9/SDI)
ADC_DB10: J1.11, U1.21 (DB10/SCLK)
ADC_DB11: J1.12, U1.20 (DB11/*REFBUFEN)
ADC_DB12: J1.13, U1.19 (DB12/SDO_A)
ADC_DB13: J1.14, U1.18 (DB13/SDO_B)
ADC_DB14: J1.15, U1.17 (DB14/SDO_C)
ADC_DB15: J1.16, U1.16 (DB15/SDO_D)
BUSY: JP2.6, U1.35 (BUSY/INT)
CONV_A: JP2.5, U1.37 (CONVST_A)
CONV_B: JP2.4, U1.38 (CONVST_B)
CONV_C: JP2.3, U1.39 (CONVST_C)
CONV_D: JP2.2, U1.40 (CONVST_D)
CS*: JP1.3, U1.13 (*CS/*FS)
GND: C46.1, C47.2, C48.1, C53.1, C54.1, C55.1, C56.1, C57.1, C58.1, C59.2, C60.2, C61.1, C62.1, C63.2, C64.2, C71.2, C72.1, C73.1, C74.1, JP2.1, JP5.3, U1.2 (CH_D1), U1.3 (REFDN), U1.5 (AGND_2), U1.7 (CH_D0), U1.8 (*PAR/SER), U1.10 (RESET), U1.15 (AGND_3), U1.24 (DGND), U1.34 (RANGE/XCLK), U1.36 (ASLEEP), U1.44 (AGND_4), U1.46 (REFAN), U1.51 (AGND_5), U1.53 (REFBN), U1.54 (CH_B1), U1.55 (REFN), U1.58 (AGND_6), U1.59 (CH_C1), U1.60 (REFCN), U1.62 (AGND), U1.64 (CH_C0); also elsewhere on the board
HVDD_12A: C56.2, C57.2, JP5.2, U1.48 (HVDD); also elsewhere on the board
HVSS_12A: C54.2, C55.2, JP5.1, U1.1 (HVSS)
unnamed: JP3.3, JP4.2
unnamed: JP3.2, JP4.4
unnamed: JP3.1, JP4.6
unnamed: C63.1, U1.56 (REFIO)
unnamed: C46.2, U1.6 (REFDP)
unnamed: C53.2, U1.43 (REFAP)
unnamed: C48.2, U1.50 (REFBP)
unnamed: C47.1, U1.63 (REFCP)
RD*: JP1.2, U1.12 (*RD)
VDD3V3_D: C58.2, U1.9 (*STBY), U1.25 (DVDD), U1.41 (*HW/SW); also elsewhere on the board
VDD5V0_A: C59.1, C60.1, C61.2, C62.2, C64.1, C71.1, U1.4 (AVDD_2), U1.14 (AVDD_3), U1.45 (AVDD_4), U1.52 (AVDD_5), U1.57 (AVDD_6), U1.61 (AVDD); also elsewhere on the board
WR*: JP1.1, U1.11 (REFEN/*WR)

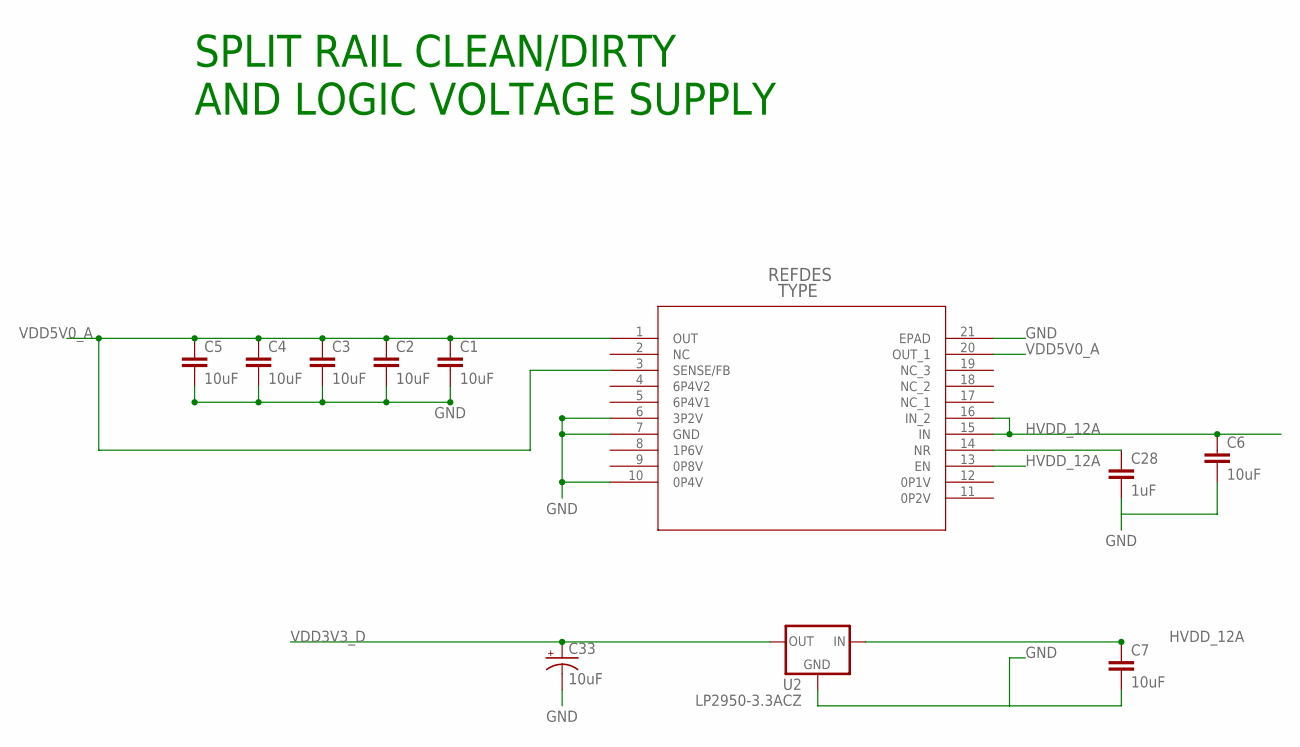
[picture p67: schematic ADCBreakout.sch, sheet 2]

Parts:
C1, C2, C3, C4, C5, C6, C7: 10uF; 0805
C28: 1uF; 0805
C33: 10uF; CPOL-RADIAL-10UF-25V
U2: LP2950-3.3ACZ; TO92
U$3: TPS7A4700_RGW_20; RGW20_3P15X3P15

Connections:
GND: C1.2, C2.2, C3.2, C4.2, C5.2, C6.2, C7.2, C28.2, C33.2 (-), U2.2 (GND), U$3.6 (3P2V), U$3.7 (GND), U$3.10 (0P4V), U$3.21 (EPAD); also elsewhere on the board
HVDD_12A: C6.1, C7.1, U2.3 (IN), U$3.13 (EN), U$3.15 (IN), U$3.16 (IN_2); also elsewhere on the board
unnamed: C28.1, U$3.14 (NR)
VDD3V3_D: C33.1 (+), U2.1 (OUT); also elsewhere on the board
VDD5V0_A: C1.1, C2.1, C3.1, C4.1, C5.1, U$3.1 (OUT), U$3.3 (SENSE/FB), U$3.20 (OUT_1); also elsewhere on the board

Notes on the sheet:
SPLIT RAIL CLEAN/DIRTY AND LOGIC VOLTAGE SUPPLY

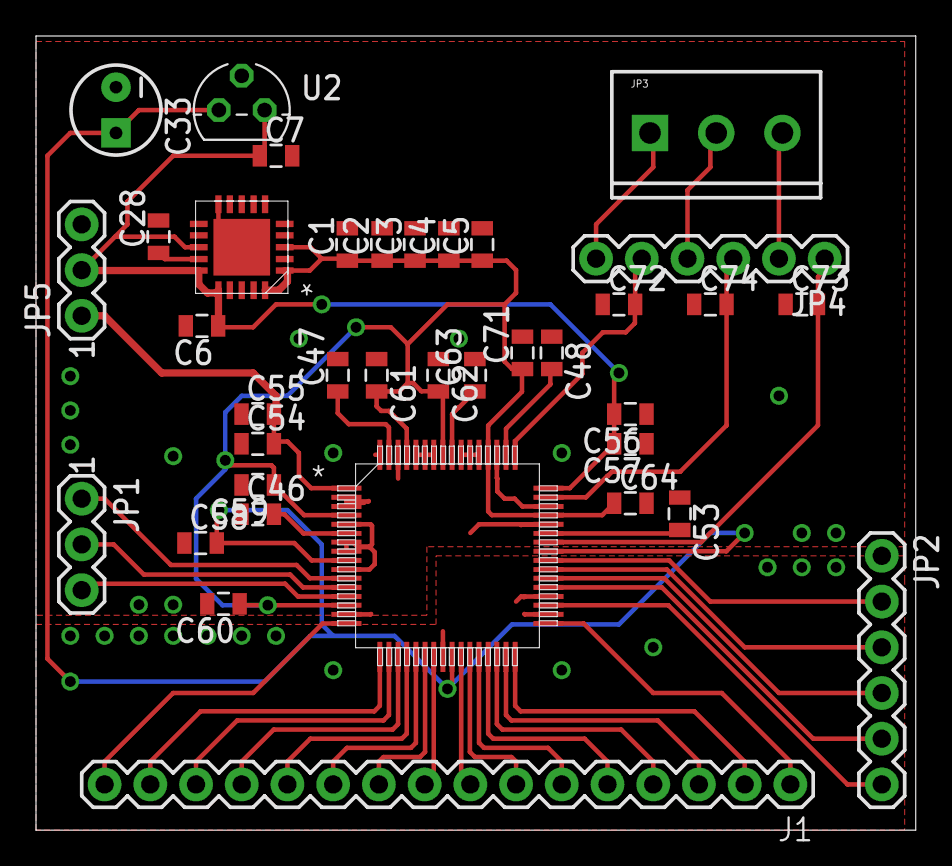
[picture p68: board ADCBreakout.brd from above]

Board: 2 copper layers, 48.9 x 44.1 mm, 37 parts (0 on the bottom side), 41 nets.
