FrauBluher/ShR2/Hardware/PIC32 Based Hardware/Power Supply/CapePowerSupplyModule.brd

## EAGLE design Hardware/PIC32 Based Hardware/Power Supply/CapePowerSupplyModule.brd (2014-04-12)

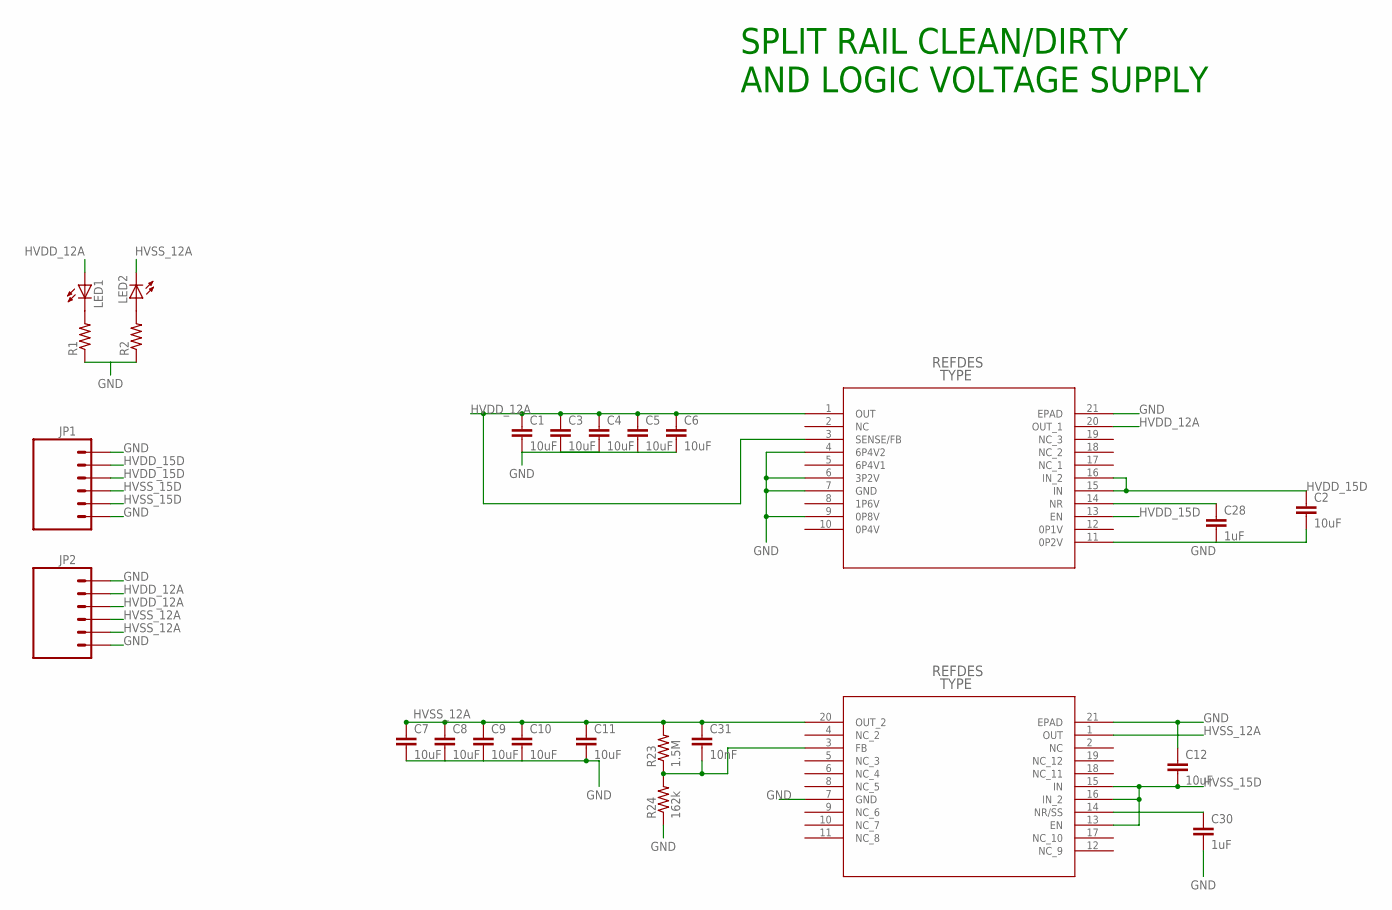
[picture p69: schematic CapePowerSupplyModule.sch]

Parts:
C1, C2, C3, C4, C5, C6, C7, C8, C9, C10, C11, C12: 10uF; 1206
C28, C30: 1uF; 0805
C31: 10nF; 0805
JP1, JP2: M06LOCK; 1X06_LOCK
LED1, LED2: LED1206; LED-1206
R1, R2: RESISTOR0805-RES; 0805
R23: 1.5M; 0805
R24: 162k; 0805
U6: TPS7A3301_RGW_20; RGW20_3P15X3P15
U$3: TPS7A4700_RGW_20; RGW20_3P15X3P15

Connections:
GND: C1.2, C2.2, C3.2, C4.2, C5.2, C6.2, C7.2, C8.2, C9.2, C10.2, C11.2, C12.1, C28.2, C30.2, JP1.1, JP1.6, JP2.1, JP2.6, R1.1, R2.1, R24.1, U6.7 (GND), U6.21 (EPAD), U$3.4 (6P4V2), U$3.6 (3P2V), U$3.7 (GND), U$3.9 (0P8V), U$3.11 (0P2V), U$3.21 (EPAD)
HVDD_12A: C1.1, C3.1, C4.1, C5.1, C6.1, JP2.2, JP2.3, LED1.A, U$3.1 (OUT), U$3.3 (SENSE/FB), U$3.20 (OUT_1)
HVDD_15D: C2.1, JP1.2, JP1.3, U$3.13 (EN), U$3.15 (IN), U$3.16 (IN_2)
HVSS_12A: C7.1, C8.1, C9.1, C10.1, C11.1, C31.1, JP2.4, JP2.5, LED2.C, R23.2, U6.1 (OUT), U6.20 (OUT_2)
HVSS_15D: C12.2, JP1.4, JP1.5, U6.13 (EN), U6.15 (IN), U6.16 (IN_2)
unnamed: LED1.C, R1.2
unnamed: LED2.A, R2.2
unnamed: C31.2, R23.1, R24.2, U6.3 (FB)
unnamed: C30.1, U6.14 (NR/SS)
unnamed: C28.1, U$3.14 (NR)

Notes on the sheet:
SPLIT RAIL CLEAN/DIRTY AND LOGIC VOLTAGE SUPPLY

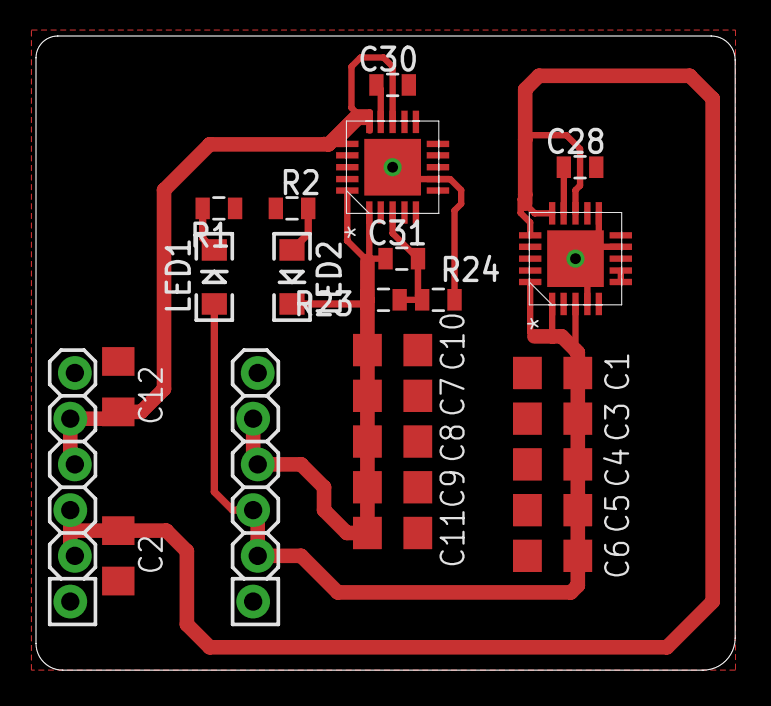
[picture p70: board CapePowerSupplyModule.brd from above]

Board: 2 copper layers, 38.8 x 35.2 mm, 25 parts (0 on the bottom side), 10 nets.
