FrauBluher/ShR2/Hardware/PIC32 Based Hardware/SEAD Light/SEADLight.brd

## EAGLE design Hardware/PIC32 Based Hardware/SEAD Light/SEADLight.brd (2015-05-26)

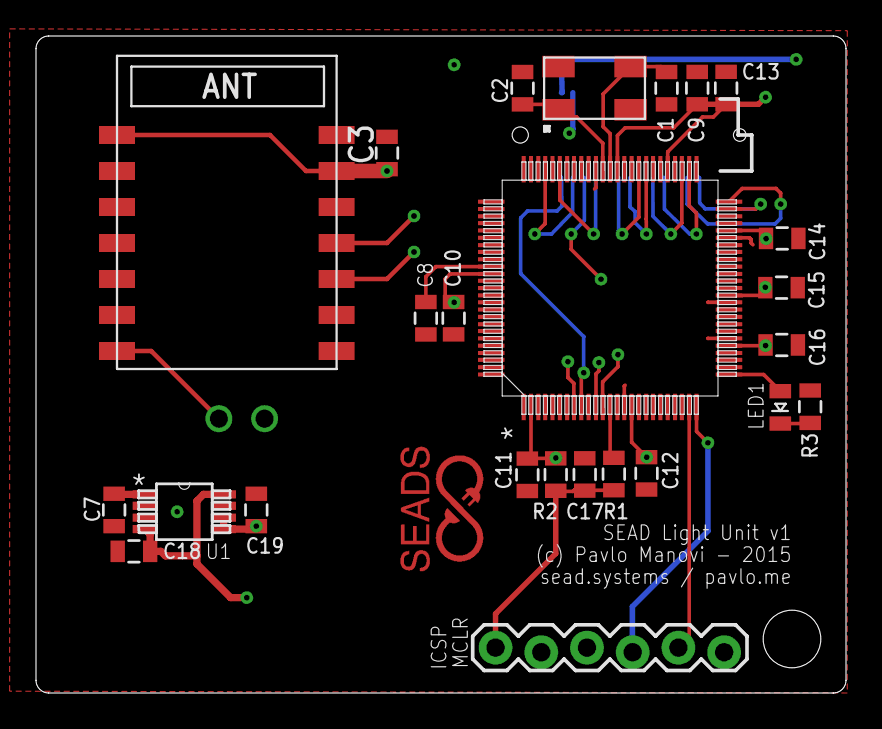
[picture p71: board SEADLight.brd from above]

Board: 4 copper layers, 45.0 x 36.5 mm, 26 parts (1 on the bottom side), 25 nets.

Parts:
C1, C2: 20pF; 0805
C3, C19: 4.7uF; 0805
C7: .01uF; 0805
C8: 10uF; 0805
C9, C10, C11, C12, C13, C14, C15, C16, C17: .1uF; 0805
C18: 2.2uF; 0805
JP6: 1X06-SIP_LOCK
LED1: LED-0805
R1: 470; 0805
R2: 10k; 0805
R3: 330; 0805
U1: LP2989_DGK_8; MUA08A
U$1: PIC32MX795F512L-; TQFP100_12X12MC
U$2: ABM3B-8.000MHZ-10-1-U-T; ABM3B
U$3: EPS8266; ESP8266-03
X1: 52885-0374

Connections:
ESP_UART_RX: U$1.12, U$3.4
ESP_UART_TX: U$1.11, U$3.3
GND: C1.2, C2.1, C3.2, C7.1, C8.1, C9.1, C10.1, C11.1, C12.1, C13.1, C14.1, C15.1, C16.1, C17.2, C18.2, C19.1, JP6.3, R3.2, U1.3, U$1.15, U$1.31, U$1.36, U$1.45, U$1.65, U$1.75, U$2.2, U$2.4, U$3.1, U$3.12, X1.1, X1.2, X1.12, X1.18, X1.24, X1.29, X1.30
MCLR: C17.1, JP6.1, R1.1, R2.1
MISO: U$1.9, X1.4
MOSI: U$1.72, X1.6
unnamed: C1.1, U$1.63, U$2.3
unnamed: C2.2, U$1.64, U$2.1
unnamed: C8.2, U$1.85
unnamed: R1.2, U$1.13
unnamed: LED1.1, U$1.26
unnamed: LED1.2, R3.1
unnamed: C7.2, U1.1
PGC: JP6.5, U$1.24
PGD: JP6.4, U$1.25
SCK: U$1.70, X1.10
SCL: U$1.58, X1.16
SDA: U$1.59, X1.14
SS: U$1.8, X1.8
U1RX: U$1.52, X1.22
U1TX: U$1.53, X1.20
U3RX: U$1.49, X1.28
U3TX: U$1.50, X1.26
VDD3V3_D: C3.1, C9.2, C10.2, C11.2, C12.2, C13.2, C14.2, C15.2, C16.2, C19.2, JP6.2, R2.2, U1.5, U1.6, U$1.2, U$1.16, U$1.30, U$1.37, U$1.46, U$1.55, U$1.62, U$1.86, U$3.6, U$3.8, X1.5
VDD5V0_D: C18.1, U1.4, U1.8, X1.3
