FrauBluher/ShR2/Hardware/PIC32 Based Hardware/DAQ/Eagle Files/ADCModule.brd

## EAGLE design Hardware/PIC32 Based Hardware/DAQ/Eagle Files/ADCModule.brd (2015-05-05)

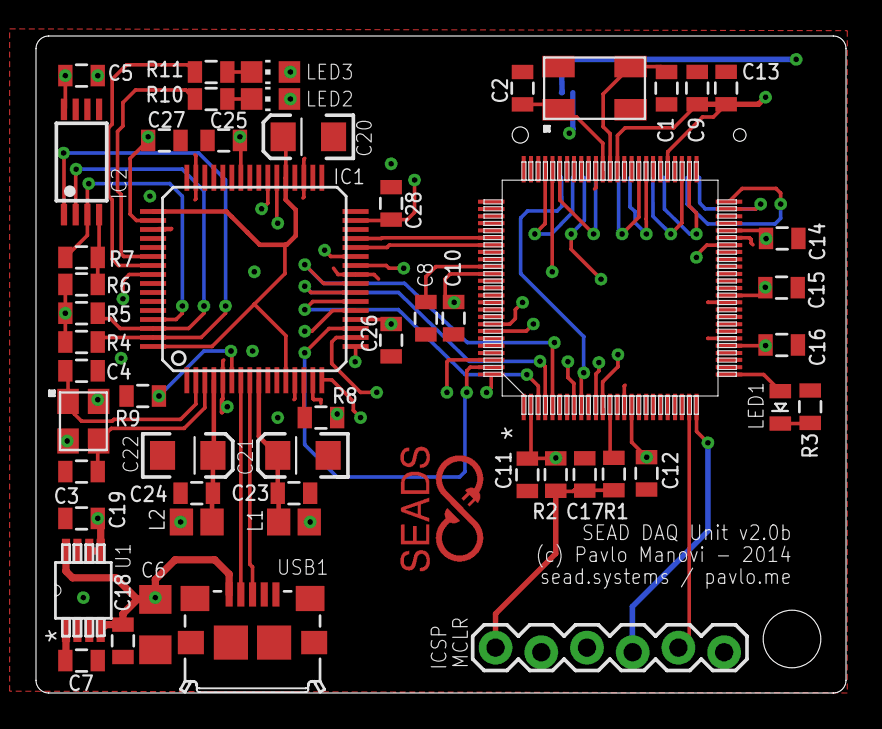
[picture p72: board ADCModule.brd from above]

Board: 4 copper layers, 45.0 x 36.5 mm, 53 parts (1 on the bottom side), 54 nets.

Parts:
C1, C2, C3, C4: 20pF; 0805
C5, C9, C10, C11, C12, C13, C14, C15, C16, C17, C23, C24, C25, C26, C27, C28: .1uF; 0805
C6: 100uF; 1206
C7: .01uF; 0805
C8: 10uF; 0805
C18: 2.2uF; 0805
C19: 4.7uF; 0805
C20: 3.3uF; EIA3216
C21, C22: 4.7uF; EIA3216
IC1: LQFP64
IC2: 93-C46AST; TSSOP8
JP6: 1X06-SIP_LOCK
L1, L2: FB805
LED1: LED-0805
LED2, LED3: CHIP-LED0805
R1, R10, R11: 470; 0805
R2, R4, R5, R6, R8: 10k; 0805
R3: 330; 0805
R7: 2.2k; 0805
R9: 12k 1%; 0805
U1: LP2989_DGK_8; MUA08A
U$1: PIC32MX795F512L-; TQFP100_12X12MC
U$2: ABM3B-8.000MHZ-10-1-U-T; ABM3B
U$3: 7M-12.000MEEQ-T; 7M-CRYSTAL
USB1: CON-USB-F-MICRO-B; CONN_USB_MICRO-B
X1: 52885-0374

Connections:
A0: IC1.27, U$1.44
CS*: IC1.26, U$1.71
D0: IC1.16, U$1.93
D1: IC1.17, U$1.94
D2: IC1.18, U$1.98
D3: IC1.19, U$1.99
D4: IC1.21, U$1.100
D5: IC1.22, U$1.3
D6: IC1.23, U$1.4
D7: IC1.24, U$1.5
GND: C1.2, C2.1, C3.2, C4.1, C5.2, C6.1, C7.1, C8.1, C9.1, C10.1, C11.1, C12.1, C13.1, C14.1, C15.1, C16.1, C17.2, C18.2, C19.1, C20.C, C21.C, C22.C, C23.2, C24.2, C25.1, C26.1, C27.1, C28.1, IC1.1, IC1.5, IC1.10, IC1.11, IC1.13, IC1.15, IC1.25, IC1.35, IC1.47, IC1.51, IC2.5, JP6.3, R3.2, R9.2, U1.3, U$1.15, U$1.31, U$1.36, U$1.45, U$1.65, U$1.75, U$2.2, U$2.4, U$3.2, U$3.4, USB1.P5, X1.1, X1.2, X1.12, X1.18, X1.24, X1.29, X1.30
MCLR: C17.1, JP6.1, R1.1, R2.1
MISO: U$1.9, X1.4
MOSI: U$1.72, X1.6
unnamed: C1.1, U$1.63, U$2.3
unnamed: C2.2, U$1.64, U$2.1
unnamed: C8.2, U$1.85
unnamed: C3.1, IC1.3, U$3.3
unnamed: C4.2, IC1.2, U$3.1
unnamed: IC1.7, USB1.P2
unnamed: IC1.8, USB1.P3
unnamed: IC1.63, IC2.1, R4.1
unnamed: IC1.62, IC2.2, R5.1
unnamed: R1.2, U$1.13
unnamed: LED1.1, U$1.26
unnamed: LED1.2, R3.1
unnamed: IC2.4, R6.1, R7.1
unnamed: IC1.61, IC2.3, R7.2
unnamed: IC1.14, R8.1
unnamed: IC1.6, R9.1
unnamed: C22.A, C24.1, IC1.4, L2.1
unnamed: C21.A, C23.1, IC1.9, L1.1
unnamed: C7.2, U1.1
unnamed: IC1.54, R10.2
unnamed: IC1.55, R11.2
unnamed: LED2.C, R10.1
unnamed: LED3.C, R11.1
PGC: JP6.5, U$1.24
PGD: JP6.4, U$1.25
RD*: IC1.28, U$1.82
SCK: U$1.70, X1.10
SCL: U$1.58, X1.16
SDA: U$1.59, X1.14
SS: U$1.8, X1.8
U1RX: U$1.52, X1.22
U1TX: U$1.53, X1.20
U3RX: U$1.49, X1.28
U3TX: U$1.50, X1.26
USB_UART_RX: IC1.39, U$1.12
USB_UART_TX: IC1.38, U$1.11
VCC1V8_D: C20.A, IC1.12, IC1.37, IC1.49, IC1.64
VDD3V3_D: C5.1, C9.2, C10.2, C11.2, C12.2, C13.2, C14.2, C15.2, C16.2, C19.2, C25.2, C26.2, C27.2, C28.2, IC1.20, IC1.31, IC1.42, IC1.50, IC1.56, IC2.8, JP6.2, L1.2, L2.2, LED2.A, LED3.A, R2.2, R4.2, R5.2, R6.2, R8.2, U1.5, U1.6, U$1.2, U$1.16, U$1.30, U$1.37, U$1.46, U$1.55, U$1.62, U$1.86, X1.5
VDD5V0_D: C6.2, C18.1, U1.4, U1.8, USB1.P1, X1.3
WR*: IC1.29, U$1.81
