FrauBluher/ShR2/Hardware/PIC32 Based Hardware/DAQ/ADC Driver Code/SEAD_DAQ_v2.0c_Power/ADCModuleBoard.c

/**
 * The MIT License (MIT)
 *
 * Copyright (c) 2014 Pavlo Milo Manovi
 *
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
 */

/**
 * @file	ADCModuleBoard.c
 * @author 	Pavlo Milo Manovi
 * @date	April, 2014
 * @brief 	Provides implementation to methods which set up the board for
 *		data acquisition.
 */

#include "ADCModuleBoard.h"
#include <plib.h>
#include "DMA_Transfer.h"
#include "MCP391x.h"

#if defined (__32MX360F512L__) || (__32MX460F512L__) || (__32MX795F512L__) || (__32MX430F064L__) || (__32MX450F256L__) || (__32MX470F512L__) || (__32MX320F128L__)
// Configuration Bit settings
// SYSCLK = 80 MHz (8MHz Crystal / FPLLIDIV * FPLLMUL / FPLLODIV)
// PBCLK = 80 MHz (SYSCLK / FPBDIV)
// Primary Osc w/PLL (XT+,HS+,EC+PLL)
// WDT OFF
// Other options are don't care


#pragma config FPLLMUL = MUL_20, FPLLIDIV = DIV_2, FPLLODIV = DIV_1, FWDTEN = OFF
#pragma config POSCMOD = HS, FNOSC = PRIPLL, FPBDIV = DIV_1
#define SYS_FREQ (80000000L)

#pragma config OSCIOFNC = OFF // CLKO Output Signal Active on the OSCO Pin //(Disabled)
#pragma config ICESEL = ICS_PGx1 // ICE/ICD Comm Channel Select (Communicate on //PGEC1/PGED1)
#pragma config PWP = OFF // Program Flash Write Protect (Disable)
#pragma config BWP = OFF // Boot Flash Write Protect bit (Protection //Disabled)
#pragma config CP = OFF // Code Protect (Protection Disabled)


#define SYS_FREQ (80000000L)
#define	GetPeripheralClock()		(SYS_FREQ/(1 << OSCCONbits.PBDIV))
#define UART_MODULE_ID 1
#endif

// Let compile time pre-processor calculate the CORE_TICK_PERIOD
#define TOGGLES_PER_SEC 1000
#define CORE_TICK_RATE  (SYS_FREQ/2/TOGGLES_PER_SEC)
uint32_t counter = 0;
int i;

void __ISR(_CORE_TIMER_VECTOR, ipl2) CoreTimerHandler(void) {
    // Clear the interrupt flag
    INTClearFlag(INT_CT);

    // Update the period
    UpdateCoreTimer(CORE_TICK_RATE);

    counter++;
}

/**
 * @brief Sets up the board with the peripherals defined in the header.
 */
uint8_t ADCModuleBoard_Init(SampleBuffer *BufferA, SampleBuffer *BufferB, MCP391x_Info *MCPInfo)
{
	SYSTEMConfig(SYS_FREQ, SYS_CFG_WAIT_STATES | SYS_CFG_PCACHE);

	LATA = 0;
	LATB = 0;
	LATC = 0;
	LATD = 0;
	LATE = 0;
	LATF = 0;
	LATG = 0;
	AD1PCFG = 0xFFFFFFFF;

	//Set up tristates for the dataports and R/W stuff for the FIFO interface

	//SPI Tristate setup
	SPI_MISO_TRIS = 1;
	SPI_MOSI_TRIS = 0;
	SPI_SCK_TRIS = 0;
	SPI_SS_TRIS = 0;

	//UART tristate setup
	UART_TX_TRIS = 0;
	UART_RX_TRIS = 1;

	//MCP tristate setup
	DR_TRIS = 1;
	RESET_TRIS = 0;

	//FIFO tristate setup
	DB0_TRIS = 0;
	DB1_TRIS = 0;
	DB2_TRIS = 0;
	DB3_TRIS = 0;
	DB4_TRIS = 0;
	DB5_TRIS = 0;
	DB6_TRIS = 0;
	DB7_TRIS = 0;

	CS_TRIS = 0;
	A0_TRIS = 0;
	RD_TRIS = 0;
	WR_LAT = 0;

	//Status LED
	TRISBbits.TRISB6 = 0;

	/*
	 * Depending on if you want to use a DMA transfer and what peripheral you
	 * want to transmit data on you use the following:
	 * - BufferToUART_Init(BufferA, BufferB);
	 * - BufferToSpi_Init(BufferA, BufferB)
	 */

	RESET_LAT = 0;
	for (i = 0; i < 40000; i++) { //RESET MCP3912 To ensure proper config.
		Nop();
	}
	RESET_LAT = 1;
	SPI_SS_LAT = 1;

	BufferToSpi_Init(BufferA, BufferB);
	BufferToUART_Init();
	BufferToPMP_Init();
	DMAStartUARTRX();

	for (i = 0; i < 40000; i++) {
		Nop();
	}

	INTConfigureSystem(INT_SYSTEM_CONFIG_MULT_VECTOR);
	INTEnableInterrupts();
	uint32_t config;
	SetReadyForConfigure();
	LATBbits.LATB6 = 1;
	while (!GetConfig(&config)) {
		
	}
	INTDisableInterrupts();
	LATBbits.LATB6 = 0;
	MCP391x_Init(MCPInfo, &config);

	for (i = 0; i < 400; i++) {
		Nop();
	}

	//Start Acquisition moved to DMA_Lib

	//Change Notification Enable
	int temp;
	mCNOpen(CN_ON | CN_IDLE_CON, CN17_ENABLE, CN17_PULLUP_ENABLE);
	temp = mPORTFRead();
	ConfigIntCN(CHANGE_INT_PRI_3 | CHANGE_INT_ON);
	mCNClearIntFlag();

	// timer
	OpenCoreTimer(CORE_TICK_RATE);

	// Set up the core timer interrupt with a priority of 2 and zero sub-priority
	INTEnable(INT_CT, INT_ENABLED);
	INTSetVectorPriority(INT_CORE_TIMER_VECTOR, INT_PRIORITY_LEVEL_2);
	INTSetVectorSubPriority(INT_CORE_TIMER_VECTOR, INT_SUB_PRIORITY_LEVEL_0);

	INTConfigureSystem(INT_SYSTEM_CONFIG_MULT_VECTOR);
	INTEnableInterrupts();

	StartSPIAcquisition(BUFFER_A);
	//System Initialized Successfully
	return(EXIT_SUCCESS);
}
