FrauBluher/ShR2/ESP8266/ESP8266_SDK/uart_rxtx_PROJECT/user/user_main.c

/*
 * File	: user_main.c
 * This file is part of Espressif's AT+ command set program.
 * Copyright (C) 2013 - 2016, Espressif Systems
 *
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
 * You should have received a copy of the GNU General Public License along
 * with this program.  If not, see <http://www.gnu.org/licenses/>.
 */
#include "ets_sys.h"
#include "driver/uart.h"
#include "osapi.h"
#include "at.h"

#include "send_recv_port.h"
#include "buffers.h"

extern uint8_t at_wifiMode;
extern void user_esp_platform_load_param(void *param, uint16 len);

void user_init(void)
{
	uint8_t userbin;
	uint32_t upFlag;
	at_uartType tempUart;
	//gets the uart type if it was saved, and initializes with that
	//or a default standard uart configuration
	user_esp_platform_load_param((uint32 *)&tempUart, sizeof(at_uartType));
	if(tempUart.saved == 1) {
		uart_init(BIT_RATE_115200, BIT_RATE_115200);
	} else {
		uart_init(BIT_RATE_115200, BIT_RATE_115200);
	}
	at_wifiMode = wifi_get_opmode();
	os_printf("\r\nready!!!\r\n");
	uart0_sendStr("\r\nOK\r\n");
	//at_init();
	send_recv_init();
	uart0_sendStr("init done\r\n");
}
