FrauBluher/ShR2/ESP8266/ESP8266_SDK/sead_wifi_PROJECT/pseudodata.py

import sys
import os
import time
import random
import serial

def main(args):
	#duration = int(args[0])\
	ser = serial.Serial('/dev/ttyUSB0', 115200, timeout = 1)
	print ser
	#ser.open()
	starttime = int(time.time() * 1000)
	while 1:
		ts = int(time.time() * 1000) - starttime
		watt = random.randint(20,100)
		writestring = '$SEDAT,' +str(watt)+','+str(ts)+'\r\n'
		#sys.stdout.write(writestring)
		ser.write(writestring)
		sys.stdout.write(ser.read(ser.inWaiting()))
		time.sleep(.1)
	ser.close()

if __name__ == "__main__":
   main(sys.argv[1:])
