FrauBluher/ShR2/Hardware/PIC32 Based Hardware/DAQ/ADC Driver Code/SEAD_DAQ.X/ADS85x8.c

/**
 * The MIT License (MIT)
 *
 * Copyright (c) 2014 Pavlo Milo Manovi
 *
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
 */

/**
 * @file	ADS85x8.c
 * @author 	Pavlo Milo Manovi
 * @date	April, 2014
 * @brief 	This library provides implementation of methods to init and read the ADS85x8.
 *
 */

#include "ADS85x8.h"
#include "ADCModuleBoard.h"
#include "ParallelIO.h"
#include <stdint.h>
#include <stdlib.h>


static ADS85x8_Info *passedInfoStruct;

/**
 * @brief Sets up the ADS85x8.
 * @param ADS85x8_Params A pointer to a ADS85x8_Info struct which will be updated.
 * @return Returns EXIT_SUCCESS if the device responds with the set configuration.
 */
uint8_t ADS85x8_Init(ADS85x8_Info *DS85x8Info)
{
	ADS85x8_CONFIGREGISTER response;

	DS85x8Info->configRegister.BUSY_INT = BUSY_INT_BUSY;
	DS85x8Info->configRegister.BUSY_POL = BUSY_INT_ACTIVE_HIGH;
	DS85x8Info->configRegister.CLKOUT = CLKOUT_DISABLE;
	DS85x8Info->configRegister.CLKSEL = CLKSEL_INTERNAL;
	DS85x8Info->configRegister.PD_B = PD_B_DISABLE;
	DS85x8Info->configRegister.PD_C = PD_C_DISABLE;
	DS85x8Info->configRegister.PD_D = PD_D_DISABLE;
	DS85x8Info->configRegister.RANGE_A = RANGE_A_4_VREF;
	DS85x8Info->configRegister.RANGE_B = RANGE_B_4_VREF;
	DS85x8Info->configRegister.RANGE_C = RANGE_C_4_VREF;
	DS85x8Info->configRegister.RANGE_D = RANGE_D_4_VREF;
	DS85x8Info->configRegister.READ_EN = READ_EN_CONFIG;
	DS85x8Info->configRegister.REFBUF = REFBUF_ENABLE;
	DS85x8Info->configRegister.REFDAC = REFDAC_3_0V;
	DS85x8Info->configRegister.REF_EN = REF_EN_ENABLE;
	DS85x8Info->configRegister.STBY = STBY_DISABLED;
	DS85x8Info->configRegister.VREF = VREF_3_0;
	DS85x8Info->configRegister.WRITE_EN = WRITE_EN_CONTENT_UPDATE_DISABLED;



	//WAIT OR WHATEVER AND CLOCK STUFF...
	//CHIP SELECT AND WR* LOW
	Nop();
	Nop();
	Nop();
	Nop();
	Nop();
	Nop();
	Nop();
	Nop();
	Nop();
	CS_LAT = 0;
	RD_LAT = 1;
	WR_LAT = 0;
	Nop();
	Nop();
	Nop();
	Nop();
	Nop();
	Nop();
	Parallel_IO_Write((DS85x8Info->configRegister.wholeRegister & 0xFFFF0000) >> 16);
	Nop();
	Nop();
	Nop();
	Nop();
	Nop();
	Nop();
	Nop();
	WR_LAT = 1;
	Nop();
	Nop();
	Nop();
	Nop();
	Nop();
	Nop();
	WR_LAT = 0;
	Nop();
	Nop();
	Nop();
	Nop();
	Nop();
	Nop();
	Parallel_IO_Write((DS85x8Info->configRegister.wholeRegister & 0x0000FFFF));
	Nop();
	Nop();
	Nop();
	Nop();
	Nop();
	Nop();
	CS_LAT = 1;
	WR_LAT = 1;
	Nop();
	Nop();
	Nop();
	Nop();
	Nop();
	Nop();
	CS_LAT = 0;
	RD_LAT = 0;
	Nop();
	Nop();
	Nop();
	Nop();
	Nop();
	Nop();
	Nop();
	//response.wholeRegister = 0;
	//response.wholeRegister |= (Parallel_IO_Read() << 16);
	RD_LAT = 1;
	Nop();
	Nop();
	Nop();
	Nop();
	Nop();
	Nop();
	Nop();
	Nop();
	RD_LAT = 0;
	Nop();
	Nop();
	Nop();
	Nop();
	Nop();
	Nop();
	Nop();
	Nop();
	//response.wholeRegister |= (Parallel_IO_Read());
	RD_LAT = 1;
	CS_LAT = 1;



	//Do a read here to check that the config register is correct.

	passedInfoStruct = DS85x8Info;
	return(EXIT_SUCCESS);
}

/**
 * @brief Get sampled data from ADC with current configuration.
 * @return Updates ADS85x8_Info with current information and sets newData to 1.
 */
void ADS85x8_GetSamples(void)
{
	//Note this is set up for UART capture.
	CS_LAT = 0;

	//Channel A0 read.
	RD_LAT = 0;
	Nop();
	passedInfoStruct->sampledDataChA0 = Parallel_IO_Read();
	Nop();
	Nop();
	RD_LAT = 1;
	Nop();
//
//	//Channel A1 read.
//	RD_LAT = 0;
//	Nop();
//	passedInfoStruct->sampledDataChA1 = Parallel_IO_Read();
//	Nop();
//	Nop();
//	RD_LAT = 1;
//	Nop();
//
//	//Channel B0 read.
//	RD_LAT = 0;
//	Nop();
//	passedInfoStruct->sampledDataChB0 = Parallel_IO_Read();
//	Nop();
//	Nop();
//	RD_LAT = 1;
//	Nop();
//
//	//Channel B1 read.
//	RD_LAT = 0;
//	Nop();
//	passedInfoStruct->sampledDataChB1 = Parallel_IO_Read();
//	Nop();
//	Nop();
//	RD_LAT = 1;
//	Nop();
//
//	//Channel C0 read.
//	RD_LAT = 0;
//	Nop();
//	passedInfoStruct->sampledDataChC0 = Parallel_IO_Read();
//	Nop();
//	Nop();
//	RD_LAT = 1;
//	Nop();
//
//	//Channel C1 read.
//	RD_LAT = 0;
//	Nop();
//	passedInfoStruct->sampledDataChC1 = Parallel_IO_Read();
//	Nop();
//	Nop();
//	RD_LAT = 1;
//	Nop();
//
//	//Channel D0 read.
//	RD_LAT = 0;
//	Nop();
//	passedInfoStruct->sampledDataChD0 = Parallel_IO_Read();
//	Nop();
//	Nop();
//	RD_LAT = 1;
//	Nop();
//
//	//Channel D1 read.
//	RD_LAT = 0;
//	Nop();
//	passedInfoStruct->sampledDataChD1 = Parallel_IO_Read();
//	Nop();
//	Nop();
//	RD_LAT = 1;
//	Nop();

	passedInfoStruct->newData = 1;

	CS_LAT = 1;
	Nop();
	Nop();
	Nop();
	Nop();
}
