FrauBluher/ShR2/ESP8266/ESP8266_SDK/sead_wifi_PROJECT/user/cgiwifi.h

#ifndef CGIWIFI_H
#define CGIWIFI_H

#include "httpd.h"

int cgiWiFiScan(HttpdConnData *connData);
void tplWlan(HttpdConnData *connData, char *token, void **arg);
int cgiWiFi(HttpdConnData *connData);
int cgiWiFiConnect(HttpdConnData *connData);
int cgiWifiSetMode(HttpdConnData *connData);
//constant timer checking to see if we have an IP address while in AP mode
void resetTimerCb(void *);

#endif
