FrauBluher/ShR2/Hardware/PIC32 Based Hardware/DAQ/ADC Driver Code/SEAD_DAQ_v2.0c_Power/SB_Computation.h

/**
 * @file	SB_Computation.h
 * @author 	Henry Crute
 * @date	February 2015
 * @brief 	Provides methods to do computations on type SampleBuffer
 */

#ifndef SB_COMPUTATION_H
#define	SB_COMPUTATION_H

#include "DMA_Transfer.h"

uint32_t SB_RMS(SampleBuffer *);
int32_t SB_AVG(SampleBuffer *);
uint32_t SB_VOL(void);

#endif	/* SB_COMPUTATION_H */
