FrauBluher/ShR2/(commit log)

2014-03-05 Initial commit, sans cape and board design.
2014-03-10 Added correct footprints for cape work. ADCs need to be re-evaluated.
2014-03-10 Added schematic capture and board layout files.
    [NILMCape.brd, NILMCape.sch]
2014-03-14 Added Frequency Response
    [NILMCape.brd, NILMCape.sch]
2014-04-02 Finished Filtering Stage
2014-04-04 Split rail work, finished filtering stage.
    [NILMCape.brd, NILMCape.sch]
2014-04-05 More schematic capture work.
    [NILMCape.brd, NILMCape.sch]
2014-04-10 More Schematic Capture
    [NILMCape.brd, NILMCape.sch]
2014-04-12 Made a quick LDO board for testing.
    [CapePowerSupplyModule.brd, CapePowerSupplyModule.sch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]
2014-04-19 Added ADC and Split Rail breakout boards.
    [ADCBreakout.brd, ADCBreakout.sch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]
2014-04-25 Turned ADC breakout into ADC module
    [ADCBreakout.brd, ADCBreakout.sch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]
2014-04-27 Started writing ADC driver and acquisition code for PIC32MX795F512L
    [ADCModule.brd]
2014-04-27 More work on the ADC driver. Finished the parallelIO library.
2014-04-28 Added SPI DMA transfer code. Needs documentation and testing.
    [ADCBreakout.brd, ADCBreakout.sch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]
2014-04-29 Changed a few things on the ADC Breakout module.
2014-05-02 Got DMA ping-pong working.
2014-05-04 Got FSM working transferring dummy data. Absolute maximum over UART is ~15kHz worth of data for 8 channels.
    [ADCModule.GBL, ADCModule.GBO, ADCModule.GBS, ADCModule.GTL, ADCModule.GTO, ADCModule.GTS]
2014-05-07 Changed the ADC Module board for boardrouter considerations.
    [ADCModule.brd, ADCModule.sch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]
2014-05-07 ADC Module layout work.
2014-05-07 Added new gerbers for boardrouter.
    [ADCModule.brd, ADCModule.sch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]
2014-05-08 Finished ADC module changes for board run.
    [ADCModule.sch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]
2014-05-08 Finished ADC Module v1.2 and reorganized file directories.
    [ADCBreakout.brd, ADCBreakout.sch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]
2014-05-09 DAQ is now logging voltages in CSV format over USB.
2014-05-13 Started SPI/USB Bridge
    [ADCModule.brd, ADCModule.sch]
2014-05-14 Added new filtering scheme.
2014-05-14 Finished new analog filtering simulation
2014-05-17 Finished DAQ Hardware v1.4 and Filtering Simulations
    [ADCModule.brd, ADCModule.sch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]
2014-05-18 New filtering scheme with simulations and board layout for prototyping.
    [FilterBoard_+-8V_MAX.brd, FilterBoard_+-8V_MAX.sch]
2014-05-20 Finished new filter board prototype.
    [FilterBoard_+-8V_MAX.brd, FilterBoard_+-8V_MAX.sch]
2014-05-23 Added gerbers for filtering board
    [FilterBoard_+-8V_MAX.GBL, FilterBoard_+-8V_MAX.GBO, FilterBoard_+-8V_MAX.GBS, FilterBoard_+-8V_MAX.GTL, FilterBoard_+-8V_MAX.GTO, FilterBoard_+-8V_MAX.GTS]
2014-05-29 Fixed -V switcher on filtering board.
    [ADCModule.brd, FilterBoard_+-8V_MAX.brd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]
2014-06-05 Filtering Circuit v1.6
    [FilterBoard_+-8V_MAX.brd, FilterBoard_+-8V_MAX.sch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]
2014-06-27 DAQ and BBB now talking and capturing data
    [ADCModule.sch, FilterBoard_+-8V_MAX.sch]
2014-07-10 Updated README with parseADC info.
    Added building and usage information regarding parseADC and it's usage with raw sampled data.
2014-08-03 Fixed data corruption problem.
    [ADS85x8.c, DAQ.c, DMA_Transfer.h]
2014-10-13 Compute board brd/brd skt/plg model.
2014-10-13 More compute unit work.
    [ADCModule.brd, ADCModule.sch]
2014-10-15 Compute module clock sources.
    [ADCModule.brd, ADCModule.sch]
2014-10-16 Layout work.
    [ADCModule.brd, ADCModule.sch]
2014-10-16 More board layout work.
    [ADCModule.brd]
2014-10-20 More layout work.
    [ADCModule.brd, ADCModule.sch]
2014-10-29 Finished DAQ revision.
    [ADCModule.brd, ADCModule.sch]
2014-10-31 Started ADC Hat. Library additions.
    [ADCModule.brd, ADCModule.sch]
2014-10-31 Now tracking AFE Hat files.
    [Hat_MCP3912.brd, Hat_MCP3912.sch]
2014-11-03 More board work.
    [ADCModule.brd, Hat_MCP3912.brd, Hat_MCP3912.sch]
2014-11-11 Started quick PS.
    [ADCModule.brd, Hat_MCP3912.brd]
2014-11-11 Started quick PS1.
    [ADCModule.GBL, ADCModule.GBO, ADCModule.GBS, ADCModule.GKO, ADCModule.GTL, ADCModule.GTO, ADCModule.GTS, Hat_MCP3912.GBL]
2014-11-11 Finished quick power supply.
    [Split12VoltForTesting.brd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]
2015-01-07 Organized folders.
    [ADCBreakout.brd, ADCBreakout.sch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]
2015-01-08 Added F28377D pinouts and schematics
2015-01-09 SPI Issues Resolved
2015-01-09 SPI Work
2015-01-09 added the esp8266 webserver, as well as the heatshrink library they use
2015-01-10 added heatshrink
2015-01-11 Fixed endianess and verified configuration of mcp3912.
    [DMA_Transfer.c, MCP391x.c]
2015-01-11 DMA SPI work.
2015-01-12 Reordered DMA and MCP3912 Init Code.
2015-01-12 Webserver: fix syntax error
    [views.py]
2015-01-12 Webserver: revert uwsgi automatic restart (permission issues)
    [views.py]
2015-01-13 Some SolidWorks.
    [026013116.SLDPRT, 039012060.SLDPRT, CTAssem.SLDASM, CTBlock.SLDPRT, CTTorus.SLDPRT, CaseScrews.SLDPRT, Electrical_10-CTAssem.sldasm, Electrical_14-CTAssem.sldasm]
2015-01-13 Added Project Files subfolder and budget
    [281-budget.xlsx]
2015-01-13 ESP8266: Change the wifi link into a button
2015-01-13 ESP8266: Better button functionality
2015-01-14 added uart project
2015-01-15 DMA, SPI, UART progress. DAQ Control.
2015-01-17 Added nmea protocol library, changed the transmit data to output what it is sending to standard UART
2015-01-17 Webserver: pseudo data script: changed resolution from second to millisecond
2015-01-17 added files to start on the uart receive, and wifi transmission fsm
2015-01-17 More 3D renders.
    [AC_DC.SLDPRT, BODY_MTC20.sldprt, BODY_MXA28A.sldprt, BODY_TS5B.sldprt, BODY_VEH64A.sldprt, BODY_VNG144A.sldprt, CTAssem.SLDASM, Case Trim.SLDPRT]
2015-01-19 More 3D Work.
    [430250600.SLDPRT, 874380543.SLDPRT, 874390500.SLDPRT, AC_DC.SLDPRT, Assem1.SLDASM, CTTorus.SLDPRT, Cable_1-CaseAssembly.sldasm, Cable_3-CaseAssembly.sldasm]
2015-01-20 ESP8266: added radio buttons to group
2015-01-21 Added DMA CRC to DAQ.
2015-01-21 added uart buffer and circular send buffer datatype structs
2015-01-21 fixed delayed storing on rx
    [send_recv_port.c]
2015-01-21 added buffers with two semiphores, yet to implement swapping! solidified state machine
    [buffers.c, buffers.h, send_recv_port.c, send_recv_port.h]
2015-01-22 added popping and pushing from circular buffer, and uart buffer swapping in main state machine
    [buffers.c, buffers.h, send_recv_port.c]
2015-01-22 Webserver: improved debug flow
2015-01-22 Not sure why getting text unable to fit compiling errors, but I think there isn't enough memory to map it in the current way. looking into this
    [buffers.c, buffers.h, nmea0183.h, send_recv_port.c, user_main.c]
2015-01-22 Updated base project to mirror UART data with interrupts
2015-01-23 Webserver: created device pairing functionality: updated model fields, created api, generated html forms
2015-01-24 DAQ FIFO on D2XX drivers working.
2015-01-26 Webserver: fixed: pairing key was changing on every device update
    [models.py]
2015-01-27 removed the LED IO configuration and added some library files I wrote on the previous project.
2015-01-27 Webserver: Fixed the workflow for a new user, made the dashboard require authentication
    [views.py]
2015-01-27 The sead wifi project compiles now, and I added different UART drivers than previously before. Not tested, hopefully the new uart drivers can start working
2015-01-27 Merge branch 'master' of https://github.com/FrauBluher/ShR2
    Conflicts:
    ESP8266/ESP8266_SDK/uart_rxtx_PROJECT/bin/eagle.app.v6.flash.bin
    ESP8266/ESP8266_SDK/uart_rxtx_PROJECT/bin/eagle.app.v6.irom0text.bin
2015-01-28 trimmed code a bit, successfully replaced uart
    [buffers.c, nmea0183.c, nmea0183.h, send_recv_port.c, uart.c, user_main.c]
2015-01-28 ESP8266: Removed unused code and disabled heatshrink library
2015-01-28 ESP8266: Deleted heatshrink files, removed heatshrink as dependency from Makefile
2015-01-28 Revert "ESP8266: Deleted heatshrink files, removed heatshrink as dependency from Makefile"
    This reverts commit 4ff589883c79b56b416bc8e64779dfbbbfb27e8c.
2015-01-28 fixed uart
2015-01-28 Revert "ESP8266: Removed unused code and disabled heatshrink library"
    This reverts commit 13b930d3d8ab984fe59c18b7a891d080f9139a00.
    [httpd.c, user_main.c]
2015-01-29 Added sample ADC code
2015-01-30 Fixed minor bugs with the circular sending buffer. TODO: establish tcp connection, and send data, then close the tcp connection
    [buffers.c, buffers.h, nmea0183.c, nmea0183.h, send_recv_port.c, send_recv_port.h, uart.c]
2015-01-31 Webserver: Changed device primary key from AutoField() to device.serial, can now be referenced by /api/device-api/<serial>
2015-02-03 added code to look at getting some sort of current unix timestamp
2015-02-04 Created new Power calculations project for the pic32, and reformatted the structure of some of my notes for the ESP
2015-02-06 Modified sample rate on daqv2 for RMS. added continuous connection establishment on the esp
2015-02-10 Webserver: modified fanout queries on device creation
2015-02-10 Update ADCModuleBoard.c
    Fixed Blinking LED.
    [ADCModuleBoard.c]
2015-02-10 Update ADCModuleBoard.c
    Fixed the blinking LED.
    [ADCModuleBoard.c]
2015-02-12 changed esp wifi state machine and added computation code for the SampleBuffer s
2015-02-13 Fixed circular buffer dangling tail issues
    [buffers.c, buffers.h]
2015-02-13 Webserver: Overrode delete method for devices such that events and continuous queries will clear from the database
2015-02-13 Webserver: Deprecated zipcode and private field on device. Got API key for Google Maps
2015-02-13 Added truerms calculation framework
2015-02-18 Fixed buffering and added channel specific RMS
    [DAQ.c, SB_Computation.c]
2015-02-18 Webserver: added Google Maps API to Add Device workflow on dashboard
2015-02-18 Added offset calibration and gain calibration to configuration of the ADC. Modified the RMS function to return the sum of all points over the two cycles, instead of RMS for calibration purposes.
2015-02-19 Webserver: Added features to account settings form and status to device settings form
2015-02-19 Fixed byte shifting, calibrated the offset for the average of noise and any measurement very close to zero.
    [DAQ.c, MCP391x.c, SB_Computation.c, SB_Computation.h]
2015-02-19 Webserver: Added fieldsets to settings forms, broke up buttons and added minimal functionality
    [views.py]
2015-02-20 added PGA logic and voltage differential translation code for bin size on the MCP
2015-02-22 Webserver: Moved the add-device modal from the dashboard to settings
2015-02-26 Webserver: fixed autocomplete results in device modal
2015-02-26 Changed gain to 0. Verified that the RMS calculation is correct. We are still off by a factor for the calculation. Had to commit stupid binary and production map, can't change back.
    [DAQ.c, MCP391x.c, MCP391x.h, SB_Computation.c, SB_Computation.h]
2015-02-26 Webserver: Added geoposition field to device model, finished the Add Device workflow
2015-02-26 Webserver: Added dynamic fields to device settings group in form and admin interface
2015-02-26 Added secret scalar calibration value.
2015-02-28 Webserver: added api endpoint to get server time in milliseconds at /api/timestamp/
2015-02-28 Added CT Excitation Circuit.
    [CTExciter.brd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]
2015-03-02 Webserver: Device settings page will now use the select device dropdown
2015-03-03 Minor changes with esp message formatting, need to fix it for working with Bryan's SSL https encryption
    [buffers.h]
2015-03-04 Modified config struct, and added code to send it over initially. Currently just sending the struct with default config already there.
2015-03-04 Webserver: Added map on dashboard to unify all devices. Can now change devices on graph.
2015-03-05 added proper verbose printing for config
2015-03-05 Webserver: Added voltage and current fields to event-api
2015-03-07 Webserver: created script to mimick the api behavior of a device
2015-03-07 Webserver: fixed minor bug on settings page relating to device status
    [views.py]
2015-03-07 Webserver: Added aggregate query for total average of device. Implemented api to call average
2015-03-09 Board layout work.
    [ADCModule.brd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]
2015-03-11 Webserver: Serving average wattage per device on dashboard template
2015-03-12 Added communication via UART
2015-03-12 fixed include, wouldn't compile before
    [buffers.c]
2015-03-13 Added milliamps conversion for the output data, instead of bins.
2015-03-13 Fixed a buffer overflow
    [main.c]
2015-03-13 They call me scoobie doo, because I solved the mystery of amperage values not being correctly scaled. The PGA was messing it up.
    [main.c]
2015-04-05 Webserver: added button to collapse/expand map on dashboard
2015-04-09 Webserver: added ip_address field to devices
2015-04-09 Webserver: custom create methods to track IP of request
2015-04-09 added voltage scalar on acquire script
2015-04-13 Fixed Scaling for voltage on DAQ.
    [main.c]
2015-04-13 fixed file header comment filename
    [daq_config.h, main.c]
2015-04-14 fixed compiling, frequency and bandwidth digressions. Also fixed calculations for bandwidth and frequency.
    [main.c]
2015-04-15 Webserver: fixed realtime function and timestamp offsetting, as well as stacked/unstacked chart functionality
    [models.py, views.py]
2015-04-20 Added a variable to possibly add configurations to the sending timer
2015-04-23 Webserver: Reworked circuit relation to device, added circuit pagination to dashboard
    [admin.py, models.py, views.py]
2015-04-23 Webserver: updated debug interface to save to circuits
2015-04-23 Webserver: Added chart breakdown by circuit to dashboard viz
2015-04-23 Increased sending frequency, modified python pseudata test to push the wifi chip to the limit. Succeeds with 40Hz input data. Changed sending data to be mallocced.
2015-04-24 changed some sending buffers to minimize the use of memory. Still capped at 40Hz for the moment for sending data.
2015-04-28 Webserver: device gets a settings object when instantiated
2015-04-28 Webserver: modifications to circuit relation to device, exposed to user via settings
2015-04-28 Webserver: added functionality to change circuittype on settings
2015-04-30 Cleaned up settings for users with no devices
2015-04-30 Added gerbers and layouts.
    [ADCModule.brd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]
2015-04-30 Webserver: fixed adding device workflow
    [models.py, views.py]
2015-05-05 Added rest code for device, NOTE: currently DMA0 only will run once so this does not work properly
    [ADCModuleBoard.c, DMA_Transfer.c, main.c]
2015-05-05 Webserver: influxdb inserting milliseconds
2015-05-05 Webserver: dashboard compatible with millisecond timestamps
2015-05-05 Added current timestamp field to settings object, updated on get request
2015-05-05 New users have an automatic prompt for device pairing
2015-05-07 Webserver: pair device by serial instead of secret key
2015-05-07 Webserver: share with field added to settings page and device model, rate plan and territory now hold meaningful data
2015-05-10 Webserver: framework for command to archive database on given interval
2015-05-11 Webserver: Added data retention policy to device model
2015-05-12 Webserver: Various fixes and improvements, most notably cost per device and sharing
    [models.py, views.py]
2015-05-12 Webserver: Modified status dropdown to show multiple devices
2015-05-13 Updated uart message notes with microstamp
2015-05-13 Updated pseudata script to handle millisecond accuracy instead of only seconds
2015-05-13 Changed nmea to support 64 bit timestamp (millisecond accuracy reliably)
2015-05-14 Added logic to handle config from the server. This is correctly handled every time the ESP starts.
    [send_recv_port.c, send_recv_port.h]
2015-05-14 Webserver: Logic to workaround bug #510 in influxdb to backfill historical data
    [models.py]
2015-05-14 Webserver: Added adc sample rate field to device settings
2015-05-14 Webserver: set permissions on devices with share_with attribute
2015-05-14 Webserver: Update current usage when chart gets new data
2015-05-14 Webserver: Links to devices now update dashboard
2015-05-20 Webserver: converted chart partition by appliance to circuit
2015-05-21 Fixes timing issues, uses configuration from ESP, window synched to 60Hz for OSR of 5
    [ADCModuleBoard.c, DMA_Transfer.c, DMA_Transfer.h, MCP391x.c, MCP391x.h, SB_Computation.c]
2015-05-21 Webserver: more dashboard fixes and performance tweaks
    [models.py, views.py]
2015-05-21 Fixed malloc fragmentation for the device. Static buffers, sleek configuration as well as device creation.
    [buffers.h, nmea0183.c, pseudodata.py, send_recv_port.c]
2015-05-25 Revert "Webserver: updated database lookups to reference remote URI"
    This reverts commit 87172ffcc0d8a970992b90179c77fcad500e217f.
    [models.py, views.py]
2015-05-25 Webserver: reverted html changes
    [models.py, views.py]
2015-05-26 changed window size for 1Hz
    [SEADLight.brd]
2015-05-26 Webserver: Updating auxiliary charts when dashboard changes devices
2015-05-26 Webserver: various dashboard and data model fixes
    [models.py, views.py]
2015-05-27 Should have done this a while ago, fixes potential corruption issues
    [DMA_Transfer.h, SB_Computation.c]
2015-05-27 Webserver: keep track of daily cost for fast lookup
2015-06-03 Webserver: fixed settings module lookups
    [views.py]
2015-06-04 Webserver: Various fixes for stateless machine. Also simplified pseudodevice script for demo.
    [models.py, views.py]
2015-06-04 Webserver: hotfix for database continuous query bug
    [models.py]
2015-06-04 Changed debug print statements. initiate different callbacks based on what wifi opmode we are in. changed timestamp we are storing to a 32 bit integer
2015-06-04 Webserver: changed device settings defaults and addressed null return on view
2015-06-05 Webserver: addressed charting timestamp mismatch and dashboard synchronization issues
    [views.py]
2015-06-08 Webserver: fixed realtime button nuances
