FrauBluher/ShR2/(notices)

Notices in the files:
ESP8266/ESP8266_SDK/sead_wifi_PROJECT/user/uart.h:
This program is free software: you can redistribute it and/or modify
it under the terms of version 3 of the GNU General Public License as
published by the Free Software Foundation.
Hardware/PIC32 Based Hardware/Filtering/FilterBoard_+-8V_MAX.brd:
(c) 2014 Pavlo Manovi
